sharebrained/portapack-hackrf/README.md

# portapack-hackrf

**NOTE: This original firmware for the PortaPack H1 was forked into the [Mayhem project](https://github.com/eried/portapack-mayhem), which is now far more interesting and active. I recommend you use that firmware for all your PortaPacking needs. This repository is hereby archived.**

The PortaPack H1 makes the [HackRF One software-defined radio](http://greatscottgadgets.com/hackrf/) portable. It adds an LCD touchscreen, user interface navigation controls, audio output and input, micro SD card slot, 2.5 PPM crystal oscillator, and real-time clock battery backup. The PortaPack firmware provides a user interface and necessary signal processing to do many useful things without a computer.

Visit the [wiki](https://github.com/sharebrained/portapack-hackrf/wiki) for more details.

Hardware was once available from [ShareBrained Technology](http://sharebrained.com/). But now there are many manufacturers, vendors, and variations of this open-source hardware. I have not used any of them myself, so can't offer any specific recommendations.

PortaPack H1 in operation
PortaPack H1 kit components

# License

Except where specified in subdirectories of this project, all work is offered under the following license:

Copyright (C) 2013-2019 Jared Boone, ShareBrained Technology, Inc.

This program is free software; you can redistribute it and/or
modify it under the terms of the GNU General Public License
as published by the Free Software Foundation; either version 2
of the License, or (at your option) any later version.

This program is distributed in the hope that it will be useful,
but WITHOUT ANY WARRANTY; without even the implied warranty of
MERCHANTABILITY or FITNESS FOR A PARTICULAR PURPOSE.  See the
GNU General Public License for more details.

You should have received a copy of the GNU General Public License
along with this program; if not, write to the Free Software
Foundation, Inc., 51 Franklin Street, Fifth Floor, Boston, MA
02110-1301, USA.

# Contact

Jared Boone <jared@sharebrained.com>

ShareBrained Technology, Inc.

<http://www.sharebrained.com/>

The latest version of this repository can be found at
https://github.com/sharebrained/portapack-hackrf/
