sharebrained/portapack-hackrf/(threads)

Thread 10 (2015-07-08):

Retain settings when power is disconnected

jboone, 2015-07-08:
Write data to RTC battery backed RAM (simple but limited storage), or to SD card (not so simple, risky).

jboone, 2015-07-09:
Of course, there may be no SD card, it may be non-functional, or ejected at any time. So solving the problem with the RTC RAM is preferred, even though it's tiny (8Kbytes, I believe).

aernan, 2015-08-02:
oh. whoops.

jboone, 2015-08-24:
Lesson learned: there's only 256 *bytes* of RAM ("REGFILE") at 0x40041000, as part of the RTC peripheral, that is maintained when power is removed from the PortaPack. Still, that's plenty to store important state, if done carefully.

jboone, 2015-08-24:
Code to use RTC REGFILE for tuning frequency and PPM value seems to be working well. Closed, though the implementation could use improvement, e.g. versioning the persistent data and clearing or migrating the data when the version ID is incremented.

Closed 2015-08-24.

Thread 2 (2015-07-08):

Improve firmware update experience

jboone, 2015-07-08:
Especially for Windows, but other platforms could use more love, too.

KC5CQW, 2015-08-26:
Not much luck here compiling from src on OS X...

jboone, 2015-08-26:
Can you provide details? I am developing on OS X 10.10.5, so it *should* work just fine.

KC5CQW, 2015-08-26:
I couldn't get the ARM compiler to instal on my X.9 system.

jboone, 2015-08-26:
OK, moving this to new issue #60. Please follow up with more details there.

jboone, 2015-09-03:
HackRF Mode in the new firmware will help a bit with this, eliminating the need for DFU mode except in dire circumstances where the firmware on the device is non-functional.

jboone, 2015-10-22:
[Windows firmware tool](https://github.com/sharebrained/portapack-hackrf/wiki/Updating%20Firmware%20Windows) is now available.

Closed 2015-10-22.

Thread 3 (2015-07-08):

Fix MAX2837 RSSI sampling

jboone, 2015-07-08:
It seems I broke the MAX2837 RSSI sampling by the LPC4320 ADC.

Closed 2015-07-08.

Thread 4 (2015-07-08):

Add touch screen calibration

jboone, 2015-07-08:
During manufacturing, touch screens seem pretty consistent (don't need calibration), but PortaPacks might "feel" better to use if the touch screen was precisely calibrated.

KC5CQW, 2016-05-18:
This would be needed if stylus or gesture support is implemented some day. Perhaps some type of scalable waterfall zoom.

jboone, 2016-07-28:
Implemented in commit 24fa97439d7ca9524f892e5b41996d3a39695649.

Jean-france, 2020-02-02:
Hi,
I have HAVOC firmware  on my HK. The touch screen doesn't work. Impossible to calibrate it, nothing do even i touch the screen.
Do you have a idea ?
Many thanks in advance.
Best regards,
Jean

Closed 2016-07-28.

Thread 5 (2015-07-08):

Improve power consumption

jboone, 2015-07-08:
Review LPC4320 peripherals and clocks that can be shut down because they aren't in use.
Check that peripherals are turned off if they're not used for a while (e.g. SD card).
Review ChibiOS code, ensure LPC4320 cores are sleeping when they can.
Align interrupts, threads to reduce the number of interrupts. Particularly on the baseband processor, where RSSI/touch sampling blocks can be aligned with baseband sampling. This will also help align timestamps between RSSI and baseband sample.

JDogHerman, 2015-08-06:
Would it be possible to turn off the backlight of for the screen to save power?

KC5CQW, 2015-08-06:
And maybe a dim adjustment feature for when full brightness is not needed.

jboone, 2016-01-28:
Added display sleep mode, which drops power by 60-70mA measured the 5V USB input. Lots more possibilities, including stopping spectrum calculation and various baseband/RSSI/audio/process stats, which is wasted effort when display is not on.

Thread 6 (2015-07-08):

Wideband spectrum analysis

jboone, 2015-07-08:
Add mode to sweep the radio across a frequency range, capture baseband, either FFT or calculate average/peak power, and record/display.

aernan, 2015-08-02:
Would be excellent to use device like a scanner. Search across a very wide band to find signals. Would be fine if single pass simple drew a DB to frequency graph.

jboone, 2015-08-27:
Addressed as of commit 3fea68d777c553b9523cbae41d89160ce428c676. For now, a separate receiver mode. Will refine as time goes on.

Closed 2015-08-27.

Thread 7 (2015-07-08):

Digital modes

jboone, 2015-07-08:
Break out digital demodulation/decoding into a separate mode?

aernan, 2015-08-02:
I could see workflow of scanning bands to find a signal. Zooming in to see the signal then attempting different demodulation techniques. If you can't easily demodulate then capture for offline demodulation.

jboone, 2015-08-02:
aernan: That's exactly what I was hoping to accomplish. Right now, I'm imagining a zoom button that would toggle between channel bandwidth and maximum (20MHz) bandwidth. Demodulation would be suspended and audio muted during the 20MHz mode, while you identify a signal of interest and retune for it. Then, you'd zoom back in to the channel and demodulation/audio would resume.

aernan, 2015-08-02:
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
That sounds perfect. I would totally eat that up.

KC5CQW, 2015-08-05:
Clarification; is digital demodulation to take place "off-board"? This would indeed be quite taxing and processor intensive for local display...
Yes, I would also utilize the zoom/tune feature.
Hmm, that gives me an idea... What about an Auto Frequency Correction with a marker icon or +/- Hz/kHz delta for tracking a drifting signal? This would be focused on the carrier or peak amplitude components of the signal.

aernan, 2015-08-06:
To clarify. I'm guessing some forms of digital signals are too complex to demodulate on the portapack. Things like GSM and Wifi. So if you can't (due to horsepower) then make it easy to capture them so you can then use another host (desktop/laptop) to do the heavy lifting. For everything else do best effort to demodulate on the portapack.

JDogHerman, 2015-08-06:
It would be nice to have a decoder of some basic digital modes on-board. DTMF, RTTY, CW, PSK31

JDogHerman, 2015-08-06:
Or maybe decode WFM HD RDM signals.

KC5CQW, 2015-08-06:
Being Linux based, I wonder if the HackRF/PP H1 could utilize some of the fldigi source.
http://www.w1hkj.com/usercontrib/FLDG-2013-10-01-2111.zip

jboone, 2016-07-05:
@KC5CQW You're no doubt aware of this by now, but the HackRF and PortaPack are not capable of running Linux -- there's far too little RAM (200K) to consider such a thing.

jboone, 2016-07-05:
This issue wound up becoming very broad. Moved digital mode ideas to issue #89. Zoom out idea moved to issue #90. Spectrum peak marker moved to issue #91.

Closed 2016-07-05.

Thread 8 (2015-07-08):

Implement internal temperature monitoring

jboone, 2015-07-08:

aernan, 2015-08-02:
Do I need to put a heatsink/fan on the HackRF or the Portapack chips?

jboone, 2015-08-02:
No, this temperature monitoring is intended to automatically compensate for crystal reference frequency drift as the radio hardware warms up.

aernan, 2015-08-02:
ok excellent. That’s a good heads up before I leave the unit on for any time.

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

jboone, 2016-01-05:
Temperature monitoring is now functioning. Will need further UI and supporting code to automatically adjust crystal reference frequency PPM offset based on current temperature.

Part of the problem is that temperature resolution is poor, so it's hard to interpolate values and make smooth PPM adjustments.

KC5CQW, 2016-02-03:
Where is the sensor? No joy if it's inside the CPU and not near the LO.
It might be necessary to epoxy a thermistor to the xtal body and feed the leads into a pair of unused GPIO holes. One of the glass-bodied, high resolution types used in 3D printer hot ends would work well here. These are very well documented for linearizing the output of the thermistor within code for accuracy. Fine wire soldering and polymeric application will be required...

Additionally, if an external reference signal is applied, this temperature compensation MUST be ignored.

jboone, 2016-02-03:
@KC5CQW The sensor is located in the MAX2837, the second IF chip. It's not an ideal location, but with the thermal mass of the circuit board, it seems to track OK. What doesn't work so well is that the MAX2837 temperature sensor has a resolution of 5C. This is barely enough to compensate for drift, so I'm unsure if it's actually worth completing the feature, or if I should just expect the user to manually calibrate PPM for when the unit is warmed up, which is what I'm doing now.

You're welcome to modify your hardware however you like. I fear almost nobody else will undertake such a modification. So I'm going to focus on doing it right in the next revision of the PortaPack. :-)

KC5CQW, 2016-02-03:
Nah, i'm good. I built a GPSDO for the clock input when high precision is needed. From what I've seen, the screen resolution is too coarse to resolve such small deviation. A better option would be to manually adjust the PPM then activate an AFC algorithm to track the RX carrier to compensate for minor fluctuations.
A new revision?! Dang, this is going to get expensive... I have a hard enough time justifying my R/C helicopter habit to my wife.

jboone, 2016-02-03:
@KC5CQW I definitely need AFC to improve sensitivity to signals transmitted significantly offset from my LO. This is particularly important for TPMS, where transmitters are very cheap and in an environment where temperatures vary widely, from -20C to 50C or more. But first thing's first.

And don't worry about a new revision. It'd be a whole new thing, and it's a long way off still -- I'd be amazed if I had anything together in a year.

KC5CQW, 2016-02-06:
I have an idea... What about a simple, small thermal health status indicator using this "rough" data. Perhaps just one or two pixels in a corner that changes color. Blue for cold, green for room(ish) temp and red for way too hot. Maybe a hysteresis of 10's of degrees for averaging.

73, Damon

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

jboone, 2016-02-17:
@KC5CQW The thermal sensor is located in the second IF chip and is purely about calibration. The sensor is not positioned or designed for monitoring system faults or throttling, unlike laptop/desktop processors. Besides, if the HackRF + PortaPack experienced a fault that produced considerable excess heat, either the onboard switching regulator or the USB power source would enter current limiting.

In a different system design, having CPU core temperatures would be useful, as would a thermal sensor with much more accuracy, co-located with the reference crystal/oscillator. Or, dispense with the thermal sensor and use a more accurate (<1ppm) crystal to begin with...

jboone, 2016-07-28:
After a few months of observation, I've concluded the temperature resolution of the MAX2837 is simply too coarse to implement automatic reference frequency compensation. Aggressive filtering of the coarse signal would still cause laggy and large swings in PPM offset, and would be worse than just leaving it manual. In practice, I find a PPM offset for each HackRF and leave it, as once a unit is warmed up (a few minutes), the PPM value is quite stable.

sck-nogas, 2016-07-28:
I know that I can use the Receiver mode to help tun the PPM offset, but I have not been able to identify much/any drift using WFM. So, as my dumb question of the day, should we only use NFM or AM to tune this?

jboone, 2016-07-28:
You won't see the offset in WFM mode, unless it's severe (and your HackRF crystal reference is way out of specification). Broadcast FM analog signals are ~260kHz wide, and the carrier is typically around 100 MHz. At 100 MHz, a 10 ppm offset would be 1 kHz, which would be very hard to see in the nearly 400 kHz WFM spectrum waterfall. A 1 kHz offset on such a wide signal is unlikely to affect demodulation significantly, so you wouldn't hear the effect, either.

NFM or AM is much better, as the signal and displayed bandwidth are far narrower, and it'll be easier to make fine adjustments. I usually adjust PPM whenever I see a need, and it's usually the same value, +/- 1 ppm, unless the transmitter I'm observing is very sloppy.

KC5CQW, 2016-07-28:
Would it be possible to add a "relative" 0 setting to the PPM once a HRF has thermally stabilized and compared to a freq. standard? For example, at 25C, +/- ~30deg. my HRF is -7PPM. I would like to set this value as a relative "0" to monitor when a recalibration is necessary and to perform frequency measurements.
This is useful for when I am unable to sync with my 10MHz master clock back in the lab when going portable.
73, Damon

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

KC5CQW, 2016-07-28:
Only an idle FM carrier will be on the target frequency. That means no modulation. CW is best then AM or LSB/USB for comparison.
Use of a NWS/NOAA broadcast in nFM is useful between modulated words.

73, Damon

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

sck-nogas, 2016-07-29:
Thanks!

Using NFM (after warming up for 10-15 mins of listening to the broadcast), I set my PPM to 11.

"Well, it's one louder, isn't it? It's not ten. You see, most blokes, you know, will be SDRing at ten. You're on ten here, all the way up, all the way up, all the way up, you're on ten on your HackRF. Where can you go from there? Where?... Eleven?" :)

http://www.imdb.com/title/tt0088258/quotes?item=qt0261726

jboone, 2016-07-29:
@sck-nogas I appreciate starting my day with a little 'Tap. Thanks. :-)

I am curious to know if a PPM offset of +11 continues to work well for you, as it is a bit out of spec in my experience. What kind of transmission did you calibrate to? Depending, the transmitter may not be very precise...

jboone, 2016-07-29:
@KC5CQW I like the idea... I've felt funny adjusting the PPM from within the receiver, like that's not really the place for it. However, I've also liked having that adjustment to fine-tune for a specific transmission.

So perhaps we rename the "PPM" inside the receiver mode to be "Fine", and if you press "select" on that value, you can update the global PPM value with the current "Fine" offset (and the Fine offset resets to 0). So perhaps we can have our cake (set PPM from receiver mode, where it's easiest), and eat it too (fine adjust the tuned frequency without messing up the global PPM value).

sck-nogas, 2016-07-29:
@jboone You are MOST welcome. Am loving the Portapack!

For the tuning of the PPM, I followed @KC5CQW 's suggestion and used the two closest (both about 10 miles LOS) NWS NOAA stations [KEC62](http://www.nws.noaa.gov/nwr/coverage/site2.php?State=CA&Site=KEC62) and [WNG637](http://www.nws.noaa.gov/nwr/coverage/site2.php?State=CA&Site=WNG637) to my house. Then using the PPM adjuster in Receiver mode, I changed the setting until the red carrier line (observable when there was no audio transmitted) was centered.

I then jumped around to a [few other NFM stations](http://www.radioreference.com/apps/db/?ctid=219)  to make sure they all were equally centered on carrier.

Thread 9 (2015-07-08):

Adjustment of tuned frequency based on oscillator drift

jboone, 2015-07-08:
The Si5351C-B oscillator will drift in frequency in a temperature-dependent manner. Take advantage of temperature measurement(s) available on the HackRF to adjust tuning frequency based on adjustment table of PPM vs. temperature. Update tuning frequency only if PPM value changes appreciably.

jboone, 2015-07-09:
First step would be to plumb the code for a static PPM, assuming the user will want the correction to be in effect once the hardware has warmed up.

Of course, until issue #10 is addressed, you'll need to re-enter the PPM value every time you power up. :-(

jboone, 2015-07-29:
Addressed in commit 67976b73bada3069038cc093f2d962631154dd99.

Closed 2015-07-29.

Thread 13 (2015-07-09):

Fix receiver mode frequency scale bars.

jboone, 2015-07-09:
They appear to be the wrong scale to depict the channel filter band edges.

jboone, 2015-07-20:
Confirmed correct scale with a signal generator.

Closed 2015-07-20.

Thread 14 (2015-07-09):

Label receiver waterfall frequency scale.

jboone, 2015-07-09:
Groundwork is laid, but need to finish the implementation.

jboone, 2015-07-21:
Resolved in commit 9a8552eaeb6a4516f2b708cf8219d41dce8e61d7.

Closed 2015-07-21.

Thread 19 (2015-07-09):

Indicate baseband saturation somehow

jboone, 2015-07-09:
Feedback on bad gain structure is always handy. Previously, I was using the red LED, but took that code out. This needs further/better thought.

The baseband code should be reviewed to see if saturation is flagged at all possible places. I feel like it's not...

KC5CQW, 2015-08-05:
Perhaps a rapid (4-5) PPS flash on the RX LED to indicate overloaded gain stages...?

KC5CQW, 2015-10-25:
I suppose blinking the LED associated with the overdriven 'stage' (TX/RX) is the proper method to avoid confusion. However... My understanding is that the USB LED is inert during PP H1 use. Perhaps it could be a general fault light.

Thread 27 (2015-07-26):

Establish version/release schedule, naming convention, location for binaries, etc.

jboone, 2015-07-26:
You know, proper build and release engineering...

ZeroChaos-, 2015-07-27:
suggestion:  two scripts that handle the firmware loading for the user.  "switch_to_portapack" and "switch_to_hackrf" would be naming suggestions.

ZeroChaos-, 2015-07-27:
suggestion: name your firmware with "portapack" in the title and install into /usr/share/hackrf just like the standard firmware, this gives users one location to search for firmware.

ZeroChaos-, 2015-07-27:
suggestion: use XZ instead of bz2, although for such small files it almost doesn't matter, but on principle XZ is vastly superior

ZeroChaos-, 2015-07-30:
for the scripts, I'm thinking something like this:

#!/bin/sh
dfu-util --device 1fc9:000c --download /usr/share/hackrf/hackrf_one_usb_ram.dfu --reset
hackrf_spiflash -w /usr/share/hackrf/portapack-h1-firmware.bin

#!/bin/sh
dfu-util --device 1fc9:000c --download /usr/share/hackrf/hackrf_one_usb_ram.dfu --reset
hackrf_spiflash -w /usr/share/hackrf/hackrf_one_usb_rom_to_ram.bin

I'm also thinking you need to rename your "hackrf_one_usb_ram.dfu" to something else unless it is the same as the file shipped by hackrf (in which case, stop shipping it at all).  Suggested name would be "portapack-h1_usb_ram_dfu" if it is different.

ZeroChaos-, 2015-07-30:
per discussion on irc, the hackrf_one_usb_ram.dfu is the same as shipped with hackrf and is shipped to make switching to portapack as simple as possible.

jboone, 2015-07-30:
Yep. If hackrf_one_usb_ram.dfu is already present on the system (packaged), feel free to use that copy. In fact, that's preferable to me. Including the .dfu is a shortcut for now, to make sure that you have everything necessary (aside from dfu-util and hackrf_spiflash) when you clone the repo.

jboone, 2015-07-30:
The scripts will work if dfu-util 0.7 is on the system. dfu-util 0.8 has some changes which have broken things. This needs to be addressed, but not right now. Issue #24 tracks that, as well as issue mossmann/hackrf#117.

jboone, 2015-07-30:
I do recall one issue with using the commands as shown in the scripts. The HackRF needs a bit of time to re-enumerate with the operating system after the dfu-util has finished. I would recommend a "sleep 1s" between dfu-util and hackrf_spiflash, to give the HackRF time to show up as a HackRF.

ZeroChaos-, 2015-07-30:
for this second, to make sure that I can push this to users soon, I'm going to leave the scripts with no real error handling and get them into gentoo.  later we can add some ugly checks like "dfu-util -V | head -n1 | awk '{print $2}'" to check dfu-util version and change args if needed, as well as possibly parsing lsusb to determine if the hackrf is even present at runtime.

jboone, 2015-07-30:
Huh, interesting. In my Makefile, I do not specify the product ID, just "--device 1fc9". The product ID in your scripts are correct and work and are more explicit.

jboone, 2015-07-31:
Instructions for entering DFU mode:
"Hold down the HackRF's DFU button (the button closest to the antenna jack) and plug the HackRF into a USB port on your computer. After the HackRF is plugged in, you may release the DFU button."

Thread 31 (2015-07-28):

Address mechanical incompatibility with HackRF Blue

jboone, 2015-07-28:

KC5CQW, 2015-08-06:
Mounting holes and/or header socket alignment constancy.
The socket variable is likely due to solder surface tension pulling the socket mass to equilibrium during reflow process.

jboone, 2015-08-06:
@KC5CQW I'm not sure if you're commenting on a separate issue, or sharing ideas for this issue. This issue relates to the (optional) presence of a header on the HackRF Blue that is not present on the HackRF One. Two electrolytic capacitors on the PortaPack H1 mechanically interfere with the HackRF Blue header. It is not related to the 0.1" SMT headers on the PortaPack, as they utilize alignment pins, and should be positioned to within a few mils of nominal.

KC5CQW, 2015-08-06:
Just sharing ideas... However, based on your input, I can say that by adding three washers in addition to the standoffs cured this problem for me. Enough of the pin length remained to make good contact within the socket headers. With the washers on hand and applied, I have about 0.2-0.4mm (estimated) clearance from the caps.
I own an "official" HackRF but added the P30 header as provided by Nooelec with the RF shield kit.
Sadly, it is not accessible with the H1 mounted. As an option, I suppose a right angled header would cure this. I forgot about the alignment pins... Good call using them in the design!

BTW, i know squat about software but RF hardware test/tune/calibration is my chosen Voo-Doo.
My wife and I are the PCB assemblers for the AMSAT FOX-1 series cubsats. My hope is to use the HackRF for post assembly smoke testing prior to shipping out the hardware for "real" tests and flight integration.

KC5CQW, 2015-09-05:
When the P30 header is installed (OEM or Blue), an additional 2.35mm of clearance is needed for a total of 14.25mm. I used 15 4-40UNC flat washers (3 on each screw) to provide the additional clearance between PCB's for the caps to clear the header. This setup WILL block access to the P30 header.
The other option is [for the end user] to source 2 ribbon cables 11 pin (P16) & 13 pin (P22) with one end male , the other female and >1" (25mm) long to allow for an offset mounting configuration between PCB's.

Thread 32 (2015-07-29):

Focus manager has ugly corner cases.

jboone, 2015-07-29:
argilo found a case where moving right from one field to another, both inhabiting the same vertical coordinate range, causes focus to move to the "nearest" field, which is *above* the original field!

jboone, 2015-08-24:
Short-term fix seems to be working nicely, so I'm closing this until some new issue arises.

Closed 2015-08-24.

Thread 33 (2015-07-29):

Means to adjust receiver channel bandwidth

jboone, 2015-07-29:
Should be easy enough to re-assign the FIR taps.
Adjust spectrum samples decimation factor to make sure aliasing is minimized.

aernan, 2015-08-02:
I could see this being like a zoom in out on the screen feature.

aernan, 2015-08-06:
You can adjust the squelch and receive bandwidth in this app.
android app RF Analyzer https://play.google.com/store/apps/details?id=com.mantz_it.rfanalyzer
probably do something similar.

jboone, 2016-01-05:
Plumbing is there as of commit 28be223ace91d6bac55dc468789ffa0de57904c4. (It took until this commit to get something that was compilable, due to a merge-oops.)

jboone, 2016-02-06:
NBFM channel filter can be varied between 8.5kHz, 11kHz, and 16kHz widths, with attendant adjustments to deviation (2.5 or 5k), as of commit ceef8d32d3b5da9a4faf7b98cad7ae677c63a600.

KC5CQW, 2016-05-05:
Please explain the deviation adjustments. Is this automatic or user variable?

jboone, 2016-07-05:
Closing this and continuing work on channel bandwidth adjustment for CW/AM/SSB via issue #86.

Closed 2016-07-05.

Thread 43 (2015-08-02):

Scrolling shows new row of pixels at bottom of region.

jboone, 2015-08-02:

jboone, 2015-08-11:
Shows many rows of pixels if scrolling many rows per LCD frame period. Stopgap solution is to paint after scroll, which hides the problem, but doesn't really address it. Correct solution is to defer painting scroll region until TE pulse (vertical retrace). But that requires memory to queue the work until TE. Ugh.

jboone, 2016-01-28:
Addressed by buffering spectrum data for rendering when frame sync comes from LCD panel.

Closed 2016-01-28.

Thread 44 (2015-08-02):

UI - make unit recall last tuned frequency on power on

aernan, 2015-08-02:
unit seems to always go to 858.7520. Please make it tune to the mode and frequency last used or add functionality to save/recall current tune settings.

jboone, 2015-08-02:
Duplicate of issue #10.

Closed 2015-08-02.

Thread 47 (2015-08-03):

switch_to_portapack dfu-util output

ZeroChaos-, 2015-08-03:
gato ~ # switch_to_portapack
Hold down the HackRF's DFU button (the button closest to the antenna jack)
then plug the HackRF into a USB port on your computer.
After the HackRF is plugged in, you may release the DFU button.
Press any key to continue or ^c to abort

dfu-util 0.7

Copyright 2005-2008 Weston Schmidt, Harald Welte and OpenMoko Inc.
Copyright 2010-2012 Tormod Volden and Stefan Schmidt
This program is Free Software and has ABSOLUTELY NO WARRANTY
Please report bugs to dfu-util@lists.gnumonks.org

Filter on vendor = 0x1fc9 product = 0x000c
Opening DFU capable USB device... ID 1fc9:000c
Run-time device DFU version 0100
Claiming USB DFU Runtime Interface...
Determining device status: state = dfuIDLE, status = 0
WARNING: Runtime device already in DFU state ?!?
Found Runtime: [1fc9:000c] devnum=0, cfg=1, intf=0, alt=0, name="DFU"
Claiming USB DFU Interface...
Setting Alternate Setting #0 ...
Determining device status: state = dfuIDLE, status = 0
dfuIDLE, continuing
DFU mode device DFU version 0100
Device returned transfer size 2048
DFU CRC does not match
Warning: File has no DFU suffix
bytes_per_hash=409
Copying data from PC to DFU device
Starting download: [##################################################] finished!
unable to read DFU status
can't detach
Resetting USB to switch back to runtime mode
error resetting after download
File size 207564 bytes.
Erasing SPI flash.
Writing 207564 bytes at 0x000000.

This is what it looks like when I run the switch_to_portapack script.
I really don't like this bit:
unable to read DFU status
can't detach
Resetting USB to switch back to runtime mode
error resetting after download

That said, both scripts seem to work flawlessly anyway.  Is this normal or something we need to consider improving?

jboone, 2015-08-03:
It's normal *and* something we need to improve. It's noise from dfu-util that doesn't actually impact the process. Also, the barfing of hundreds of "Writing XXXXXX bytes at 0xYYYYYYY" is something that will be silenced by default when my HackRF patch is accepted.

ZeroChaos-, 2015-08-03:
Would you perhaps like to silence the dfu-util output in the scripts?  I can run some tests silencing stderr or everything and make it less ugly by just reading error codes possibly.

jboone, 2015-08-04:
@ZeroChaos- Please do. I don't see any command line options for dfu-util to silence the noise, so it will no doubt require some dirty tricks.

Thread 50 (2015-08-07):

Hardware: alternative case proposal

dc1rdb, 2015-08-07:
Alternative case, based on the original HackRF plastic enclosure. The bottom half of the case could be reused. Just the top half of the plastic enclosure would need to be replaced by a version with extended side walls and cut-outs at the top for display and navigation control, plus additional hole for headphone jack and slot for SD-card.

jboone, 2015-08-07:
@dc1rdb That's a great idea. However, I'm not much of a fan of plastic cases, and the cost of getting injection molding set up is vastly higher than I can afford.

But with 3D printers everywhere, perhaps a printable model could be made, based on your idea. If somebody wants to tackle that before I get to it, I highly recommend both OpenSCAD and FreeCAD. I have OpenSCAD models of the PortaPack and HackRF boards in the repo already that could be used to validate the positions of holes, edges, etc. I'm not sure if I posted my FreeCAD files yet...

KC5CQW, 2015-08-07:
Sadly, the nature of this hardware [almost certainly] requires a metallic case for EMI mitigation. Such is the nature of RF.
It would be possible to print a case then line it with foil tape as an alternative with "limited" success.

For those not critical of EMI, or as a stop-gap measure, a printable case is a great idea to protect this valuable hardware. Personally, I would be willing to act as a beta tester and print one out if provided an .stl file. I am unable to commit to drafting a model at this time due to other obligations.

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

ne1, 2015-08-22:
I have done a case, but i have to redesign it a little bit, to make it fits better. I will upload it on monday.
I can send these to somebody, if anyone needs it.

ne1, 2015-08-25:
Hi, sorry it takes a little longer and there is still room to improve this model, here is one of my test cases:

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

You can get it here:
http://www.thingiverse.com/thing:983995

dc1rdb, 2015-08-26:
This is looking great! Regarding KC5CQWs concerns about RF shielding, this could be addressed by covering the inside with conductive graphite spray paint.

ne1, 2015-08-26:
Thanks! If anybody interested: i can print and send it for just the shipping costs :) (sitting in Germany)

This spray should not touch the bottom side of the hackrf, correct? This could be possible in the actual design.
But i can give a try. Is aluminium foil a suitable alternative?

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

KC5CQW, 2015-09-05:
Add 2.35mm between the HackRF's button and SMA holes and the PortaPack's face to the case design to allow for 14.25mm spacers when a HackRF Blue or HackRF with the P30 header is installed. Generate a second set of STL's for this optional configuration.

ablanquart, 2016-01-24:
If enough people are interested, I may be able to have this made in metal. I'll see if I can run a "sample" using ne1's thingiverse file.

ne1, 2016-01-24:
I can send you my FreeCad File if you like!?

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

ablanquart, 2016-01-26:
Absolutely, please send! Not sure if you can convert or make easily - but a
.dxf or a .dwg file would be better.  I think I can work with the STL and
FreeCAD files though.

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

--
ADAM BLANQUART | ablanquart@gmail.com |

ne1, 2016-01-26:
Hi,

here is the file - i hope it can help.

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

Thread 52 (2015-08-07):

add step size for WFM 0.3 MHz

aernan, 2015-08-07:
FM radio stations are 0.3 MHz apart. Please add a new step size when in WFM mode.

KC5CQW, 2015-08-07:
But!, keep the other step sizes as well.
WFM is also used for other modes like NOAA WxFAX reception and it requires Doppler correction to keep clean image clean. In fact, all modes would benefit from 10M, 5M, 1M, 100k, 10k, 9k, 3k, 1k, 100H, 10H and 1H (for drift measurements when a clock standard is used on PLL1).

KC5CQW, 2015-08-07:
I ment "Hz" not "H(enry's)".
...cps is what I prefer over Hz myself...

jboone, 2015-08-29:
You should note that the step size is a completely independent parameter from the demodulation mode. So you can use 10MHz steps with AM or NBFM, and 100Hz with WFM, and any other combination thereof.

My experience and all information I can find suggests that broadcast FM is spaced at multiples of 200kHz, and either even or odd tenths, depending on the country. See [Wikipedia](https://en.wikipedia.org/wiki/FM_broadcast_band) for more. Seems like the 100kHz mode should work well for this. If the concern is fast tuning between stations, I would recommend instead adding a memory/preset/favorite feature and tuning mode. Mark the FM stations, and then flit between them with a single click.

I'm interested in the justification for 9k and 3k. I definitely appreciate the Doppler correction, though I suggest checking out the PPM adjustment in the latest firmware. If PPM and Doppler are separate, I'd suggest having a separate Doppler adjustment. That way, you can tune to the desired center, corrected by the PPM value, and then tune up to where the anticipated Doppler shift will put the signal. In fact, Doppler could even be performed automatically, or in a guided fashion, eventually...

Regarding drift measurement, is this to characterize the internal crystal vs. an clock standard, or to characterize an RF signal against the clock standard?

KC5CQW, 2015-08-29:
Justification for 9k & 3k; same issue with WBFM 200kHz... bandwidth dependent tunning. 9kHz for AM broadcasts and 3kHz for SSB signals. Probably not worth the effort, just a thought as these ranges are avalible in other portable (consumer) RF devices. Being that these ranges are BW dependent by convention, it would be much more beneficial to focus on resolution instead. How low can we go? 10's of Hz? 100's of Hz?

PPM and Doppler are indeed separate!
As an example, Orbitron is a good program (among many others) for satellite prediction/tracking that calculates the Doppler shift and outputs serial data for tuning in real time.

PPM drift in the LO clock translates to internal stability of the hardware. Keep in mind that small amounts of drift can easily translate to 10's of kHz offset in the GHz region.
An external standard such as a GPSDO of 10MHz on the PLL1 input or a sync to a local GSM carrier (also timed via GPSDO at the tower site) can be utilized.
The nessesary program would characterize the internal clock drift by comparing it with a clock standard as the internal temperature varied. Setup would require the end user to perform a calibration procedure utilizing a means of thermal "ramping" over the expected environmental temp range so the internal temp sensor data and clock signal(s) data can be loaded into a lookup table. For instance, 60-90 Deg. F (or whatever) for inside/outside excursions. This would provide a better stability than no clock standard or raw hardware clock signal alone. Again, the drift in the GHz range can quickly become troublesome with just a few hz offset in the LO clock. This feature would provide a meaningful enhancement for the portable user in times where a reference clock is not feasible and thermal variance is an environmental fact that impacts clock xtal stability.

jboone, 2016-01-28:
The requested smaller steps (3k, 5k, 6.25k, 9k) were added in a recent commit and will be in the next firmware release. I had a harder time justifying the large steps (300k and 5M).

Closed 2016-01-28.

Thread 53 (2015-08-09):

Flashing error

holiman, 2015-08-09:
I get this error when trying to flash the portapack firmware:

	#sudo dfu-util --device 1fc9:000c --download hackrf_one_usb_ram.dfu --reset
	dfu-util 0.5

	(C) 2005-2008 by Weston Schmidt, Harald Welte and OpenMoko Inc.
	(C) 2010-2011 Tormod Volden (DfuSe support)
	This program is Free Software and has ABSOLUTELY NO WARRANTY

	dfu-util does currently only support DFU version 1.0

	Filter on vendor = 0x1fc9 product = 0x000c
	Opening DFU USB device... ID 1fc9:000c
	Run-time device DFU version 0100
	Claiming USB DFU Runtime Interface...
	Determining device status: state = dfuIDLE, status = 0
	WARNING: Runtime device already in DFU state ?!?
	Found Runtime: [1fc9:000c] devnum=0, cfg=1, intf=0, alt=0, name="DFU"
	Claiming USB DFU Interface...
	Setting Alternate Setting #0 ...
	Determining device status: state = dfuIDLE, status = 0
	dfuIDLE, continuing
	DFU mode device DFU version 0100
	Device returned transfer size 2048
	DFU CRC does not match
	Unsupported DFU file revision 0000

jboone, 2015-08-09:
dfu-utils must be version 0.7 or 0.8. I recommend 0.7, as it is the most extensively tested with HackRF.

I will update the documentation to be more specific.

Closed 2015-08-09.

Thread 55 (2015-08-17):

HackRF mode broken

jboone, 2015-08-17:
Between binary shared with a few about a week ago, and building from scratch (newer commits), it stopped working...

jboone, 2015-08-17:
A user tracked the problem to consecutive commits 66320c39d4fa62bd322c85734ab62fc627457caa or 4e0de9c4ad04758b5bd4393482e91996ad939186, which makes some sense. Clock configuration of the M4 is being frobbed differently starting there.

Looks like I have more shutdown work to do to provide the correct state for HackRF firmware to run. Chances are, the M0 code needs to reset or halt the M4 and change its clock source back to IRC.

jboone, 2015-08-17:
It appears to be the SysTick configuration in the M4's hal_lld_init(). Chances are, the SysTick interrupt is firing while I'm copying HackRF firmware over the top of the RAM where the SysTick interrupt code *was*. I should shut down the M4 more cooperatively -- probably by adding a M4->M0 message to ask it to quit, and waiting for an M4->M0 message confirming the mode change.

jboone, 2015-08-24:
Should be resolved in commit 11561659b4479636c62127fc477df82f5b3cf8e3.

splaspood, 2015-08-25:
I still seem to have a problem with this commit.    The code appears to build fine, I flash the device, but upon reset the LCD remains black.   I'll gladly provide whatever troubleshooting information you might need if you direct me in retrieving it for you.

jboone, 2015-08-25:
The LCD will remain black, as all PortaPack-related features are disabled when entering HackRF mode. Are you able to access your HackRF from the host computer, e.g. the hackrf_info command?

splaspood, 2015-08-25:
Maybe I misunderstood how HackRF mode is supposed to be enabled, I thought there was a menu option to enable/disable.

Currently, however, after flashing with the LCD dark (and upon a fresh USB connection) hackrf_info does not see the device.   It actually appears that my system does not see the device at all.  (lsusb does not show anything)

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

jboone, 2015-08-25:
OK, I think I understand. Are you using the latest commit on master (presently 8f326e2d8e4d515e0baee8d95d07f5fed0239b1b)? What is your build operating system and ARM GCC compiler version? And after building a binary, do you have other files in the firmware/ directory with these file sizes:

     20484 hackrf_one_usb_ram.dfu
     65536 hackrf_one_usb_ram_dfu_pad.bin

...and a binary with this *approximate* file size?

    342264 portapack-h1-firmware.bin

splaspood, 2015-08-25:
Yup, latest commit.   I can go back and compile faad4ea053b611cffced165865c873bee34e3255 with this setup seemingly fine.

gcc version 4.8.3 (4.8.3-18ubuntu2+12) on an Ubuntu 15.04 host  (installed from the distribution provided packages)

Regarding the after-build files.   The pad.bin is 0 bytes (certainly my problem) and the portapack-h1-firmware.bin is 276244 bytes.

-jwb

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

jboone, 2015-08-25:
Yep, the zero-byte file is definitely the problem. It will misalign the "application" image that runs on the M0 and runs the user interface. Earlier, I was using a dd trick to pad the HackRF firmware to 64K, and had this exact problem (see issue #42). So I changed approaches and thought I'd resolved it. Maybe I should just write an image-building script in Python and not try to shell my way out of the problem.

splaspood, 2015-08-25:
Bingo.   I manually used dd to create the pad as was done previously, then 'built' the image again.   Looks to be working properly now.

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

jboone, 2015-08-25:
Reclosing. The problem @splaspood was having were caused by a derivative of issue #42.

jboone, 2015-09-01:
Reopened. Sigh. However, I bisected and identified commit 7937ea7327a461646fb2b0808bd3ebed7f65d2e5 as the culprit. What's troubling me is I have NO idea why. But if I remove that "__DMB();" line on HEAD, HackRF mode works just fine. WTF?

Closed 2015-09-01.

Thread 58 (2015-08-24):

Initialize persistent RAM when RTC is initialized

jboone, 2015-08-24:
When PortaPack firmware is executed and the RTC or 32.768kHz oscillator is not initialized (due to VBAT voltage not present), the RTC is initialized to a default time. If this occurs, the RTC REGFILE data is invalid. This RAM provides PortaPack persistent memory, and should be initialized when the RTC and 32.768kHz oscillator are initialized. This will require exposing some sort of event or signal out of rtc_lld_init().

Thread 60 (2015-08-26):

OS X compiler installation issue.

jboone, 2015-08-26:

jboone, 2015-08-26:
@KC5CQW reports "I couldn't get the ARM compiler to instal on my X.9 system."

jboone, 2015-08-26:
@KC5CQW What package manager are you using to install the ARM compiler -- MacPorts or Homebrew or other? Or are you downloading the GCC-ARM toolchain binary from Launchpad? The more details you can provide, the more I can help.

KC5CQW, 2015-08-29:
Sorry, I was attempting to install the GCC-ARM tool chain but now my "free time" is occupied with school work. I will be monitoring the progress for this but not able to actively participate on this issue for now. Basically, the procedures don't jive with the actual software; couldn't install. I'll try again soon and clarify.

0ff, 2015-08-31:
For the record, I have no problems at all on OS X 10.10.5 using `gcc-arm-none-eabi-49` (https://github.com/px4/homebrew-px4/blob/master/gcc-arm-none-eabi-49.rb) installed via homebrew.

jboone, 2016-04-20:
Closing, as I've heard from many people who have had success -- and the ARM GCC compiler has iterated a few more releases since (now GCC 5.3).

Closed 2016-04-20.

Thread 63 (2015-09-05):

WFM waterfall

dc1rdb, 2015-09-05:
The list of fixed bugs for firmware 20150904 includes an item "WFM waterfall freezes". However, WFM waterfall does not seem to be implemented in that firmware version.

KC5CQW, 2015-09-05:
Omission could be the current "fix"(?).

jboone, 2016-01-05:
Fixed in commit dcb2c46c57841a010be07cc85d54a09ef2baf830.

KC5CQW, 2016-01-05:
This is the message when I try to download new FW:

PermanentRedirectThe bucket you are attempting to access must be addressed using the specified endpoint. Please send all future requests to this endpoint.portapack-h1-buildsportapack-h1-builds.s3.amazonaws.com75DF1398594921207J3pwvbYxhm6kEYq5BLZVkkQ/s4SxwaafsvicmggcnhWY1lLWiFr7GC1yOCXL3tznh2ruqxSzUU=

jboone, 2016-01-05:
Argh, yes, you have to modify the URL to change the "s3.amazonaws.com/portapack-h1-builds" bit to "portapack-h1-builds.s3.amazonaws.com". For example, use: https://portapack-h1-builds.s3.amazonaws.com/sharebrained/portapack-hackrf/42/42.1/firmware/portapack-h1-firmware-dcb2c46.zip

Closed 2016-01-05.

Thread 64 (2015-09-05):

PPM Menu location

KC5CQW, 2015-09-05:
Once the settings menu is implemented, migrate the PPM correction factor setting(s) over to regain screen real estate for other uses.

jboone, 2016-01-28:
There is now a PPM setting in the Setup menu. But I will also keep the PPM setting in the receiver frequency options "panel", as I find it very convenient to make small adjustments. Perhaps there's a better feature waiting to get out, though -- a "fine" control that doesn't require switching steps (which I find somewhat arduous).

I did condense the text next to the PPM field, from "Corr. ### PPM" to "### PPM". So a little real estate is reclaimed.

Closed 2016-01-28.

Thread 67 (2015-10-12):

Changing ppm offset in main menu doesn't take effect until changed on waterfall

r4v5, 2015-10-12:
Steps to reproduce:
* Power on the Portapack
* Wheel down to Setup -> Frequency Correction
* Change this value
* Back out to the main menu, start Receiver
* Observe that the waterfall hasn't changed to reflect the offset, but if you highlight the frequency it lists the new PPM value
* Select PPM value, rock left or right
* PPM now immediately jumps into effect

This happens on a portapack running aa733b1. The offset does get stored and persists across power-on/power-off, though, which is nice.

jboone, 2016-01-28:
Hmmm, I think I was able to reproduce this. Notes to myself for when I tackle this: PPM seems synchronized between receiver view and setup view. But actual tuned frequency is not altered after changing PPM in setup view -- returning to receiver view, signal still appears at offset seen before the PPM adjustment.

jboone, 2016-02-06:
I believe this is addressed in commit a9451c17b4ee18ddb7755b9111990a0b25ddeda9.

Closed 2016-02-06.

Thread 68 (2015-10-30):

unable to compile firmware ../common/lpc43xx_cpp.hpp:25:19: fatal error: cstdint: No such file or directory

mgdudas, 2015-10-30:
I'm unable to build the current firmware.

I get the following error:

In file included from main.cpp:25:0:
../common/lpc43xx_cpp.hpp:25:19: fatal error: cstdint: No such file or directory
 #include <cstdint>
                   ^
compilation terminated.
../chibios/os/ports/GCC/ARMCMx/rules.mk:165: recipe for target 'build/obj/main.o' failed
make[1]: *** [build/obj/main.o] Error 1
Makefile:69: recipe for target 'baseband/build/baseband.elf' failed
make: *** [baseband/build/baseband.elf] Error 2

This is after updating to the most recent src tree via git pull. I have also tried deleting everything and doing a new git fetch. I see the same problem.

Building on Ubuntu 15.10 AMD64 in case it matters.

jboone, 2015-11-02:
I'm curious how you installed your ARM GCC compiler. "cstdint" is a standard C++ header, so your error suggests to me not having the G++ portion of the GCC compiler suite installed.

mgdudas, 2015-11-02:
Hmm, well, I had installed everything on this machine quite some time ago, maybe at least 2 years from when I got my hackrf originally. The only thing I can think of would be that I updated to Ubuntu 15.10 since the last time I successfully built the firmware. So maybe something got screwed up there. In fact, it looks like https://launchpad.net/gcc-arm-embedded hasn't released updated tools for ubuntu 15.10, so that may be it. I'll try on another machine with a clean install. Thanks!

jboone, 2015-11-08:
After another report of this problem, I updated my Ubuntu to 15.10 and was able to reproduce with the simplest possible example, a single C++ source file: https://gist.github.com/jboone/8a7abbba27df442f011e

jboone, 2015-11-08:
Attempting to include other C++ standard header files (e.g. cstddef, memory, algorithm, string) yields the same error. Simplifying the compiler command line to remove -mcpu, -mthumb, --specs have no effect on the error.

jboone, 2015-11-08:
Further investigation compiling with "-v" option reveals that there's some mis-named directories in the Ubuntu package:

```text
gcc version 4.9.3 20150529 (prerelease) (15:4.9.3+svn227297-1)
COLLECT_GCC_OPTIONS='-mcpu=cortex-m4' '-mthumb' '-specs=nano.specs' '-std=c++11' '-v' '-o' 'test_cstdint.elf'
 /usr/lib/gcc/arm-none-eabi/4.9.3/cc1plus -quiet -v -imultilib armv7e-m -D__USES_INITFINI__ test_cstdint.cpp -quiet -dumpbase test_cstdint.cpp -mcpu=cortex-m4 -mthumb -auxbase test_cstdint -std=c++11 -version -o /tmp/ccFrI9pJ.s
GNU C++ (15:4.9.3+svn227297-1) version 4.9.3 20150529 (prerelease) (arm-none-eabi)
	compiled by GNU C version 5.2.1 20151003, GMP version 6.0.0, MPFR version 3.1.3, MPC version 1.0.3
GGC heuristics: --param ggc-min-expand=100 --param ggc-min-heapsize=131072
ignoring nonexistent directory "/usr/lib/gcc/arm-none-eabi/4.9.3/../../../arm-none-eabi/include/c++/4.9.3"
ignoring nonexistent directory "/usr/lib/gcc/arm-none-eabi/4.9.3/../../../arm-none-eabi/include/c++/4.9.3/arm-none-eabi/armv7e-m"
ignoring nonexistent directory "/usr/lib/gcc/arm-none-eabi/4.9.3/../../../arm-none-eabi/include/c++/4.9.3/backward"
ignoring nonexistent directory "/usr/lib/gcc/arm-none-eabi/4.9.3/../../../arm-none-eabi/sys-include"
#include "..." search starts here:
#include <...> search starts here:
 /usr/lib/gcc/arm-none-eabi/4.9.3/include
 /usr/lib/gcc/arm-none-eabi/4.9.3/include-fixed
 /usr/lib/gcc/arm-none-eabi/4.9.3/../../../arm-none-eabi/include
End of search list.
```

If I perform these steps, it appears to address the issue:

```bash
cd /usr/lib/arm-none-eabi/include/c++
sudo ln -s 4.9 4.9.3
```

It seems to me this is an Ubuntu or GCC bug.

mgdudas, 2015-11-09:
Hi,

Yep, that fixed it. Thanks for your help!

havronl, 2019-03-23:
I now have the same problem... Looks like versioning issues.  I am not a skilled compiler.  Can some give me the command to run compiler with -v option so I can see what needs to be linked?

Closed 2015-11-08.

Thread 69 (2015-11-23):

Spec. Mode Waterfall Speed

KC5CQW, 2015-11-23:
The waterfall scroll speed is too fast for manually tuning onto a signal once the transmission ends. This was not an issue in the September release.

jboone, 2015-11-23:
Yes, this is a behavior in unreleased firmware. The waterfall will return to normal scroll rate once I can reclaim enough code (.text) section RAM to add back the window-presum-FFT window to the spectrum calculations.

Longer term, the scroll rate, averaging, etc. will be controllable. But that's tough to achieve right now in the 32K of available baseband processor RAM...

KC5CQW, 2015-11-23:
Ahh, thanks for the explanation!

jboone, 2016-01-05:
Speed is addressed in current (but unreleased) firmware. Update rate is now ~75Hz, which might still be a bit faster than ideal. I should open a new issue about adding configurable spectrum scroll rate.

Closed 2016-01-05.

Thread 70 (2015-11-23):

TPMS & AIS Frequencies

KC5CQW, 2015-11-23:
When selecting the TPMS or AIS demodulator modes, automatically set the frequency to the most likely (expected) value. This is to expedite reception by tuning the used frequency per the selected mode for us "lazy folks" that do not know the frequencies by heart.

 Examples:  marine AIS is performed on 87B (161.975 MHz) and/or 88B (162.025 MHz) GMSK. Some method of locking onto the active channel or manual selection of CH87 or CH88 will be needed once the AIS mode is selected.

 315MHz (or 434 for Europe) for TPMS may be "ball parked" and then manually fine tuned by the user to account for TX variances. (Unless they are generally right on 315MHz or the RX bandwidth and demodulator can allow for some spread).

jboone, 2015-11-23:
The TPMS and AIS features are still half-baked. Maybe more like quarter-baked. Hence they're not yet in an official release. Limiting the tuning is definitely in the cards, though my preference would be to break these functions into entirely separate "applications", perhaps accessible under another top-level menu (not "Receiver"). Maybe "Digital Modes" (sounds too much like PSK31, APRS, WSPR, etc., though...) or something transportation-themed (maybe "Transponders"?). This would permit more extensive message decoding than the Receiver UI would comfortably allow. Something more like Kismet, where the N most recent transmissions are kept in a list, and details about each can be viewed full-screen...

jboone, 2015-11-23:
...and another justification for a separate application. For AIS, I think it's quite possible to decode both channels simultaneously, so no tuning (other than fine/PPM) required. For TPMS, I would like to decode as many different modulations and formats as I can. Whether that extends to transmissions at substantially different frequencies within the band will depend on how many CPU cycles I have remaining. If I run out, the user will need to choose a center frequency within the band, and will miss weaker messages significantly off-center (due to loss of sensitivity outside the matched filter's bandwidth).

KC5CQW, 2015-11-23:
I agree with the "transponder" category, good call. Digital is a bit generic of a term and would be best used for the 2-way modes that you've listed.

jboone, 2016-01-28:
There's now a transponder menu, and the frequency selection is simplified, only adjustable to the extent necessary. In the case of AIS, the two VHF channels you mentioned are the only options. For TPMS, there's no adjustment, since so far I only support transponders I've found on one frequency (315MHz). For ERT, I'm still deciding what makes sense, and will incorporate before release. However, ERT's algorithm does wideband processing, and receives transponders over a range of a couple of MHz. So it may not be a center frequency adjustment, so much as a range adjustment.

dc1rdb, 2016-01-28:
Please add frequency selection support for European TPMS at 434 MHz. Thanks!

jboone, 2016-01-28:
@dc1rdb That's definitely the plan! I will need time to learn if there distinct TPMS modulations and packet encodings in other regions of the world, then I will implement support for those. At the moment, I am implementing what I have access to.

dc1rdb, 2016-01-29:
FYI: the European system works at 433.92 MHz and is described in great detail at http://elib.dlr.de/81155/1/TPMS_for_Trafffic_Management_purposes.pdf
Hope this helps!

jboone, 2016-01-29:
Thanks, I appreciate the help.

That paper reiterates what I've known about TPMS technology for a while now -- it's not a single system or protocol, but a bunch of different, slightly different devices, each of which needs a certain amount of custom handling to correctly interpret. The exact center frequency, modulation characteristics, symbol encoding, CRC or checksum, all vary. Schrader, one of the dominant TPMS vendors has claimed -- as of 2009, I think -- that there are 140 TPMS variations. Schrader is quick to point out that they offer a sensor that can be configured to speak most of those variations, once you've configured it based on the year/make/model of your vehicle and the variant that car's ECU speaks. It is possible that the TPMS support I've implemented *may* work for a few European models at 433.92MHz, but I have no way of validating that.

To some extent, I think this variety was by design, so they didn't have to take the time to work together or create a single device ID assignment authority.

In short, to support European TPMS devices will require direct research, analysis, and reverse-engineering of signals from many different vehicles in that region.

Closed 2016-01-28.

Thread 71 (2015-11-23):

ADS-B Decoding

KC5CQW, 2015-11-23:
Add a demodulation mode for ADS-B aircraft transponders used on 1090MHz.

jboone, 2015-11-23:
My recent work on OOK TPMS demodulation suggests that ADS-B may be feasible after all. The only challenge will be symbol clock recovery, which right now is not at all optimized, and may not be able to keep up with the ~4MHz sample rate it requires. But there's much room for improvement in that code, which is implemented in floating point, at present.

KC5CQW, 2015-11-23:
See my last comment on #48. The I/Q data output would allow for off-board decoding in the event CPU/RAM overhead is maxed out. This could be a temporary solution until code headroom is available. Either way, I find it intriguing that such complex decoding can/may/will be done on such a portable, low power device!

jboone, 2015-11-23:
It would allow off-board decoding for low-bandwidth signals. ADS-B/Mode S signals are several MHz wide. The WM8731 audio codec is only capable of 96kHz sampling rate, which would permit only 96kHz  of complex spectrum to leave the device through the audio output. To look at it another way, pulse widths in aircraft RADAR systems are approximately 0.5us long. A single audio sample from a 96kHz audio codec is 10us long -- 20 times the duration. Even if you converted baseband to amplitude, there would be no way to represent such short pulses via the audio codec. Some amount of demodulation or packet detection and buffering would have to occur if audio output is used for data egress. I would recommend other options, like using the USB interface. But at that point, we're reinventing the HackRF firmware and the Mode1090 project.

jboone, 2015-11-24:
For the future, here's some references I've found for Mode A/C/S and ADS-B:

http://tech-software.net/radar/
http://www.airsport-corp.com/modec.htm

KC5CQW, 2016-05-05:
Fair enough, I keep forgetting that loading the HackRF mode IS for off-board reception (derp).

KC5CQW, 2019-03-26:
Now handled with Furtek.

Closed 2019-03-26.

Thread 72 (2015-11-23):

Push to Talk/Voice Operated Switch for RF transmissions

KC5CQW, 2015-11-23:
All regulatory agency and local laws must be observed!

Add a red PTT icon on the RX screen so that when the curser has it highlighted, the center button of the thumb wheel may be used as a PTT switch to allow for RF transmission.
Employ a VOX system for "hands free" transmission capability when sufficient audio/data levels are able to trigger transmission. (Adjustable to typical levels)1v p-p on the mic line)).
Provide a PTT lock-out in the settings to prevent unintentional transmission (have this enabled by default and at power up, reset etc. so the user has to "opt-in").
Provide a transmit time out timer with adjustable time ranges (incremental by 30 second steps for example) to prevent a stuck or unintended transmission.

jboone, 2015-11-23:
I definitely intend to present a warning before any TX operation, which must be acknowledged before TX can occur. The warning would be presented once per power-up, on first TX. I think we're in agreement. :-)

As for a TX timeout, it would apply only to certain modulation schemes (primarily audio -- AM/SSB/NBFM). Packet-based TX wouldn't need it.

KC5CQW, 2015-11-23:
Agreed, however... A backup timer for just in case things get stuck in data TX may not be a bad idea. But then again... If a lock-up occurred, the timer would likely not work anyway. Hmm, I guess some kind of watch dog timer at a lower level would be needed.

jboone, 2015-11-23:
The LPC4320 does have a hardware watchdog. It could be pressed into service to mind the entire system, not just TX.

Thread 74 (2016-02-04):

TPMS raw data analysis

tortured, 2016-02-04:
Looking to analyse the raw data from TPMS.  Looks like it currently captures and decodes the data and displays on LCD and dumps into TPMS.txt.  Would like to look at raw data before it is decoded to look for the difference in manufacturer of devices.  Since there is no real standard at this time.  Also anyway to get the decoded data into the TPMS.txt file, or possibly piped via the usb cable to a file on my computer, as it is displayed on the LCD.  Maybe it already is and I'm just not opening it in the correct way,  I've just been viewing it in gedit.

jboone, 2016-02-04:
The LCD shows only packets that pass CRC/checksum validation, and can be decoded to some extent.

The data in TPMS.TXT is after demodulation and packet detection, but before decoding. Before the "/" is the raw bits (in hex) detected after the preamble the code is currently checking for. The bits after the "/" indicate Manchester encoding errors. Packets that have a lot of "0"s immediately after the "/" are clean packets with no Manchester coding errors.

The TPMS code presently only decodes one TPMS variant, due to resource limitations (mostly my time not spent eating or sleeping. :-) ). Packets are at 315MHz, FSK with 38.4kHz deviation, 19.2kHz symbol rate, with a preamble of 32 bits of alternating "01". Additional code can broaden the modulation and coding parameters to receive more flavors of TPMS, but I haven't gotten there yet -- it requires more time spent reverse-engineering captured signals.

As a new feature, a second log file could be created that would save the packets that could be decoded.

Thread 76 (2016-02-19):

../common/utility.cpp:87:34: error: 'log2' is not a member of 'std'

mgdudas, 2016-02-19:
Have an issue compiling firmware from the latest commit.

Compiling utility.cpp
../common/utility.cpp: In function 'float mag2_to_dbv_norm(float)':
../common/utility.cpp:87:34: error: 'log2' is not a member of 'std'
  constexpr float mag2_log2_max = std::log2(mag2_max);
                                  ^
../common/utility.cpp:87:34: note: suggested alternative:
In file included from /usr/include/newlib/c++/4.9/cmath:44:0,
                 from /usr/include/newlib/c++/4.9/random:38,
                 from /usr/include/newlib/c++/4.9/bits/stl_algo.h:66,
                 from /usr/include/newlib/c++/4.9/algorithm:62,
                 from ../common/utility.hpp:28,
                 from ../common/utility.cpp:22:
/usr/include/newlib/math.h:301:15: note:   'log2'
 extern double log2 _PARAMS((double));
               ^
../common/utility.cpp:93:1: warning: control reaches end of non-void function [-Wreturn-type]
 }
 ^
../chibios/os/ports/GCC/ARMCMx/rules.mk:165: recipe for target 'build/obj/utility.o' failed
make[1]: *** [build/obj/utility.o] Error 1
Makefile:69: recipe for target 'baseband/build/baseband.elf' failed
make: *** [baseband/build/baseband.elf] Error 2

mgdudas, 2016-02-19:
Sorry.... more info.

AMD64 Ubuntu 15.10 fully updated -- no known updates to my libraries or compiler since last successful build of a9451c1

jboone, 2016-02-19:
Sorry about that. It looks like a missing #include due to my shifting around code a bit. I have a fix ready to push (along with some other, unfinished changes), but in the meantime, you should be able to compile by adding "#include <cmath>" to firmware/common/utility.cpp, right after "#include <cstdint>".

I am a bit puzzled as to why I'm not having the issue, other than maybe some of my other changes addressed the missing header indirectly...

jboone, 2016-02-19:
Committed in d6d1f6b8af38d99e0c448b4df75dbf670db77ba5 and pushed, along with some other, incomplete changes. For instance, don't expect the screen capture button to work yet. :-)

mgdudas, 2016-02-19:
Thanks, but sadly, I have a similar issue with d6d1f6b

Compiling utility.cpp
../common/utility.cpp: In function 'float mag2_to_dbv_norm(float)':
../common/utility.cpp:88:34: error: 'log2' is not a member of 'std'
  constexpr float mag2_log2_max = std::log2(mag2_max);
                                  ^
../common/utility.cpp:88:34: note: suggested alternative:
In file included from /usr/include/newlib/c++/4.9/cmath:44:0,
                 from /usr/include/newlib/c++/4.9/random:38,
                 from /usr/include/newlib/c++/4.9/bits/stl_algo.h:66,
                 from /usr/include/newlib/c++/4.9/algorithm:62,
                 from ../common/utility.hpp:28,
                 from ../common/utility.cpp:22:
/usr/include/newlib/math.h:301:15: note:   'log2'
 extern double log2 _PARAMS((double));
               ^
../common/utility.cpp:94:1: warning: control reaches end of non-void function [-Wreturn-type]
 }
 ^
../chibios/os/ports/GCC/ARMCMx/rules.mk:165: recipe for target 'build/obj/utility.o' failed
make[1]: *** [build/obj/utility.o] Error 1
Makefile:69: recipe for target 'baseband/build/baseband.elf' failed
make: *** [baseband/build/baseband.elf] Error 2

jboone, 2016-02-19:
Ahhhh. You're using GCC 4.9. I missed that. While I would not call GCC 4.9 unsupported, I recently moved to building with GCC 5.2 because it gives a significant improvement in code size -- enough that I can fit all the baseband code into the 32K available on the Cortex-M4F processor (as I have it configured currently).

I'm using perhaps too-aggressive standard library features, specifically that std::log2 is constexpr (computed at compile time if given constant arguments). GCC 4.9 might not allow that, but 5.2 does, even though that doesn't appear to be part of the C++11 standard. Maybe I should turn off GCC extensions... But then, my code would be less clear as to where my magic constants come from. Hmmm...

Would you be amenable to installing [GCC-ARM-Embedded 5.2](https://launchpad.net/gcc-arm-embedded/+announcement/13780), or would you prefer to make a case for continuing to support 4.9?

Alternatively, [firmware builds via Travis-CI](https://travis-ci.org/sharebrained/portapack-hackrf) are made available every time I push to the GitHub repo. URLs are of the form:

`https://portapack-h1-builds.s3.amazonaws.com/sharebrained/portapack-hackrf/<travis_job_number>/<travis_job_number>.1/firmware/portapack-h1-firmware-<first_seven_characters_of_commit_hash>.tar.bz2`

For instance, the latest Travis build number is "73" and the commit hash is "d6d1f6b". Complete URLs are posted to Freenode #portapack after every build job -- pass or fail.

jboone, 2016-02-19:
OK, OK, putting those constants in didn't feel as dirty as expected. :-) New commit daeb542086533230f5afb37e806f086beed97127 is pushed. I hope it addresses your issue, and that you don't run out of baseband RAM with GCC 4.9. I'm pretty sure you won't...

mgdudas, 2016-02-19:
Hey Jared,

Actually, I am on 5.2:
gcc (Ubuntu 5.2.1-22ubuntu2) 5.2.1 20151010

Whatever you did resolved my issues though, daeb542 built correctly.

How can I check how much baseband RAM is being utilized? Is it the info under Debug -> Memory?

If so, here's my numbers running the new build:

M0 Core Free Bytes: 54024
M0 Heap Fragmented Free: 1032
M0 Heap Fragments: 11

jboone, 2016-02-19:
It's complicated. The way I have things divided right now, the M4 executes baseband code from a 32K block of RAM, and the stack and heap live in a much larger block of RAM. Using two distinct regions of RAM allows the M4 to execute code and fetch data simultaneously, improving performance. [More details](https://github.com/sharebrained/portapack-hackrf/wiki/Firmware%20Architecture) are in the Wiki.

The values you're seeing in Debug->Memory are for the application core (M0). The amount of baseband code RAM used is reported at compile time. The amount of baseband heap and stack used is not reported via the UI at this point, as I have not rigged up a pair of intra-core messages that the application core can use to request the data from the baseband core.

Closed 2016-02-19.

Thread 78 (2016-02-19):

Receiver audio sometimes a bit screwy.

jboone, 2016-02-19:
Apparently depending on timing of entering an audio receiver mode/modulation, the audio will sound choppy, as if the audio buffers contain some new and some old audio. My suspicion is that the code to use the currently playing buffer, minus two buffers, modulus the number of buffers, isn't really cutting it as far as selecting an audio buffer far enough ahead of playback to be complete by the time the latest baseband block is finished processing.

There are a couple of potential means to address this issue:
- Ensure alignment of I2S blocks to the baseband sample block. Their clocks are derived from the same clock source, and have an integer relationship. So they should not slip relative to each other. This might be the simplest solution to implement, and keep the baseband firmware bloat to a minimum.
- Provide a FIFO that accepts audio samples and delivers them to a separate audio playback thread -- either running on the M4 or the M0.

Until this issue is addressed, changing the modulation mode (or otherwise stopping and restarting baseband and audio streaming) seems to retime the relationship between baseband and I2S samples and usually fixes the problem.

jboone, 2019-03-21:
I recall finding and fixing some I2S peripheral configuration issues a while back. I haven't heard this happen lately. Closing...

Closed 2019-03-21.

Thread 80 (2016-03-24):

dc removal

ZeroChaos-, 2016-03-24:
gqrx has a feature for dc removal, if it's sane it might be worth killing the dc spike in the fft

irc chatter suggests this is a "lie to the user to make them stop complaining" but this bug sure looks like a complaint to me, so maybe they are right :-)

jboone, 2016-04-20:
See comment in #79. In the audio receiver modes, there is no visible DC spike, as offset tuning is used behind the scenes. This is only a visible issue in the SPEC mode. The DC spike does impact sensitivity in ERT mode, and probably has a less obvious impact even with offset tuning. So it would be good to address this at a hardware configuration level if possible, and at the software level if all other options are exhausted.

KC5CQW, 2016-05-04:
I believe the internal "birdies" from clock harmonics are being confused with DC spikes. Yes, they are very annoying but not a coding bug; rather, a hardware one.
The shield kit from nooelec.com (with the P30 header BTW) helps mitigate some of the birdies but not all. Experimentation with EMI shielding is in order. Data lines (PCB traces) may need ferrites or capacitor bypassing, I will also ask on the HackRF GitHub for any ideas.

Thread 82 (2016-04-29):

Receiver Menu Navigation

KC5CQW, 2016-04-29:
The UI is no longer as intuitive after the addition of the record feature. It is more difficult to navigate in the up/down range and a left/right sequence must be performed to reach the target option. NFM bandwidth is a good example. The cursor will skip over the BW and highlight record. Several L/R U/D back steps must be used to get back to the BW tab.

jboone, 2016-04-29:
This is due to the poor navigation handling algorithm. (I'm surprised you can reach the BW field, I never could.) The algorithm will be improved before the capture/record feature is released, or the UI will be revised to make the poor navigation a non-issue again.

Beware running the latest builds, there's a lot of other bugs in there still. :-)

KC5CQW, 2016-04-29:
But, I'm loving the new features! Great work.

It's tricky to get to it, plus my down button is sticky.

BTW, can you send me the part numbers for the selector wheel and LCD? I imagine that I will have worn them down before too long and would like to get replacements on hand incase they become end of life.

That reminds me... My wife is always giving me a hard time about a cover to protect the face. Any files available for CNC or 3D printer that will mesh with the milled case?

73, Damon

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

KC5CQW, 2016-05-05:
Left click once the audio gain is highlighted.
I find that I sometimes have to hit the reset once or twice to clear buggy behavior.
If we don't run them, how will we find bugs? :-p

jboone, 2016-05-05:
I didn't say you shouldn't run test builds! :-)

jboone, 2016-05-05:
Ha, got it! Wow, that's a pain in the ass. I have to navigate from "NFM", along the *top* row of icons (so as to avoid changing the "option" view from "BW" to "AMP" or whatever), down to audio level, then down arrow.

In any case, that sucks, and I need a new navigation solution.

This paper was an interesting read on solving a very similar problem, DVD navigation:
https://www-users.cs.york.ac.uk/susan/bib/ss/z/zb05-dvd.pdf

Unfortunately, they were more interested in defining a means to prove an algorithm is good, more than offering a good algorithm. So back to searching...

jboone, 2016-05-05:
More on potential fixes: Web browsers implement "[Spatial Navigation](https://en.wikipedia.org/wiki/Spatial_navigation)", which is navigating between elements on a Web page using arrow keys. Following some links, I find the latest implementation of WebKit's Spatial Navigation algorithm in [a single file](http://trac.webkit.org/browser/trunk/Source/WebCore/page/SpatialNavigation.cpp). It's pretty easy to follow. I think I will implement some or all of that approach and see if it improves matters.

jboone, 2016-05-08:
Well, the code from WebKit didn't work out. In operation, it is really no better than what I have now. I'm looking at some tweaks to my existing code that might improve things.

jboone, 2016-05-08:
I've improved the algorithm in commit ab73d6155eaa4cd80dc8360172020f04a8c62aaf. Build should pop out of the Travis-CI toaster in a few minutes. Let me know if you like it -- if it seems like an improvement to you.

KC5CQW, 2016-05-09:
Mo'bettah! Works great (like it used to).

jboone, 2016-05-09:
Excellent. I'm calling it closed, then.

Closed 2016-05-09.

Thread 86 (2016-05-22):

make de bandwith adjustable in SSB

lowiess, 2016-05-22:
Would it be possible to make the bandwith adjustable in AM an SSB  modes

jboone, 2016-05-23:
It's definitely possible, and at least for now, would work like the narrowband FM bandwidth adjustment.

I will admit, I don't do much HF stuff yet -- I have no decent antennas and live in a very noisy place. Are there a few specific bandwidths, or example software or radios you could point to that I could use as references for implementing this?

argilo, 2016-05-23:
For ore thing, a CW mode with a narrow filter would be useful. I've prototyped that here:

https://github.com/sharebrained/portapack-hackrf/compare/master...argilo:add-cw-mode?expand=1

I used GNU Radio's filter designer to get the narrowest 64-tap filter I could, centred at +700 Hz.

argilo, 2016-05-23:
By the way, I intentionally set the `pass_frequency_normalized` and `stop_frequency_normalized` a bit high, since otherwise the passband extends past the right edge of the waterfall.

KC5CQW, 2016-05-24:
Take a look at Flex Radio Systems... They are kind-of the ones that kicked off serious SDR for HF ham radio and government use.
Being able to adjust the BW in SSB/CW in 10, 50, 100 & 1k steps would be a great start. Sharp cut-offs outside the "narrowed" passband and an adjustable notch filter for all modes would prove useful.
AM might not prove as useful... 6k, 9k & 12k BW "might" work for HiFi audio reception.

I would like to see a "zoom" feature to expand the viewable BW to fit the LCD screen for better viewing.
Note: The usual trade-off is lower waterfall resolution for wider screen views due to CPU effort.

Consider adjustments for low-pass, high-pass and band-pass (pass bandwidth).
These can be located in a submenu for DSP, filters, audio etc.
Take a look at the operation manuals for one of the higher end HF transcievers (Yaesu FTDX-9000) and also test equipment like Siglent O-Scopes, Spec. Ans., for ideas on menu implementation and such.

KC5CQW, 2016-05-24:
Elecraft is also a VERY GOOD company to reference for ideas with SDR, DSP menus and such.
I personally own (and built) a K2. It uses crystal hardware filters but has a basic audio DSP option. Elecraft used this DSP as a model for an outboard audio filter kit. They should have PDFs with build, operation and theory on this and all of their other equipment.

lowiess, 2016-05-24:
Hello all

SSB and speech in general Wil fit is 300-3000 Hz thus 2700 bandwidth
And is most radio radio you Wil find filters with 2.4kc and 1.8 kc

CW a good start is 500 Hz and 250 Hz

A good source is the implementation of elecraft kx3 which is a complete SDR

Kind regards Frans
Op 24 mei 2016 07:26 schreef "KC5CQW" <notifications@github.com>:

Elecraft is also a VERY GOOD company to reference for ideas with SDR, DSP
menus and such.
I personally own (and built) a K2. It uses crystal hardware filters but has
a basic audio DSP option. Elecraft used this DSP as a model for an outboard
audio filter kit. They should have PDFs with build, operation and theory on
this and all of their other equipment.

—
You are receiving this because you authored the thread.
Reply to this email directly or view it on GitHub
<https://github.com/sharebrained/portapack-hackrf/issues/86#issuecomment-221169784>

jboone, 2016-07-05:
Recent commits separated the code of the now-many baseband modes. So each baseband mode has the entire 32KBytes available for code. This opens up code space for the M4 (which has hardware floating point) to do filter coefficient calculation, instead of forcing the poor M0 core to do that work. There's also enough SPI flash that coefficients could be pre-calculated on a host computer and compiled in, but seems like a clunky and coarse approach vs. dynamically calculating coefficients based on user input.

lowiess, 2016-07-05:
Hello Jared,

If I understand well the adjustable bandwith might be possible ?
In that case there is no need for predefined bandwiths
Adjustable for 4.5 khz to 100 hz is fine for all modes

73 Frans PE0F

2016-07-05 19:17 GMT+02:00 Jared Boone <notifications@github.com>:

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

argilo, 2016-07-05:
Calculating coefficients is definitely a better approach. No point wasting precious memory on tables. I only added the CW table as a quick hack.

Thread 91 (2016-07-05):

Spectrum peak tracking cursor/marker

jboone, 2016-07-05:
Show absolute frequency and relative frequency (to current tuned frequency) of the strongest peak in the spectrum display -- ignoring DC peak, of course. Idea separated out from issue #7.

KC5CQW, 2016-07-09:
Please elaborate (clarify) on "absolute" and how it is derived. Is this the carrier frequency that is suppressed in modes other than AM and the idle carrier in FM?

Thread 92 (2016-07-20):

Touch sensing broken when baseband not running

jboone, 2016-07-20:
Whoops, one unintended consequence of separating baseband images and starting a specific image on demand -- when there's no baseband image running, touch sensing doesn't happen!

So... Find a way to get that done on the M0, where it belongs. Seriously.

jboone, 2016-07-24:
Resolved in commit 8b02e40602e6813b4cd4c31e1d9e9cd018176100 by eliminating DMA-based ADC sample capture. Instead, the ADC runs continuously, and the most recent Xp, Xn, Yp, Yn samples are taken directly from the ADC registers without regard to sampling frame "phase". So it's possible that the four samples may be in different time order between frames. Since sampling a frame of samples takes ~10 microseconds, it won't be an issue in practice.

Closed 2016-07-24.

Thread 97 (2016-07-28):

Restoring HackRF Firmware

taintdluv2k4, 2016-07-28:
I followed the directions in the section titled, "Restoring HackRF Firmware" and received the following output:
No DFU capable USB device found

While in this state, or in Portapak mode, and even running in "HackRF Mode", no new devices show up for the "lsusb" command either...

jboone, 2016-07-28:
The HackRF will only appear as a DFU device if you hold the DFU button while plugging in USB or pressing and releasing the RESET button.

The PortaPack firmware does not use USB and will not show up at all on a host computer.

You should see something with lsusb after switching from PortaPack to HackRF mode. Let's get the easy things out of the way -- try different cables, different USB ports on your computer, reboot your OS. A surprising number of these issues are caused by a bad cable or connector, or the operating system being in a bad mood. Also, check that your OS power management isn't interfering. For instance, this HackRF issue: https://github.com/mossmann/hackrf/issues/243

Let me know what you discover.

taintdluv2k4, 2016-07-28:
Oh, the shame... it was just a bad cable.

jboone, 2016-07-28:
No worries. You're definitely not alone. ;-)

Closed 2016-07-28.

Thread 100 (2016-08-16):

Run HackRF firmware if PortaPack hardware not detected or does not initialize correctly

jboone, 2016-08-16:
This would be a nice failsafe if the LCD doesn't initialize or some other start-up procedure fails or does not find PortaPack hardware. At least the device can be unmated and act like a HackRF in the meantime.

jboone, 2017-08-12:
Implemented in commit 748e5a4f5f175b8525531d3c1d6d34349a87ff82, released in 20170720.

Closed 2017-08-12.

Thread 102 (2016-08-18):

New Stable Release Build Issues

gh0stshell, 2016-08-18:
After flashing the latest release under releases I have some odd issues when entering the freq number and also a few times I cannot get to the top menu buttons like back and when these issues happen I have to reset the device to get working again. If I go back to the build db700b1 I do not have the same issues I do with the latest release build.

jboone, 2016-08-21:
@gh0stshell Is this via the touch interface, or using the mechanical controls?

jboone, 2016-08-31:
@gh0stshell Any extra insights you could share?

gh0stshell, 2016-08-31:
Touch screen, if I go to enter a freq say 315, when pressing 3 it enters 3, when pressing 1 it enters 3-4 1 numbers, when I re-flashed db700b1 when I enter 315 it enters 315 with no extra numbers. As for the menus, it has a few times where when I use the scroll wheel to go to the top options I can never get to the back or any of the menus at the top above the freq section.

gh0stshell, 2016-08-31:
After resetting I can get to the menus normally, but the multiple numbers when entering a freq still happens so I went back to db700b1

jboone, 2016-08-31:
@gh0stshell The multiple numbers is likely due to lighter debouncing of detected screen touches. I have noticed this a few times, to a lesser degree, on a couple of my units. It's a regression I will address for the next release.

As for the top options being inaccessible, I'm not sure how to recreate this. Firstly, is this in the audio receiver mode? Do you see the menu issue with the db700b1 firmware? Can you identify a minimal set of steps required, from a fresh reset, to recreate the issue? Or is it something that seems to happen at random? Are there any general trends or patterns you can identify? Or if you can recreate it, even sporadically, perhaps you can record a video example you can share?

gh0stshell, 2016-08-31:
Yes, all the issues I have had happen with the latest stable was in the receiver screen. I do not get them with the db700b1 build so I have gone back to that build as it works very well for me even though it technically a beta build. The top menu issue is random for me and I do not notice it is happening until I try to go back a menu.

gh0stshell, 2016-08-31:
I will try to shoot a vid when it happens, I will flash the latest stable tonight when I have my gear.

gh0stshell, 2016-09-01:
New issue I have come across which may fix the enter of freq while in receive mode, cannot get the touch setup to work, will not recognize my input.

aaronkondziela, 2016-09-02:
Just to throw in, I've also had the same trouble where the mechanical controls seem to get into a funky state, and I can no longer navigate without a reset. Can't comment on the touchscreen aspect, as I don't use it often. It does seem to me like some kind of debouncing issue, on my unit specifically with the center button. (Maybe I should toss the scope on it, see how much bounce there is?) Almost feels like the software gets into a funny state where it thinks the button remains held down or something. Also note that it seems random, and did not start after a particular firmware; has been present through a few versions.

jboone, 2019-03-21:
Some code was added to deal with mechanical wheels being non-ideal devices, including ignoring secondary key presses. Imminent new release may help. Closing...

Closed 2019-03-21.

Thread 103 (2016-08-18):

Latest Build Address

gh0stshell, 2016-08-18:
Do any of the newest builds have the TX option and if so what is the latest link to download it so I can try the build?

I see listed in travis-CI under current as of 2 days ago there is a new build, but do not know if it has TX as I am having issues location the download URL as listed in the steps for issue #73

portapack-h1-firmware-8333789.tar.bz2

gh0stshell, 2016-08-19:
I see the re-director is working and pulled the latest build from that

http://munchkins.net/portapack

jboone, 2016-08-21:
@gh0stshell I have some prototyped TX features in my local branch of the repository. None of them are usable except for my testing. But, they are working! So I can promise there will be interesting TX features in the next release. And the next release will be much sooner than the five months it took for the last release...

Closed 2016-08-21.

Thread 104 (2016-08-31):

firmware build instructions don't work?

mgdudas, 2016-08-31:
Hi,

I noticed about 4-5 months ago, my build environment completely died, and I was no longer able to build firmware. At the time, and ever since I figured it was either a temporary break, or my environment had completely broken (which had happened before as well)

But, today I finally build out a completely fresh Ubuntu 16.04 VM, and I still can't get it to build anything.

When I grab a fresh clone of the git repo, after having installed all other dependencies, I try to run 'make' in the firmware directory and get this error:

make: *** No targets specified and no makefile found.  Stop.

Since the firmware build instructions haven't seemed to change in quite some time, I really have no idea what the problem is. Has something changed, or am I just failing at basic compiling?

Thanks!

jboone, 2016-08-31:
@mgdudas No, you're not failing. I'm failing at updating the documentation. The firmware build now uses CMake (2.8.10 or newer). The instructions, if written somewhere appropriate, would look like this:

cd <portapack_source_directory>
mkdir build
cmake ..
make

...and it should pop out, after much pomp and circumstance, a binary you can load in the usual manner (via hackrf_spiflash). Or you may put the HackRF into DFU mode and do "make program".

I hope that helps.

(I'm keeping this issue open as a reminder to me to update the blasted docs.)

jboone, 2016-08-31:
@mgdudas Correction, I forgot that a simple "make" doesn't produce the "firmware/portapack-h1-firmware.bin" file. That comes during "make program". So that needs improving, too...

mgdudas, 2016-08-31:
@jboone Great, I'm not insane! You know, I had noticed the cmake files and such before, and at one point thought I had gotten somewhere, but I guess I was in the wrong directory.

Ultimately though, running make program, I still get an error (because of dfu-util 0.8 I think):

Opening DFU capable USB device...
ID 1fc9:000c
Run-time device DFU version 0100
Claiming USB DFU Runtime Interface...
Determining device status: state = dfuIDLE, status = 0
dfu-util: WARNING: Runtime device already in DFU state ?!?
Claiming USB DFU Interface...
Setting Alternate Setting #0 ...
Determining device status: state = dfuIDLE, status = 0
dfuIDLE, continuing
DFU mode device DFU version 0100
Device returned transfer size 2048
Copying data from PC to DFU device
Download	[=========================] 100%        20484 bytes
Download done.
dfu-util: unable to read DFU status after completion
dfu-util: can't detach
Resetting USB to switch back to runtime mode
dfu-util: error resetting after download
firmware/CMakeFiles/program.dir/build.make:57: recipe for target 'firmware/CMakeFiles/program' failed
make[3]: *** [firmware/CMakeFiles/program] Error 74
CMakeFiles/Makefile2:130: recipe for target 'firmware/CMakeFiles/program.dir/all' failed
make[2]: *** [firmware/CMakeFiles/program.dir/all] Error 2
CMakeFiles/Makefile2:137: recipe for target 'firmware/CMakeFiles/program.dir/rule' failed
make[1]: *** [firmware/CMakeFiles/program.dir/rule] Error 2
Makefile:131: recipe for target 'program' failed
make: *** [program] Error 2

Then, realizing I still have dfu-util 0.8 installed, I try the 'workaround' listed on the build page, but that is also incorrect, because the file locations have changed.

From build dir:

hackrf_one_usb_ram.dfu is now in ../firmware
portapack-h1-firmware.bin is now in ./firmware

Even after fixing the paths though, I get the following:

dfu-util 0.8

Copyright 2005-2009 Weston Schmidt, Harald Welte and OpenMoko Inc.
Copyright 2010-2014 Tormod Volden and Stefan Schmidt
This program is Free Software and has ABSOLUTELY NO WARRANTY
Please report bugs to dfu-util@lists.gnumonks.org

dfu-util: DFU suffix CRC does not match
dfu-util: A valid DFU suffix will be required in a future dfu-util release!!!
Opening DFU capable USB device...
ID 1fc9:000c
Run-time device DFU version 0100
Claiming USB DFU Runtime Interface...
Determining device status: state = dfuIDLE, status = 0
dfu-util: WARNING: Runtime device already in DFU state ?!?
Claiming USB DFU Interface...
Setting Alternate Setting #0 ...
Determining device status: state = dfuIDLE, status = 0
dfuIDLE, continuing
DFU mode device DFU version 0100
Device returned transfer size 2048
Copying data from PC to DFU device
Download	[=========================] 100%        20484 bytes
Download done.
dfu-util: unable to read DFU status after completion
dfu-util: can't detach
Resetting USB to switch back to runtime mode
dfu-util: error resetting after download
File size 422720 bytes.
hackrf_open() failed: HACKRF_ERROR_NOT_FOUND (-5)

:-(

jboone, 2016-08-31:
@mgdudas You shouldn't need to fix any paths. The fact that you had to is an indication something else is wrong.

dfu-util 0.8 is fine, I've been using it for months with no (real) problems, other than it complains a lot about things that aren't, in practice, errors.

The fact that the DFU "Download [===...]" completes is a sign that your hackrf_one_usb_ram.dfu was in the right place to begin with.

You're very close. In the last try, think your build is fine. It looks like the HackRF mode USB interface isn't enumerating. One of several possible causes: bad USB cable, a virtual machine guest that is stealing the USB device or otherwise interfering with USB enumeration, or the delay between DFU download and expecting the HackRF to enumerate (the "sleep 1") is too short.

jboone, 2016-08-31:
@mgdudas Also, if you "VERBOSE=1 make" or "VERBOSE=1 make program", you'll see lots of extra detail that may show exactly what's going wrong.

mgdudas, 2016-08-31:
Well, the first time I run 'make program' it knows where the files are, and does complete the download. But the 2nd time, I'm using the dfu-util 0.8 workaround listed at the bottom of the build page, and that exact command no longer has the correct paths.

As for the hackrf itself, hackrf_info shows it just fine, and dfu-util lists it correctly when in dfu mode. I'll try a different cable and see what I can do.

While I'm at it... I've attached a file with the log of 'VERBOSE=1 make program' if that helps determine what the issue is.

Thanks!
[make-program-failure.txt](https://github.com/sharebrained/portapack-hackrf/files/447911/make-program-failure.txt)

mgdudas, 2016-08-31:
Ultimately, after trying a new cable, make program still fails, but running the workaround command (with corrected paths from the build dir) it has finally properly programmed it.

dfu-util --device 1fc9:000c --download ../firmware/hackrf_one_usb_ram.dfu --reset
hackrf_spiflash -w ./firmware/portapack-h1-firmware.bin

So, seems it's a combination of things. :-)

Thanks again for your help.

jboone, 2016-08-31:
@mgdudas So weird. We're running exactly the same code. Your log diverges from mine when yours says "dfu-util: error resetting after download". I'm guessing from your paths you're on Linux, possibly Ubuntu? Oh, yeah, you said that initially. It seems like your CMake or dfu-util is treating the reset failure as a build failure, and mine isn't. What version of CMake are you running? I'll also check to see that there isn't a rev of dfu-util or CMake, beyond what I'm running on Mac OS.

jboone, 2016-08-31:
@mgdudas If you remove the "--reset" from the DFU step in the CMake file, does everything start working?

mgdudas, 2016-08-31:
I assume you mean remove it from firmware/CMakeLists.txt ?

I'm running:
Ubuntu 16.04.1 LTS
cmake 3.5.1
dfu-util 0.8

After removing --reset from firmware/CMakeLists.txt line 62 and compiling it all again, 'make program' produces the following (truncated) output, and it does appear to work:

<truncated>
dfu-util: DFU suffix CRC does not match
dfu-util: A valid DFU suffix will be required in a future dfu-util release!!!
Opening DFU capable USB device...
ID 1fc9:000c
Run-time device DFU version 0100
Claiming USB DFU Runtime Interface...
Determining device status: state = dfuIDLE, status = 0
dfu-util: WARNING: Runtime device already in DFU state ?!?
Claiming USB DFU Interface...
Setting Alternate Setting #0 ...
Determining device status: state = dfuIDLE, status = 0
dfuIDLE, continuing
DFU mode device DFU version 0100
Device returned transfer size 2048
Copying data from PC to DFU device
Download	[=========================] 100%        20484 bytes
Download done.
dfu-util: unable to read DFU status after completion
File size 422720 bytes.
Erasing SPI flash.
Writing 422720 bytes at 0x000000.
[100%] Built target program

One other random note.... on the about screen, it says HackRF CPLD BAD... I don't recall it saying BAD previously. Not sure if it's related.

jboone, 2016-08-31:
@mgdudas It's not related, and I'd expect it to say "BAD" right now. It indicates that the bitstream flashed into the HackRF CPLD does not match the one that the PortaPack is using. I need to separate things out, so I can validate the flashed bitstream is correct for the HackRF firmware, while potentially using a different bitstream (now the case in the repo HEAD) for PortaPack mode.

I'm going to remove the "--reset" from the firmware/ CMake file.

jboone, 2016-08-31:
By the way, I've updated the Wiki:

 https://github.com/sharebrained/portapack-hackrf/wiki/Building-Firmware

Let me know if it matches your experience.

jboone, 2016-08-31:
Pushed the DFU --reset change. Let me know if, when building from a fresh build/ directory, it still programs the device OK.

mgdudas, 2016-08-31:
OK, I can confirm after wiping my entire existing directory and starting over from scratch. Following the instructions on the current wiki page works flawlessly.

Thanks for all your help.

jboone, 2016-08-31:
Excellent. Thank *you* for your help, and letting me know about this issue. Closing the issue.

Closed 2016-08-31.

Thread 105 (2016-09-19):

UI Framework link broken on Wiki

lostangles, 2016-09-19:
UI Framework link doesn't go anywhere, is this because there is nowhere for it to go?

I'm going to start playing around with building my own modules, is there a good resource for a rundown on the framework?

jboone, 2016-10-09:
Hi @lostangles,

Sorry for the delay in responding. I have been traveling a bunch and have gotten behind on my other responsibilities.

You're right that the UI framework isn't documented. I've held off doing so because I'm not pleased with the quality or structure of the code and would like to rework it significantly. It is pretty simple compared to a Linux/Windows/MacOS framework, since the whole system runs in 200K of RAM... There's a small complement of widgets -- text, rectangle, button, number field, option field, scrolling region, menu/list. Many of these are built from lower-level primitives, or on top of the View widget, which is a container for other widgets. C++ inheritance is used to share a lot of code from the base Widget class.

The furrtek/portapack-havoc project has extended the widget collection significantly, so you might have a look at that to see how others are applying the UI code.

If you have specific things you'd like to know or need to start with, please let me know and perhaps I can conjure up adequate documentation to help.

Thread 112 (2017-04-22):

lcd model / part number

gigawatts, 2017-04-22:
Can you please provide a part number and supplier for the LCD, I need to find a replacement (LCD cracked, digitizer no longer works). Actually, is it possible to just replace the digitizer? I am pretty sure that is the only part that is broken.

I didn't see a BOM anywhere, sorry if I overlooked it.

sck-nogas, 2017-04-24:
Last year, I cracked my LCD screen, and Jared in August 2016 said... "The LCDs
come directly from China, and have a unique pin-out. They do not use the SPI
interface. I do sell replacement LCDs at my cost ($5 + shipping),"

It was real easy to replace.

Scott

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

gigawatts, 2017-04-27:
Thanks for the info, I'll shoot Jared an email.

gigawatts, 2017-06-04:
Jared was also able to sell me a replacement LCD, which was very easily installed. Thank you again for the tip @sck-nogas

jboone, 2017-08-12:
While I sell LCDs to those who contact me, you can find the LCDs by these rules:

PortaPack revision before 20170522 --> Kingtech DW0240A2BZ (16-bit 8080-I MCU interface, IM[3:0] = 0b0001) with resistive touch screen.
PortaPack revision 20170522 (and newer, if that should happen?) -> EastRising ER-TFT024-3 with resistive touch screen.

This information has been added to the "Hardware" section of the wiki.

Closed 2017-08-12.

Thread 113 (2017-08-09):

TCXO

ncoop23, 2017-08-09:
How do I go about installing a TCXO on the HackRF with a PortaPack installed?  It appears that the header is used on the board.  Is there a way to kludge this?

Possible to integrate a TCXO on the next hardware version?

ncoop23, 2017-08-09:
Worst case is something powered over USB that puts the clock signal into the clkin SMA connector but something in the box would probably be better.

jboone, 2017-08-12:
@ncoop23 I would dead-bug the TCXO onto the PortaPack. The pins are sufficiently exposed that it shouldn't be too difficult. Be mindful, however, of total power consumption, as USB limits draw on the VBUS to <500 mA, and has strict limits around how much current you can draw when first connecting to USB power. Also, you'll want to match the signal requirements for the Si5351C-B input, and ensure you don't plug anything into the reference clock input SMA (which risks damaging whatever TCXO you've attached).

Closed 2017-08-12.

Thread 115 (2017-11-04):

hackrf mode

zoomequipd, 2017-11-04:
I've had some consistent problems trying to get hackrf mode to work. FWIW, I also had this issue with the havoc firmware and went back to your firmware to troubleshoot

To replicate:
    1) plug portapack into pc
    2) from the menu on the portpack - enable hackrf mode
    3) start gqrx
    4) setup the IO Device as normal
    5) click 'Start DSP' button
    6) nothing seems to happen

I've flashed the latest firmware (manually compiled from git master branch) - the pc finds the hackrf fine, but I've never gotten GQRX to work with the device while in this mode.

```
$ hackrf_info
hackrf_info version: git-44333b7
libhackrf version: git-44333b7 (0.5)
Found HackRF
Index: 0
Serial number: 000000000000000----REDACTED----
Board ID Number: 2 (HackRF One)
Firmware Version: 2017.02.1 (API:1.02)
Part ID Number: 0xa000cb3c 0x004f4338

```

To troubleshoot, I removed the portpack and re-flashed the standard hackrf firmware on the device, plugged it in without the portpack connected and it worked fine.

jboone, 2017-12-04:
@zoomequipd My apologies for totally missing your issue until now. Can you report on the state of the HackRF LEDs after you enable HackRF mode from the PortaPack main menu? Can I assume you're using a flavor of Linux? Can you say which version (repo commit hash or tagged release) of GQRX you're using? I am wondering if there's a HackRF API version mismatch, somehow. Do you see any USB-related erros in dmesg after entering HackRF mode?

fantuz, 2017-12-21:
Hello @jboone
I experiment the same behaviour described by  @zoomequipd on portapack-havoc project and on portapack-hackrf.

Yes, all gr-osmo and gnuradio environment setup correctly, compiled. Ubuntu 16, environment didn't change.

I basically will use this procedure to go back to basic WORKING hackf (without recompiling/touchng GQRX, all git all up-to-date):
 -- hackrf_spiflash -w /home/max/hackrf/firmware/build/hackrf_usb/hackrf_usb.bin
 -- hackrf_cpldjtag -x /home/max/hackrf/firmware/cpld/sgpio_if/default.xsvf

So, I guess there must be something wrong in the converter xsvf/svf parts ! Might be a trace ?

To reproduce this "blackout" issue, put the portapack in hackrf-mode, and try to start GQRX, we get:
```
max@trinity:~/gqrx/build$ ./gqrx &
gr-osmosdr v0.1.4-98-gc653754d (0.1.5git) gnuradio 3.7.12git-295-ga0adcd33
built-in source types: file osmosdr fcd rtl rtl_tcp hackrf bladerf rfspace airspy
Resampling audio 96000 -> 48000
BookmarksFile is /home/max/.config/gqrx/bookmarks.csv
gr-osmosdr v0.1.4-98-gc653754d (0.1.5git) gnuradio 3.7.12git-295-ga0adcd33
built-in source types: file osmosdr fcd rtl rtl_tcp hackrf bladerf rfspace airspy
Using HackRF One with firmware 2017.02.1
terminate called after throwing an instance of 'std::runtime_error'
  what():  hackrf_set_freq(1e+12) has failed (-1000) Pipe error

[1]+  Aborted                 (core dumped) ./src/gqrx

```

Will be necessary to edit the /home/max/.config/gqrx/default.conf and get rid of the [input] part just to have GQRX starting again (but this is not an issue). Obviously this editing of preference file will not make the acquisition work, will just let GQRX start clean before reproducing the error over and over again.

If the full reflash is done, no issues, no recompilng of GQRX or GR-OSMO whatsoever.
Is not a gqrx issue anyway, as I am used to gnuradio and gqrx, I tend to keep all my environment fully working toward all the git dependencies and releases (I run Airspy, BladeRF and rtl at the same time, along with basic HackRF and now portapack).

Cheers and thanks
Max / HB3YOE

fantuz, 2017-12-21:
Just extra notes:
 - in GQRX the device is selectable
 - GQRX shows proper gain settings (not like if device busy, we won't get gain controls)
 - no alerts on the dmesg
 - CLK IN (3v3 10mhz) just as extra complexity, plugging it out doesn't change

jboone, 2017-12-22:
@fantuz In your error log, "1e+12" (1 terahertz) argument to hackrf_set_freq() is not a valid frequency for the HackRF. If you use the command-line hackrf_transfer to do some basic baseband recording, do you receive the same errors?

fantuz, 2017-12-22:
yes @jboone I can confirm the error still happens on CLI

anyway the THz thing is more result of a crash, and as said if I edit the config, I can start DSP but no INPUT (even if gain controls and empty waterfall).

flashing all back to HACKRF-firmware works, so is definitely a portapack-issue...

thanks if you get the time to look at it.

73
Max

fantuz, 2017-12-22:
```
max@trinity:~/kalibrate-hackrf$ hackrf_transfer -r /tmp/12345 -f 147.325Mhz -a 1 -g 42 -l 32 -C 0                                                                                      
call hackrf_set_sample_rate(10000000 Hz/10.000 MHz)
call hackrf_set_hw_sync_mode(0)
call hackrf_set_freq(147 Hz/0.000 MHz)
call hackrf_set_amp_enable(1)
Stop with Ctrl-C
 0.0 MiB / 1.000 sec =  0.0 MiB/second

Couldn't transfer any bytes for one second.

Exiting... hackrf_is_streaming() result: HACKRF_TRUE (1)
Total time: 1.00009 s
hackrf_stop_rx() done
hackrf_close() done
hackrf_exit() done
fclose(fd) done
exit
max@trinity:~/kalibrate-hackrf$

```

fantuz, 2017-12-24:
Can confirm the same beahaviour after multiple flashes and rebuilds of gr-osmocom gnuradio gqrx and Co.

On Ubuntu 16 and yesterday tested on different setup, Ubuntu 17.10....

fantuz, 2018-01-08:
Hello @jboone the guess about the error I posted (( "1e+12" (1 terahertz) ))
Is not related to hackrf-mode not working, as this little message wa due to a gqrx bug, fixed.

otherwise, hackrf mode still not working for me ! owning the latest portapack....bought hackrf last year from greatscott.

i wonder why the stock CPLD file is compressed, in xsvf format within HACKRF project
while yours and furrtek's firmware are not... may it help ? i tested with both portapack projects, no luck.

anyway, once more, tested even on another machine, I confirm the hackrf mode not working on my side (device present, transfer fail, gqrx works with stock FW).

is compression of CPLD to be taken in account ? why i experience random crashes ? i am ham-radio licensed and very carefyl on my circuits since ever, not an hardware issue as the unit works with GPSDO, gnuradio, gqrx and even qspectrumanalizer using the latest hacrkrf_sweep....

ciao,
Max

jboone, 2018-01-15:
Hi @fantuz:

The file is stored as XSVF in the firmware to save space, and require a lighter parser to perform the operations on the CPLD. The HackRF has only 1 Megabyte of SPI flash, so I try to preserve that resources as much as possible.

If you would, please put your PortaPack in HackRF mode. Then try these commands:

```
hackrf_info
hackrf_transfer -r /dev/null -s 10000000 -f 100000000
```

...and let me know what the output and results are. Thanks! We'll figure out what's going on.

fantuz, 2018-01-27:
It works in HackRF mode only if I erase all portapack-related firmware.
So, I will execute the suggested command and paste result, but the issue for me really is that I cannot use HackrRF in HackRF mode once the HAVOC has been flashed.

Even if device-wise, my hackrf is correctly enumerating. Will follow up soon

PS: the GPSDO is not always connected or in use, and that does not influence my experience.

jayPhantomic, 2018-03-06:
I am having the same issue on standard portapack firmware as described by the above replication procedures.

I had a couple of questions. Fantuz, were you only able to return the HackRF to standard operating mode, i.e. HackRF mode, after removing the portapack pcb? Because I flashed the latest HackRF official firmware, and it indicated a successful flash.

However, I still got the same response from GQRX on kali-rolling, and SDRSharp on win10. Device was initializing, gain controls seemed operative, but no output.

Also, I have been using the release binaries for the HackRF official firmware, is there any possible benefit a source build could offer?

Thanks in advance.

jboone, 2018-12-16:
@zoomequipd, @fantuz, @jayPhantomic I have some firmware that might address your issue. I did some work on restoring the hardware state to that expected by the HackRF firmware. Here is some test firmware which might address your issue: https://portapack-h1-builds.s3.amazonaws.com/sharebrained/portapack-hackrf/176/176.1/build/firmware/portapack-h1-firmware-90f64a6.tar.bz2

jboone, 2019-03-21:
A lot of work was done on or related to HackRF mode, and I believe the issues are resolved. Closing...

Closed 2019-03-21.

Thread 116 (2017-12-15):

DFU fault happened in linux Ubuntu14

wog5zpf, 2017-12-15:
dfu-util: DFU suffix CRC does not match
dfu-util: A valid DFU suffix will be required in a future dfu-util release!!!
dfu-util: No DFU capable USB device available

I executed this command "dfu-util --device 1fc9:000c --download hackrf_one_usb.dfu --reset" and met the problem of DFU as above. Could anyone help me please.

jboone, 2018-12-16:
@wog5zpf I apologize for the very long delay.

The first two messages are OK. dfu-util complains a lot about things that are not actually errors.

The last error is a concern. First, be sure that you are holding down the DFU button on the HackRF (it is the button closer to the antenna connector) while you plug in the USB cable.

If you are using Linux, do you see the device detected in "dmesg" output? For instance:

```
[212531.109068] usb 1-2: new high-speed USB device number 83 using xhci_hcd
[212531.258097] usb 1-2: New USB device found, idVendor=1fc9, idProduct=000c
[212531.258104] usb 1-2: New USB device strings: Mfr=1, Product=2, SerialNumber=3
[212531.258108] usb 1-2: Product: LPC
[212531.258112] usb 1-2: Manufacturer: NXP
[212531.258116] usb 1-2: SerialNumber: ABCD
```

jboone, 2019-01-24:
Nothing heard. Closing.

Closed 2019-01-24.

Thread 117 (2018-01-15):

Touchscreen issues

szedd, 2018-01-15:
When I try to calibrate the touchscreen, it often seems to be unresponsive.
When it is working, it only seems to recognize the first two calibration points (upper left and right),
the calilbration fails at the third point or it starts to take screenshots and enter sleep mode before it fails.

The firmware date is August 9th 2017 (Git Commit Hash a335139)

I don't know if it really is a firmware issue or the hardware failed.

jboone, 2018-01-15:
The touchscreen calibration mode has turned out to be a bit of a mistake. It's very fussy, and only works well when using something pointed, like a stylus. I really need to either disable it, or loosen up the tolerances.

Bear in mind that this is  a resistive touch screen, which is terrible by comparison to modern smartphone capacitive touch devices... I've mostly avoided implementing touch features in the user interface because of how disappointing it is vs. modern expectations.

When you do make it through the calibration process, does touch entry (say in the receiver frequency screen) work as expected, or is that erratic?

szedd, 2018-01-15:
Touch entry doesn’t work right at all, all it does is taking screenshots and enter sleep mode, I guess it thinks I am touching the upper right of the screen all the time.
I tried using a stylus, that didn’t help either.

szedd, 2018-01-15:
I took a Video of the problem https://youtu.be/Bje9wAHSIsc
As you can see, it is not responsive when I try to enter a frequency.
In calibration mode it often takes screenshots when I push center or left and it enters sleep mode when i push on the right side.

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

jboone, 2018-01-15:
@szedd Hmmm, yeah. I was hoping this would be something we could fix remotely. Please contact me by the e-mail address at the bottom of [my contact page](https://www.sharebrained.com/about/) and we can discuss how to get that hardware fixed.

Closed 2018-01-16.

Thread 120 (2018-03-07):

Problem with HackRF after adding portapack

alphaomicron, 2018-03-07:
Hello Jared,
I finally got my portapack and started assembly. Once I attempted a first boot hackrf, went in dfu mode and can't reset it since then. I had updated to firmware 2017.1 and everything worked fine since I last tested.
I followed https://github.com/sharebrained/portapack-hackrf/issues/108  but no success
Running on either VM or VirtualBox on a windows machine

Thank you!

alphaomicron, 2018-03-07:
Any chance that might be caused by a microsd into the portapack which was straight out of the box? So somehow the portapack tried to read a firmware from the sd?

alphaomicron, 2018-03-07:
Ok this is so lame of me...and although I was aware of similar problems I thought it would never happen to me again. It was a cable problem and although I used the cable that came with the Hackrf it seems that it caused the problem. Issue closed

alphaomicron, 2018-03-07:
Nope same problem again as soon as I attach portapack :-(

alphaomicron, 2018-03-07:
Hackrf is recognized by the computer but nothing comes up on the portapack screen

alphaomicron, 2018-03-07:
Hackrf is recognized by the computer but nothing comes up on the portapack screen. I makes a quick flash and then there is nothing.
Also when attached to two different power banks there is no usb light (maybe an issue for the Hackrf repository)

jboone, 2018-03-07:
I received a lot of messages from this issue, and don't see some of them. Can you tell me what's working and what isn't? And if you'd prefer a more interactive medium, would you like to meet in Freenode #portapack?

alphaomicron, 2018-03-07:
Of course! would love to contribute in anyway I can.Yeap we can meet in #portapack

Closed 2018-03-07.

Thread 122 (2018-05-28):

Baseband processor sampling rate

salvitti, 2018-05-28:
Hi,

I have noted the sampling rate of baseband processor was set at 3072000.
Why this strange value?
Is it possible to increase the sampling rate up to 20 MHz?

jboone, 2018-05-29:
Can you say which file you're looking at? Most likely that is an audio mode. In which case, the sampling rate is chosen to be an even multiple of the audio output frequency, to simplify the math of the sample decimation process. There are other modes (for instance the wideband spectrum analysis mode) that use a 20MHz sampling rate. In that case, there is very little CPU power left to do anything but the spectrum analysis. The processor on the HackRF is only 204 MHz and has no fancy peripherals like a GPU.

Closed 2018-05-29.

Thread 125 (2018-06-11):

TXCO Follow-up

cyrus104, 2018-06-11:
I saw your post about the TXCO having sufficient pins exposed. My question is besides needing to raise all the pins and the case not fitting 100% could I use a TXCO in J22 with double sided pins and double height pins everywhere else on the board. Will there be an issue with the TXCO and portapack using the same pins?

Thanks

TheCranston, 2018-06-11:
@cyrus104 I deadbug'd my TCXO to the bottom of the HackRF board.  Laid down some insulating tape on the adjacent side of the Portapack case to ensure if contact is somehow made that it's not electrical...  However, I believe the code to select the external clock is not active in the Portapack firmware so you'll not get the benefit of the clock unless you are in HackRF mode.

cyrus104, 2018-06-13:
ok, nice which TXCO did you use? Is there any possibility to add the external clock capability into the Portapack firmware?

TheCranston, 2018-06-13:
I purchased a TTETKLJANF-10.000000 from digikey.  It's a 0.28ppm TCXO.  It was less than $15.  The app notes suggest a 0.1uf decoupling capacitor between Vcc and GND, but I omitted that.  I'm getting a reliable 0.3ppm calibrating from a local LTE tower.

furrtek is working on including the external clock into the havoc firmware.

cyrus104, 2018-06-16:
@TheCranston, thanks for the input I order the 0.10ppm version of the same TCXO. I should get it over the weekend or early next week. Can you post a picture of how you installed it? I'm in the process of looking at how to solder it onto the hackrf while still using the portapak. I'll just need to use it in Hackrf mode till the Havoc firmware supports it.

sgoudelis, 2018-11-14:
Hey @TheCranston can you upload a photo of the hackrf with the TCXO ?

jboone, 2018-12-16:
@cyrus104 Support for detecting and using an external 10 MHz clock reference is present in this test firmware, if you want to give it a try: https://portapack-h1-builds.s3.amazonaws.com/sharebrained/portapack-hackrf/176/176.1/build/firmware/portapack-h1-firmware-90f64a6.tar.bz2

TheCranston, 2018-12-17:
@sgoudelis, perhaps after the new year.  I'm totally swamped right now with stuff and would have to take apart the whole unit to get at it.  For what it worth, I just hot glued the TCXO to the bottom of the HackRF right next to the header pins.  Then three jumpers, power, GND, and clock output, over to the bottom of the board on those respective pins.  keep the wires short.

jboone, 2019-01-15:
Support for external clock reference, and the clock reference on new PortaPacks, has been tested and is present in the latest builds of this firmware. HAVOC has a pending pull request (update) that should similarly address this issue. I'm going to close this. If y'all have the time to test, please do. Otherwise, look for a firmware release in the next couple of days.

Closed 2019-01-15.

Thread 129 (2018-12-15):

Streaming broken when in HackRF mode.

jboone, 2018-12-15:
@TheCranston reports: "this code has been working fine while in Portapack mode, but once i switch into hackrf mode I am unable to receive RF stream data from the unit. hackrf_info, hackrf_debug, and the other tools recognize it, but SDR apps are not receive a stream from it. reversion to hackrf released firmware and data begins to stream once more. Happy to help with any testing. thanks."

jboone, 2018-12-16:
@TheCranston I have a build that tests well here. Please give it a try and let me know if it addresses your issue: https://portapack-h1-builds.s3.amazonaws.com/sharebrained/portapack-hackrf/176/176.1/build/firmware/portapack-h1-firmware-90f64a6.tar.bz2

TheCranston, 2018-12-17:
@jboone I gave the version you linked a try and in hackrf mode I still do not get any streaming.  hackrf_sweep reports it could not transfer any data for one second and errors out.  hackrf_info reports the device.  in portapack mode it shows git version ending in 64a6.  pushing @mossmann's 2018.01.1 firmware and I'm back in business.  My TCXO is glued to the bottom of the main hackrf board with jumpers soldered so it's on and active as soon as +5v hits the board.  The si5351c does show that the external CLK is selected [0] -> 0x01.

jboone, 2018-12-18:
@TheCranston Blast. OK. To summarize the situation:

* If you load HackRF firmware into flash, everything works as expected.
* If you use the latest PortaPack firmware release or the build I provided you a few days ago, PortaPack mode works fine. HackRF mode apparently does not return samples to a USB-connected host, but all non-streaming HackRF command-line tools function as expected.

Can you remind me of the revision of your PortaPack (eight digit number, YYYYMMDD, printed near the LCD panel), and what operating system you're using for HackRF stuff? This interim firmware wasn't regression-tested with pre-2017 PortaPacks, though I'm hard-pressed to think of why that would cause an issue.

Also, can you re-program the CPLD flash bitstream with the file provided in the HackRF 2018.01.1 release, just in case it got out of sync? Though that wouldn't explain why HackRF from PortaPack mode doesn't work while the HackRF-only flash image works fine... It has to be a hardware initialization issue.

Latest firmware build is here, but there aren't any changes that would obviously impact your problem: https://s3.amazonaws.com/portapack-h1-builds/sharebrained/portapack-hackrf/178/178.1/build/firmware/portapack-h1-firmware-2c3a0c4.tar.bz2

TheCranston, 2018-12-19:
@jboone The portapack is a 20170522 reversion unit.  I'm using both Win10 and Ubuntu, primarily Ubuntu for the tools.
Your summary of the conditions are exactly correct.  The cli tools all are happy to talk with the hackrf, but anything that opens up a stream fails.

The PortaPack Setup -> Frequency Correction screen indicates "External" and "10000000"

I've re-programed the CPLD a few times, but gave it another shot based on your request.  Now it works..  something must have borked up the CPLD..

I'll continue to test, but I think the issue is resolved..  thanks!

jboone, 2018-12-19:
Well... w00t! Please let me know how the testing goes. I'll close this in a week or so if I don't hear from you. Thanks for testing! And this is another +1 for both PortaPack and HackRF firmware doing some CPLD validation.

jboone, 2019-01-15:
Seems resolved. Closing.

TheCranston, 2019-01-15:
Concur, it's goodness.  sorry for the delay in confirmation.  issue resolved.

Closed 2019-01-15.

Thread 131 (2019-01-11):

CLPD

ryanrohypnol, 2019-01-11:
I put an old CLPD on my new Portapack, do you mind uploading the .xsvf that it came with (I received the device 3 days ago). I think that is causing my freezing issues. I don't have Ubuntu or I'd attempt to build it myself.

Thank you!

jboone, 2019-01-15:
Solved out of band. Closing.

Closed 2019-01-15.

Thread 132 (2019-01-16):

Build failing on hackrf?

unixpunk, 2019-01-16:
So, after having trouble trying to merge things into havoc, because I'm a git novice, I instead cloned your repo and did the usual build dir cmake stuff, but make firmware is failing for me on the hackrf stuff.  Not sure what I'm missing, I have independently cloned and built the hackrf stuff without issue so I know I have all the req's.  (I also never had this issue when building havoc, seems it doesn't do this step)
`
Scanning dependencies of target hackrf
[  0%] Creating directories for 'hackrf'
[  0%] Performing download step (git clone) for 'hackrf'
Cloning into 'hackrf'...
Note: checking out 'origin/portapack_ui'.

You are in 'detached HEAD' state. You can look around, make experimental
changes and commit them, and you can discard any commits you make in this
state without impacting any branches by performing another checkout.

If you want to create a new branch to retain commits you create, you may
do so (now or later) by using -b with the checkout command again. Example:

  git checkout -b <new-branch-name>

HEAD is now at 3932c56... PortaPack: Add .SVF of current JEDEC bitstream file.
Submodule 'firmware/libopencm3' (https://github.com/mossmann/libopencm3.git) registered for path 'firmware/libopencm3'
Submodule 'hardware/gsg-kicad-lib' (https://github.com/greatscottgadgets/gsg-kicad-lib.git) registered for path 'hardware/gsg-kicad-lib'
Cloning into 'firmware/libopencm3'...
Submodule path 'firmware/libopencm3': checked out 'c9f40aae0ba25f1ffb7f2a49e050fd50714d0632'
Cloning into 'hardware/gsg-kicad-lib'...
Submodule path 'hardware/gsg-kicad-lib': checked out 'e02e7855c2f9b5653b958dab6d4e0d97eade7166'
[  0%] No patch step for 'hackrf'
[  1%] Performing update step for 'hackrf'
Current branch HEAD is up to date.
[  1%] Performing configure step for 'hackrf'
CMake Error: The source directory "/home/steve/Desktop/SDR/portapack-hackrf/build/firmware/hackrf-prefix/src/hackrf" does not appear to contain CMakeLists.txt.
Specify --help for usage, or press the help button on the CMake GUI.
firmware/CMakeFiles/hackrf.dir/build.make:105: recipe for target 'firmware/hackrf-prefix/src/hackrf-stamp/hackrf-configure' failed
make[2]: *** [firmware/hackrf-prefix/src/hackrf-stamp/hackrf-configure] Error 1
CMakeFiles/Makefile2:93: recipe for target 'firmware/CMakeFiles/hackrf.dir/all' failed
make[1]: *** [firmware/CMakeFiles/hackrf.dir/all] Error 2
Makefile:83: recipe for target 'all' failed
make: *** [all] Error 2
`

unixpunk, 2019-01-16:
To point out, the message is correct, hackrf does not contain CMakeLists.txt, only the firmware, tools folders do.

unixpunk, 2019-01-20:
If you want to fix on this with your other CPLD work on Monday, I found a fix after running cmake.  I edited firmware/CMakeFiles/hackrf.dir/build.make in my build directory and changed line 106 from
`cd /my/build/path/portapack-havoc/build/firmware/hackrf-prefix/src/hackrf-build && /usr/bin/cmake -DUSER_INTERFACE=PORTAPACK SOURCE_SUBDIR firmware/hackrf_usb "-GUnix Makefiles" /my/build/path/portapack-havoc/build/firmware/hackrf-prefix/src/hackrf`

To instead be:
`cd /my/build/path/portapack-havoc/build/firmware/hackrf-prefix/src/hackrf-build && /usr/bin/cmake -DUSER_INTERFACE=PORTAPACK SOURCE_SUBDIR firmware/hackrf_usb "-GUnix Makefiles" /my/build/path/portapack-havoc/build/firmware/hackrf-prefix/src/hackrf/firmware/hackrf_usb`
Adding in the missing ending `/firmware/hackrf_usb`.  I'm just not sure how to do this in the cmake files BEFORE running cmake so I won't attempt a pull request.  Based on this I'm guessing you'll know where to properly make the change.  Thanks for all the work on this!  Let me know if I can (try to) help further!

unixpunk, 2019-01-23:
FYI, still no dice here, actually worse now with latest pull from jboone/portapack-havoc, I can't evenworkaround it now.  Maybe I'm missing something?  git clone;mkdir build;cd build;cmake ..;make firmware -> fail within hackrf again, this time other errors even after I fix the above as described.  I have the same issue with portapack-hackrf after latest pull as well.

[ 26%] No patch step for 'hackrf'
[ 26%] Performing update step for 'hackrf'
Current branch master is up to date.
[ 27%] Performing configure step for 'hackrf'
-- Cross-compiling with the gcc-arm-embedded toolchain
-- Toolchain prefix: /usr/arm-none-eabi
CMake Error at /home/user/Desktop/SDR/portapack-havoc/build/firmware/hackrf-prefix/src/hackrf/firmware/hackrf-common.cmake:30 (include):
  include could not find load file:

    /dfu-util.cmake
Call Stack (most recent call first):
  CMakeLists.txt:26 (include)

CMake Error at /home/user/Desktop/SDR/portapack-havoc/build/firmware/hackrf-prefix/src/hackrf/firmware/hackrf-common.cmake:105 (include_directories):
  include_directories given empty-string as include directory.
Call Stack (most recent call first):
  CMakeLists.txt:26 (include)

CMake Error: File /m0_bin.s.cmake does not exist.
CMake Error at /home/user/Desktop/SDR/portapack-havoc/build/firmware/hackrf-prefix/src/hackrf/firmware/hackrf-common.cmake:149 (configure_file):
  configure_file Problem configuring file
Call Stack (most recent call first):
  CMakeLists.txt:57 (DeclareTargets)

-- Configuring incomplete, errors occurred!
See also "/home/user/Desktop/SDR/portapack-havoc/build/firmware/hackrf-prefix/src/hackrf-build/CMakeFiles/CMakeOutput.log".
See also "/home/user/Desktop/SDR/portapack-havoc/build/firmware/hackrf-prefix/src/hackrf-build/CMakeFiles/CMakeError.log".
make[3]: *** [firmware/hackrf-prefix/src/hackrf-stamp/hackrf-configure] Error 1
firmware/CMakeFiles/hackrf.dir/build.make:105: recipe for target 'firmware/hackrf-prefix/src/hackrf-stamp/hackrf-configure' failed
make[2]: *** [firmware/CMakeFiles/hackrf.dir/all] Error 2
CMakeFiles/Makefile2:93: recipe for target 'firmware/CMakeFiles/hackrf.dir/all' failed
make[1]: *** [firmware/CMakeFiles/firmware.dir/rule] Error 2
CMakeFiles/Makefile2:138: recipe for target 'firmware/CMakeFiles/firmware.dir/rule' failed
make: *** [firmware] Error 2
Makefile:131: recipe for target 'firmware' failed

I also get it trying to do what I think your cmake is doing:
user@pc:~/Desktop/SDR/portapack-hackrf/build/firmware/hackrf-prefix/src/hackrf-build$ cmake ../hackrf/firmware/hackrf_usb

jboone, 2019-01-23:
OK, I couldn't let this go. So I believe I fixed it both in this repo, and in my fork of portapack-havoc. I even tested it first! Give it another try and let me know how it goes.

jboone, 2019-01-24:
I'm stumped -- it's built clean for me and a couple other people since yesterday.

Can you capture a complete log of commands and output, starting from nothing, and drop it on PasteBin? Having a complete transcript of the process should help me quickly reproduce the issue and identify the problem. Your operating system and CMake version might also come in handy.

jboone, 2019-01-24:
So, one thing I've observed: The ExternalProject_Add CMake command doesn't support SOURCE_SUBDIR until version 3.7. That's what allows me to dig into the HackRF firmware subdirectory and build from there. I'll look for an alternative, since it'd be a bummer to require 3.7 when Ubuntu 16.04 has 3.5. Ubuntu 16.04 isn't *that* old...

unixpunk, 2019-01-24:
Ah, interesting, nice find!  Ya, 16.04 LTS still supported.  :)

unixpunk, 2019-01-24:
I miss the good ole days of ./configure && make...cmake seems so overly complicated sometimes.  :)

jboone, 2019-01-24:
I'm looking for a fix. Just using SOURCE_DIR doesn't do it. The best solution may be to introduce a top-level CMakeLists.txt for HackRF. I'm not sure why it doesn't have one.

> I miss the good ole days of ./configure && make...cmake seems so overly complicated sometimes. :)

Agreed. It helped with some host operating system complications on the HackRF project -- like not needing to know how to build on Windows. But it's complicated and weird and inconsistent in so many ways. It may be more trouble than it's worth in this case, but I'm not about to upend things again right now. :-)

unixpunk, 2019-01-24:
The only thing you're building is hackrf/firmware/hackrf_usb so if you can get your code to go straight there instead, that should work, aside from maybe my other comment about the variable and /dfu-util.cmake not being found.  Before you tried to fix this, i was able to workaround it by editing the file as noted above, but after your attempt, I could no longer even do that.  Not sure if those details help or not.  Referring to my comment on the 20th.  Whatever was changed after that broke my workaround too.  Anyway, no rush, done for the night.  Thanks again!

jboone, 2019-01-24:
I made a change 13 hours ago that does not use the SOURCE_SUBDIR variable introduced in CMake 3.7. I've tested the change locally and on Travis-CI, and it appears to work. Please pull a fresh copy of the master branch of this repo and let me know if it works for you.

unixpunk, 2019-01-25:
You're the man!  That did it!  Tested both portapack-hackrf and your fork of portapack-havoc.  Thanks again for knocking this out!

Closed 2019-01-25.

Thread 133 (2019-01-19):

Possible to make Portapack recieve drone camera video?

Zeeko22, 2019-01-19:
I wonder if it possible to get portapack able to recieve dronecamera transmitting videos, i think it would match and be very intresting .. Have anyone suggetion if i can download any software that can make this possible?

jboone, 2019-01-24:
Hi @Zeeko22. It depends on the drone. Do you have any information on the transmitter used on the drone?

I have seen drones that use 5.8 GHz transmitters to send NTSC-type signals that are frequency modulated. It might be possible to decode that -- maybe not at the full frame rate, or full resolution, or in color. A lot of code would need to be written to accomplish that, but I believe it would be possible.

Closed 2019-03-21.

Thread 134 (2019-02-27):

I update the firmware, ,but the screen is always blank.

freeworld1981, 2019-02-27:
I updated the firmware and CPLD, all successfully ,but the screen is always blank, dark no light.

the led only green/yellow/red light.

where is the problem?

jboone, 2019-03-21:
@freeworld1981 It's hard to say. Which LEDs are lit? Just the 3V3, 1V8, and RF power LEDs? Or are the USB (green), RX (yellow), or TX (red) LEDs also lit?

Which version of PortaPack firmware are you using? Is it a released version, or are you compiling it yourself?

Which PortaPack hardware revision are you using? There's a date code on the front of the PortaPack, near the LCD panel.

pipi111, 2019-03-29:
same here i have githus 5ec8164e
latest portapack hardare version
latest firmware
downloaded from original source

kevtheskin, 2019-04-26:
Hello Jared, Im have the same problem. I tried the havoc software and i think my unit is a brick now?. Cheers Kev

jboone, 2019-05-07:
@kevtheskin, @pipi111, @freeworld1981: Please try the latest released PortaPack firmware and report your results: https://github.com/sharebrained/portapack-hackrf/releases/tag/20190405

jboone, 2019-11-16:
Are your problems resolved by using the release firmware?

jboone, 2020-01-24:
No action on this thread. Closing.

Mars0117, 2020-02-26:
Hi.
I faced that problem. Original firmware not working https://github.com/sharebrained/portapack-hackrf/releases/tag/20190405.
Before the problem the original firmware and havoc worked.

millercontracting2017, 2021-04-06:
Same problem here also any fix yet?

Closed 2020-01-24.

Thread 136 (2019-03-04):

External clock

cosmo6110, 2019-03-04:
Portapac H1 batch 20181029.
The firmware is not detecting the 2.5ppm TCXO clock
I have compiled from difference source "jboone(Furrtek),  Furrtek and sharebrained same problem.
With this patch the hackerf mode detect the clock https://github.com/sharebrained/portapack-hackrf/commit/01bad2805c633b4d53f59a28ec99f3f16e61c41d
but have other issues.
My system is 4.18.0-kali2-amd64,
compiler gcc version 7.3.1 20180622 (release) [ARM/embedded-7-branch revision 261907.

Is it anything i can try to get the software to detect the hardware clock?
br tommy

jboone, 2019-03-21:
@cosmo6110 Sorry for the delay. There were still a couple of bugs around the TCXO feature. I believe I have them addressed now. Please try this latest build of PortaPack:

https://portapack-h1-builds.s3.amazonaws.com/sharebrained/portapack-hackrf/202/202.1/build/firmware/portapack-h1-firmware-3b6fce7.tar.bz2

...or change ".bz2" to ".zip" if you prefer a zip file.

You should see the selected clock source in the PortaPack Setup -> Frequency Correction "Reference Source".

cosmo6110, 2019-03-22:
Hi!
I tried your latest build and i got the  TCXO to show up in the Frequency Correction.
So far so good. In the  hackrf mode, is not working.
hackrf_debug --si5351c -n 0 -r
[  0] -> 0x51

In the latest build my serial number says: Serial number: RunningFromRAM.

hackrf_info version: git-4507130
libhackrf version: git-4507130 (0.5)
Found HackRF
Index: 0
Serial number: RunningFromRAM
Board ID Number: 2 (HackRF One)
Firmware Version: git-6e5b31d (API:1.03)
Part ID Number: 0xa000cb3c 0x00754f5a
CPLD checksum: 0x8b150ff6

br Tommy

jboone, 2019-03-22:
@cosmo6110 Try transmitting or receiving with hackrf_transfer first. Then check with hackrf_debug. The "activate_best_clock_source" function is only called when entering transit or receive mode. So until you receive or transmit, no external clock detection occurs.

You may also want to try my build of firmware from yesterday, as I added an icon on to the PortaPack while in HackRF mode that indicates the clock source:

https://portapack-h1-builds.s3.amazonaws.com/sharebrained/portapack-hackrf/204/204.1/build/firmware/portapack-h1-firmware-3b6fce7.tar.bz2

If hackrf_info reports "RunningFromRAM", that's because you a running firmware in RAM using dfu-util. Program the .bin file using hackrf_spiflash if you want to upgrade the flash to the new firmware.

cosmo6110, 2019-03-23:
@jboone
Yes, tried your new firmware, it's working nice.I can see the new  icon in the right corner PPK.
hackrf_debug --si5351c -n 0 -r
[  0] -> 0x01

I got a weird error, when i run hackrf_spiflash -w portapack-h1-firmware.bin
it  running the firmware in RAM.

when i run the official  hackrf-2018.01.1/firmware-bin
and older release of  havoc firmware
It,s running normal.

Cant update the hackrf_usb.dfu ...
dfu-util --device 1fc9:000c --alt 0 --download hackrf_usb.dfu

dfu-util 0.9
Download	[=========================] 100%        34324 bytes
Download done.
dfu-util: unable to read DFU status after completion

It stays in the  dfu mode
Manufacturer: NXP
[16145.427491] usb 1-1.3: SerialNumber: ABCD
[16158.665617] usb 1-1.3: USB disconnect, device number 26

cosmo6110, 2019-03-23:
@jboone
I'm learning about DFU mode. :)

Did more test, The DFU mode working with the original hackrf-2018.01.1  bin files. ok
Not the newer one, portapack-hackrf.

hackrf_spiflash -w not working correct with my hardware it running the program ifrom flash without DFU mode,
Older releases 10 weeks ago working from flash.
The last hackrf firmware working from flash.

cosmo6110, 2019-03-25:
I compile latest mossmann/hackrf.
Kali  4.19.0-kali3-amd64
and programmed it to the flash memory.
Maybe it doesn't matter?
The fork (hackrf) says it running from ram?
**hackrf_info version: git-eae870d**
libhackrf version: git-eae870d (0.5)
Found HackRF
Index: 0
Serial number: 000000000000000087c867dc2a22575f
Board ID Number: 2 (HackRF One)
Firmware Version: git-509c8f4 (API:1.03)
Part ID Number: 0xa000cb3c 0x00754f5a
CPLD checksum: 0x05829db7

https://github.com/jboone/hackrf

**hackrf_info version: git-eae870d**
libhackrf version: git-eae870d (0.5)
Found HackRF
Index: 0
Serial number: RunningFromRAM
Board ID Number: 2 (HackRF One)
Firmware Version: git-1b7ef42 (API:1.03)
Part ID Number: 0xa000cb3c 0x00754f5a
CPLD checksum: 0x05829db7

jboone, 2019-03-25:
@cosmo6110 I've identified the issue. It's a bug and a regression. The short story: PortaPack firmware uses a DFU version of the HackRF firmware for "HackRF Mode". This version of the HackRF firmware reports "RunningFromRAM" for a serial number, I guess as a way to tell you're in DFU mode, not running from flash. Everything else is correct, it's just that when PortaPack runs that DFU code, the serial number should be reported, not "RunningFromRAM". It was fixed back when the PortaPack code in HackRF was optional. It's since become baked-in, and that's where the regression happened. I'm identifying a way to fix this (again), and avoid it happening again -- please see new issue
#137.

Thanks for the report! I'm closing this issue, as I believe the original issue is resolved.

Closed 2019-03-25.

Thread 138 (2019-05-09):

No HackRF boards found

xvostikk, 2019-05-09:
We are trying to download a firmware to our PortaPack H1 with HackRF One. In DFU Modus we see our device:
```
dfu-util -l

dfu-util 0.9

Found DFU: [1fc9:000c] ver=0100, devnum=9, cfg=1, intf=0, path="20-6.4.2", alt=0, name="DFU", serial="ABCD"
```
We can successfully download the hackrf_usb.dfu image on device. But we can't flash it as it written in the step  with hackrf_spiflash: ```No HackRF boards found.```

HackRF tools are up-to-date. All USB ports working. We tried this as in macOS and also in Ubuntu.

I also create rules as it is described in FAQs (https://github.com/mossmann/hackrf/wiki/FAQ) and have all permissions. I am really desperate.

Can you help?

stephantual, 2019-06-01:
Here's a bit of help - as i struggled with the same issue.
I imagine  you find yourself with a box in a 'dead' state, with a black screen, so hackrf_spi can't find the board but putting the portapack/hackrf in dfu mode allows you to list it.

So, to solve this, this is what i did:
- dfu upload the standard h1, this should be a good basis to get started
- spi flash the standard portapack . this gives you back access to the hackrf_spi tool
- now, put the portapack in standard hackrf mode (important step!)
- finally, unplug, put in dfu, plug back and DO NOT use the spi tool to flash to havoc, instead, go to your  havoc build folder and 'make program'.
- the above step might take a few tries to get right - because if it fails at any point, it bounces your device out of dfu and back to black screen. So try the above steps until make program executes without error-
- once you have acheived an error less 'make program', it will detect your dfued hack rf, and you will see the following (if all goes well):

`[100%] Built target application.elf
[100%] Built target application
dfu-util 0.9

Copyright 2005-2009 Weston Schmidt, Harald Welte and OpenMoko Inc.
Copyright 2010-2016 Tormod Volden and Stefan Schmidt
This program is Free Software and has ABSOLUTELY NO WARRANTY
Please report bugs to http://sourceforge.net/p/dfu-util/tickets/

dfu-util: DFU suffix CRC does not match
dfu-util: A valid DFU suffix will be required in a future dfu-util release!!!
Opening DFU capable USB device...
ID 1fc9:000c
Run-time device DFU version 0100
Claiming USB DFU Interface...
Setting Alternate Setting #0 ...
Determining device status: state = dfuIDLE, status = 0
dfuIDLE, continuing
DFU mode device DFU version 0100
Device returned transfer size 2048
Copying data from PC to DFU device
Download        [=========================] 100%        35188 bytes
Download done.
dfu-util: unable to read DFU status after completion
File size 781884 bytes.
Checking target device compatibility
Erasing SPI flash.
Writing 781884 bytes at 0x000000.
[100%] Built target program
`

In other words, you are probably missing two steps; a) you need to put the portapack in hackrf mode b) don't try to spi flash havoc, instead, make program while in dfu

i hope this helps!

xvostikk, 2019-07-24:
Thanks for the reply. I did exactly what you have written. So after i put the device in dfu Mode and make command ```make program``` i had the output:
```
user@user:~/Git/portapack-havoc/build$ make program
[ 25%] Built target baseband_shared
[ 25%] Built target baseband_nfm_audio.elf
[ 25%] Performing update step for 'hackrf'
Aktueller Branch master ist auf dem neuesten Stand.
[ 26%] Performing configure step for 'hackrf'
-- Cross-compiling with the gcc-arm-embedded toolchain
-- Toolchain prefix: /usr/arm-none-eabi
-- Configuring done
-- Generating done
-- Build files have been written to: /home/administrator/Git/portapack-havoc/build/firmware/hackrf-prefix/src/hackrf-build
[ 26%] Performing build step for 'hackrf'
[ 15%] Built target libopencm3_hackrf_usb
[ 19%] Built target hackrf_usb_m0.elf
[ 19%] Built target hackrf_usb_m0.bin
[100%] Built target hackrf_usb_dfu_objects
[100%] Built target hackrf_usb_dfu.elf
[100%] Built target hackrf_usb_dfu.bin
dfu-suffix (dfu-util) 0.9

Copyright 2011-2012 Stefan Schmidt, 2013-2014 Tormod Volden
This program is Free Software and has ABSOLUTELY NO WARRANTY
Please report bugs to http://sourceforge.net/p/dfu-util/tickets/

Suffix successfully added to file
[100%] Built target hackrf_usb.dfu
[ 26%] No install step for 'hackrf'
[ 26%] Completed 'hackrf'
[ 27%] Built target hackrf
[ 27%] Built target baseband_wfm_audio.elf
[ 28%] Built target baseband_wideband_spectrum.elf
[ 28%] Built target baseband_sstvtx.elf
[ 29%] Built target baseband_test.elf
[ 29%] Built target baseband_siggen.elf
[ 30%] Built target baseband_pocsag.elf
[ 31%] Built target baseband_no_operation.elf
[ 32%] Built target baseband_tpms.elf
[ 32%] Built target baseband_afsktx.elf
[ 32%] Built target baseband_rds.elf
[ 33%] Built target baseband_afskrx.elf
[ 34%] Built target baseband_fsktx.elf
[ 34%] Built target baseband_tones.elf
[ 34%] Built target baseband_adsbtx.elf
[ 35%] Built target baseband_adsbrx.elf
[ 35%] Built target baseband_ook.elf
[ 35%] Built target baseband_ais.elf
[ 36%] Built target baseband_am_audio.elf
[ 36%] Built target baseband_audio_tx.elf
[ 37%] Built target baseband_capture.elf
[ 37%] Built target baseband_jammer.elf
[ 37%] Built target baseband_replay.elf
[ 37%] Built target baseband_ert.elf
[ 38%] Built target baseband_sonde.elf
[ 38%] Built target baseband_acars.elf
[ 39%] Built target baseband_mic_tx.elf
[ 46%] Built target baseband
[100%] Built target application.elf
[100%] Built target application
dfu-util 0.9

Copyright 2005-2009 Weston Schmidt, Harald Welte and OpenMoko Inc.
Copyright 2010-2016 Tormod Volden and Stefan Schmidt
This program is Free Software and has ABSOLUTELY NO WARRANTY
Please report bugs to http://sourceforge.net/p/dfu-util/tickets/

dfu-util: DFU suffix CRC does not match
dfu-util: A valid DFU suffix will be required in a future dfu-util release!!!
Opening DFU capable USB device...
ID 1fc9:000c
Run-time device DFU version 0100
Claiming USB DFU Interface...
Setting Alternate Setting #0 ...
Determining device status: state = dfuIDLE, status = 0
dfuIDLE, continuing
DFU mode device DFU version 0100
Device returned transfer size 2048
Copying data from PC to DFU device
Download	[=========================] 100%        35188 bytes
Download done.
dfu-util: unable to read DFU status after completion
File size 767068 bytes.
hackrf_open() failed: HackRF not found (-5)
firmware/CMakeFiles/program.dir/build.make:57: recipe for target 'firmware/CMakeFiles/program' failed
make[3]: *** [firmware/CMakeFiles/program] Error 1
CMakeFiles/Makefile2:127: recipe for target 'firmware/CMakeFiles/program.dir/all' failed
make[2]: *** [firmware/CMakeFiles/program.dir/all] Error 2
CMakeFiles/Makefile2:134: recipe for target 'firmware/CMakeFiles/program.dir/rule' failed
make[1]: *** [firmware/CMakeFiles/program.dir/rule] Error 2
Makefile:131: recipe for target 'program' failed
make: *** [program] Error 2
```
For me seems like the program change then hackrf Mode and can not find the device.
After some tryings i did as it stays here: https://github.com/furrtek/portapack-havoc/wiki/Flashing:
"Alternatively, the HackRF may be flashed using the HackRF mode from PortaPack's menu:
```hackrf_spiflash -w portapack-h1-havoc.bin```". Of course now in hackrf Mode.

I am really irritated what is the right Method and why it doesn't work in other way. But it seems working.

Thank you for the answer!

jboone, 2019-11-16:
I'm sorry for the delay.

I am wondering if the delay in the firmware/CMakeLists.txt:program target is sufficient on your machine. Perhaps it takes your computer more than three seconds to enumerate the HackRF once it leaves DFU mode and enters HackRF mode. Try changing the "sleep 3s" to "sleep 15s" and see if that has an effect?

jboone, 2020-02-05:
No response. Closing.

Closed 2020-02-05.

Thread 139 (2019-06-25):

c16 files format

VeloVolo, 2019-06-25:
Could not figure how to import recorded c16 files into gnuradio. Trying to set "source file" and "throttle" blocks, but do not see proper waterfall chart. What data contain these files? complex, float..?
Could not find any information about these files.

jboone, 2019-11-16:
Sorry for the delay.

These are 16-bit signed integers. Two 16-bit signed integers make up one complex (IQ) pair -- one complex sample. I would recommend using the "IShort to Complex" block to do this. You may also need to multiply by a constant (e.g. 1.0 / 32768.0) to normalize the complex float samples to +/- 1.0.

I hope that helps.

Closed 2019-11-16.

Thread 143 (2019-09-13):

RTC and Settings are not retained, despite backup battery

bicurico, 2019-09-13:
Hi,

On my HackRF One + Portapack, after making sure the Lithium CR2032 backup battery is correctly inserted and working, I noticed that the RTC Time and Date, as well as, all settings, are not retained after disconnecting the USB power.

I tried with the official Portapack firmware and with Havok and the result is the same.

Can it be a fault on the HackRF One (which is a clone of the newer type)? If so, what component could be broken or at fault? The time itself can be set and does work, as long as USB power is present.

Could this be a FW issue (corrupted data)?

Thanks,
Vitor

bicurico, 2019-09-13:
I found out what the problem was:

The HackRF One used with the Portapack has a shield around the RF part. This shield is exactly opposite to the backup battery.

When looking closely I noticed that the pins that hold the (+) side of the Lithium battery were touching the shield, thus short-circuiting the battery and causing the memory loss.

By bending the pins over the battery, this was fixed and the HackRF One + Portapack are correctly retaining settings and RTC time+date.

I leave this solution for fellow users with the same problem. It is down to the Lithium battery cell holder, which comes with unbended pins.

Regards,
Vitor

Closed 2019-09-13.

Thread 145 (2019-11-28):

reflash firmware using windoes?

kiwiandy, 2019-11-28:
I have uploaded hackrf_one_usb.dfu to my device using DF-UTIL command line on my Windows PC.

How do I get get the Portapack code flashed into the SPI flash?

Macintoshsh, 2019-11-29:
https://github.com/sharebrained/portapack-hackrf/wiki/Updating%20Firmware%20Windows

Sent from  iPhone A_Macintosh
nr +79268246716

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

kiwiandy, 2019-11-29:
> https://github.com/sharebrained/portapack-hackrf/wiki/Updating%20Firmware%20Windows Sent from iPhone A_Macintosh nr +79268246716
> […](#)
> 29 нояб. 2019 г., в 01:28, kiwiandy ***@***.***> написал(а):   I have uploaded hackrf_one_usb.dfu to my device using DF-UTIL command line on my Windows PC. How do I get get the Portapack code flashed into the SPI flash? — You are receiving this because you are subscribed to this thread. Reply to this email directly, view it on GitHub, or unsubscribe.

Thanks but as my screen is blank on the Portapack, I cannot set the portapack to HACKRF mode so that I can use that tool!

Macintoshsh, 2019-11-29:
So it’s tool don’t using screen portapack. It’s flashing from computer.
I’m flash from Ubuntu and dfu utils.
I’m connect and flashing HACKRf  and  portapack.
After flashing all start.

Sent from  iPhone A_Macintosh
nr +79268246716

> 29 нояб. 2019 г., в 21:16, kiwiandy <notifications@github.com> написал(а):
>
> Thanks but as my screen is blank on the Portapack, I cannot set the portapack to HACKRF mode so that I can use that tool

jboone, 2020-01-24:
Good answer. A demo of how to do Windows flashing is here: https://www.youtube.com/watch?v=5G5blPPIIBo

Since there was no reply, I'm going to call this one closed.

Closed 2020-01-24.

Thread 146 (2020-01-01):

Portapack without case

pawel37, 2020-01-01:
sharebrained in the store can u put hackrf there without a case for 59 bucks pls then i the  have the money to buy it.
Thanks

DinBan, 2020-01-11:
I bought mine on Aliexpress, cost about $60, works good

jboone, 2020-01-24:
@pawel37 Sorry for the delay. I will follow up by email, which is the better avenue for this discussion

Closed 2020-01-24.

Thread 148 (2020-01-21):

QUESTION - SWR meter option possible?

DinBan, 2020-01-21:
Hello, is there any way to add to Portapack firmware SWR/VNA menu/option in future?
I found that HackRF/SDR can be user as SWR meter with cheap noise source -
https://www.rtl-sdr.com/measuring-the-swr-of-fpv-antennas-with-an-rtl-sdr/
https://www.rtl-sdr.com/rtl-sdr-tutorial-measuring-filter-characteristics-and-antenna-vswr-with-an-rtl-sdr-and-noise-source/
Also found on GitHub some hackrf_antenna_swr_utility -
https://github.com/coddingtonbear/hackrf-antenna-swr-utility/tree/master/hackrf_antenna_swr_utility
I think it would be nice and useful option if it possible.
Thank you!

DinBan, 2020-02-05:
Any answer? Hello?

jboone, 2020-02-05:
I agree it would be useful. I only think an SWR meter is feasible. A VNA would require two HackRFs and some extensive hardware modifications.

For an SWR meter using a noise source, it sounds like what is needed is a baseline difference function on the spectrum display. A sweeping spectrum analyzer like what is done with hackrf_sweep would be useful to extend the frequency range of the analyzer beyond the 20MHz bandwidth of the baseband ADCs.

Thread 149 (2020-01-27):

HackRF mode: gains displayed incorrectly during T/R switching

argilo, 2020-01-27:
I'm working on adding transmit/receive switching capability into gr-osmosdr (https://github.com/osmocom/gr-osmosdr/compare/gr3.8...argilo:hackrf-allow-tr-switching-38), and noticed that the Portapack does not correctly update the displayed gains when switching between transmit & receive mode.

When returning from transmit to receive mode, the BB gain display remains blank until the next time it is adjusted. When switching in either direction, the IF gain display does not update unless the TX IF gain or RX IF gain were adjusted prior to the switch.

One possible solution would be to update all gain displays whenever switching from transmit to receive or vice versa.

jboone, 2020-02-04:
Argh. Thanks for the heads-up. I will take a look at it, hopefully before GSG ships their firmware release, as the affected code is actually in the HackRF repo.

argilo, 2020-02-05:
In case it helps with testing, the T/R switching code is now merged into the gr3.8 branch of gr-osmosdr:

http://git.osmocom.org/gr-osmosdr/commit/?h=gr3.8&id=42ed7c4d99809c619fb386d89fabd82509901656

jboone, 2020-02-08:
Well, I finally got a working GR 3.8 install. *whew* I'll have a look tomorrow.

Thread 150 (2020-02-03):

Touch Screen

Jean-france, 2020-02-03:
Hi,
I have HAVOC firmware on my HK. The touch screen doesn't work. Impossible to calibrate it, nothing do even i touch the screen.
Do you have a idea ?
Many thanks in advance.
Best regards,
Jean

jboone, 2020-02-04:
If you go into "Receivers", "Audio", highlight the frequeny, and press the select button, you will get a number entry screen. If you touch the screen, does the PortaPack respond to your touches?

Jean-france, 2020-02-05:
Thanks for your reply.

No, nothing, no response.
Same thing if i go to setting the touch screen, no response if i touch the cross

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

jboone, 2020-02-05:
Can you tell me which version of HAVOC you are using? You can find the version in the "About" item in the main menu.

Does the problem exist if you use my "official" firmware? Here's a link to the latest release: https://github.com/sharebrained/portapack-hackrf/releases/tag/20190405

Where did you buy this PortaPack? Which version of hardware is it? The hardware version number is written on the circuit board, along the top-left edge of the LCD screen.

Jean-france, 2020-02-06:
Version of HAVOC : Git hash dc5d6fe
I don’t know i didn’t try with “official” firmware.
I bought my PortaPack on Ebay
version number : 20181029

Thanks for your help.

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

jboone, 2020-02-06:
I would recommend trying a newer version of HAVOC or trying with the official firmware just to ensure there's no issue with that particular version of firmware.

I can confirm for the PortaPacks that I make that the touch screen works for the latest HAVOC and official firmware. So if those do not work for you, you probably have a hardware issue and should contact the eBay seller for a repair or replacement.

Jean-france, 2020-02-06:
OK Jared, thanks for your reply.
Can you send me the latest HAVOC firmware, please ?

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

jboone, 2020-02-06:
I have continuous integration builds of the latest HAVOC code here:

https://jboone.github.io/portapack-havoc-nightly/

Jean-france, 2020-02-06:
Many thanks !
I will instal the 26/09/2019 firmware version

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

Jean-france, 2020-02-06:
Could you please send me the  link for download the latest version of ExtIO_harcrf, please.
Sorry to disturbe you.

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

jboone, 2020-02-06:
Do you mean this? https://github.com/jocover/ExtIO_HackRF

I don't know what that is, but hopefully the link helps.

Jean-france, 2020-02-11:
Hi,The new firmware 79baef7 doesn't work !If you choice "capture" the device is blocked! You have to disconnect it .What's wrong?Thanks in advance 
-------- Message d'origine --------De : Jared Boone <notifications@github.com> Date : 06/02/2020  19:21  (GMT+01:00) À : sharebrained/portapack-hackrf <portapack-hackrf@noreply.github.com> Cc : Jean-france <keriolet@wanadoo.fr>, Author <author@noreply.github.com> Objet : Re: [sharebrained/portapack-hackrf] Touch Screen (#150) I have continuous integration builds of the latest HAVOC code here:
https://jboone.github.io/portapack-havoc-nightly/

—You are receiving this because you authored the thread.Reply to this email directly, view it on GitHub, or unsubscribe.
[
{
"@context": "http://schema.org",
"@type": "EmailMessage",
"potentialAction": {
"@type": "ViewAction",
"target": "https://github.com/sharebrained/portapack-hackrf/issues/150?email_source=notifications\u0026email_token=AONV3ZKI54F3YAWXHFRCEZDRBRIK3A5CNFSM4KPIRXZKYY3PNVWWK3TUL52HS4DFVREXG43VMVBW63LNMVXHJKTDN5WW2ZLOORPWSZGOELAIDJY#issuecomment-583041447",
"url": "https://github.com/sharebrained/portapack-hackrf/issues/150?email_source=notifications\u0026email_token=AONV3ZKI54F3YAWXHFRCEZDRBRIK3A5CNFSM4KPIRXZKYY3PNVWWK3TUL52HS4DFVREXG43VMVBW63LNMVXHJKTDN5WW2ZLOORPWSZGOELAIDJY#issuecomment-583041447",
"name": "View Issue"
},
"description": "View this Issue on GitHub",
"publisher": {
"@type": "Organization",
"name": "GitHub",
"url": "https://github.com"
}
}
]

Jean-france, 2020-02-11:
So sorry, the new firmware work !It's my fault... pardon.
-------- Message d'origine --------De : Jared Boone <notifications@github.com> Date : 06/02/2020  19:21  (GMT+01:00) À : sharebrained/portapack-hackrf <portapack-hackrf@noreply.github.com> Cc : Jean-france <keriolet@wanadoo.fr>, Author <author@noreply.github.com> Objet : Re: [sharebrained/portapack-hackrf] Touch Screen (#150) I have continuous integration builds of the latest HAVOC code here:
https://jboone.github.io/portapack-havoc-nightly/

—You are receiving this because you authored the thread.Reply to this email directly, view it on GitHub, or unsubscribe.
[
{
"@context": "http://schema.org",
"@type": "EmailMessage",
"potentialAction": {
"@type": "ViewAction",
"target": "https://github.com/sharebrained/portapack-hackrf/issues/150?email_source=notifications\u0026email_token=AONV3ZKI54F3YAWXHFRCEZDRBRIK3A5CNFSM4KPIRXZKYY3PNVWWK3TUL52HS4DFVREXG43VMVBW63LNMVXHJKTDN5WW2ZLOORPWSZGOELAIDJY#issuecomment-583041447",
"url": "https://github.com/sharebrained/portapack-hackrf/issues/150?email_source=notifications\u0026email_token=AONV3ZKI54F3YAWXHFRCEZDRBRIK3A5CNFSM4KPIRXZKYY3PNVWWK3TUL52HS4DFVREXG43VMVBW63LNMVXHJKTDN5WW2ZLOORPWSZGOELAIDJY#issuecomment-583041447",
"name": "View Issue"
},
"description": "View this Issue on GitHub",
"publisher": {
"@type": "Organization",
"name": "GitHub",
"url": "https://github.com"
}
}
]

jboone, 2020-03-20:
No activity, so I will assume the issue is resolved. Closing...

Closed 2020-03-20.

Thread 153 (2020-03-20):

Bq24075 bat charge on h1

antonlalala, 2020-03-20:
Hello friends, are there people who soldered bq24075? On h1
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
How will it even turn on? by pressing which button? I did not understand.

jboone, 2020-03-20:
Hi. Thank you for opening the issue here.

The news is not good. The battery feature was an experiment, and was never turned into a finished feature. So there is no way to turn the power on or off from the firmware.

antonlalala, 2020-03-20:
☹️😢

antonlalala, 2020-03-20:
GPS module for what purpose?

jboone, 2020-03-20:
Also an experiment. There is no firmware support for it, and I have not tested it at all.

antonlalala, 2020-03-20:
It would be nice to do GPS. Ais transponder, aprs ..

jboone, 2020-03-20:
True. There's probably also value to recording current location when logging data, and having precise time available.

antonlalala, 2020-03-20:
that would be great, as well as navigation

antonlalala, 2020-03-20:
going back to bq. If I solder it according to the scheme, then the device will be constantly on while the battery is charged? or will I ruin the device?

vasja2000, 2020-04-03:
hi! Colleagues, help me find the scheme exactly Portapack_h2. We need it.

jboone, 2020-04-03:
@vasja2000 You need to contact the people who make the H2. I have no information on the H2. It is a completely different design, as far as I can tell.

jboone, 2020-04-03:
@antonlalala Yes, the device will be on constantly, until the battery is discharged, or you plug in power to USB.

eried, 2020-04-06:
BTW the on off works perfectly on the H2, such a shame that the pcb is not available anywhere... (I wish there was a way to have battery level on the UI)

zhaohuansi, 2020-04-26:
The Chinese foundry is already produced. Give you a photo tomorrow.

cql1983, 2020-05-08:
>
>
> BTW the on off works perfectly on the H2, such a shame that the pcb is not available anywhere... (I wish there was a way to have battery level on the UI)

H2 doesn't exist. It's just a modified version based on H1 that a hobbyist added logic chips for switches.

eried, 2020-05-08:
> H2 doesn't exist.

On that ethereal non existant H2, on off works perfectly

cql1983, 2020-05-08:
Yes, you can visit :  https://market.m.taobao.com/app/idleFish-F2e/widle-taobao-rax/page-detail?id=596112633971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
H2 is Chinese fans modify.

antonlalala, 2020-05-13:
> Привет. Спасибо за открытие вопроса здесь.
>
> Новости не хорошие. Функция батареи была экспериментом и никогда не превращалась в готовую функцию. Так что нет возможности включить или выключить питание из прошивки.

can i put any dcdc converter between audio svdd and vbus? and switch to lipo?

zjywlive, 2020-08-03:
Hello everyone, I'm sorry this is a message translated by computer,I am familiar with this designer, and I am also involved in the design of some peripheral parts.

antonlalala, 2020-08-20:
No!

Thread 155 (2020-04-15):

Headphone Failure

SannhetJaeger, 2020-04-15:
Posted this initially in furrtek/portapack-havoc, but unsure if that is right place since the issue manifests on base portapack firmwares as well.

Think I am dealing with a defective portapack, but thought I would see if anyone has any ideas on steps to take to remedy or be sure its a hardware failure. Headphones produce no output, regardless of volume level. I've tried with several different firmwares (20170808, Havoc 1352e16 and a locally built Havoc from few days ago). Right now have the 20190405 installed. This is a 20181029 Blue Portapack board on a 10 Feb 2014 HackRF One. Debug of AK4951 shows all zeros(0).

Only reaction I can get is on microphone transmit - pressing the apple headset button makes the mic tx level bar come on if it wasn't there already (e.g. check / uncheck voice activated will make bar disappear). Unfortunately, that's only response - no actual mic sounds are picked up. Thought it relevant to share that oddity as it shows "something" is getting through.

The headsets are confirmed working on other devices. Used several other brands of TRRS (left, right, ground, mic) headsets. Also tried TRS (left, right, ground) to no effect. Confirmed continuity from each jack to jack mount pads to next circuit step (e.g. left-C22, right-C23, mic-C25, ground).

Thanks in advance!

jboone, 2020-04-16:
If this is not a hardware issue (PortaPack, HackRF, or headphones), the only reason I can think of would be the receiver mode. The FM receiver mode squelches when there's no or insufficient modulation present. But I imagine you've tried several different modes already.

Did this combination of hardware work at some point, or has it never worked since you received the hardware? Where did you buy the PortaPack and the HackRF?

SannhetJaeger, 2020-04-19:
Waterfall showing a solid WFM signal - cycled through other modes to no effect.  Recently received from what I understand to be reputable source on Ali.  Seller offered to exchange, but I hate to wait weeks for the process only to find it still doesn't work for some other reason (e.g. problem on HackRF board - bought bundle from seller).  Everything but headphone worked out-of-box.

Subsequently examined board under microscope and quality looks good / clean.  Test all ground and power rails / points.  Since I don't have a working board to compare in-circuit component values, I have exhausted testing unpowered.  Have to get some ribbons to test the audio chip / circuit - with slow shipping lately, will take time to get those jumpers - I don't have enough in bin.

The upside with this is getting a deep dive into the hardware and low level side.  Though, it been drinking from the fire hose these days!

Povezi, 2020-04-19:
I it the same issue like. mine: https://github.com/sharebrained/portapack-hackrf/issues/140

I suppose it is hardware problem, because it stopped working. Any idea how to fix it?

SannhetJaeger, 2020-04-20:
@Povezi I have no sound at all from headphones.  Occasionally there will be clicking in pace with one of the clocks, which unplugging and replugging headphones will eliminate.  Typically clicks will occur after repeated plugging + unplugging.  Volume levels have no impact on headphone output in my case.

Povezi, 2020-04-20:
Yes, I had sound, but in the middle of FM listening it died. Now no sound at all. Looking for a hint how to repair hardware...

serjjjz, 2020-04-21:
There was a similar problem. The microphone was working intermittently. The reason was a bad factory weeding. Fixed with a hair dryer.
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

SannhetJaeger, 2020-04-24:
Finally figured out the problem.  They surface mounted the AK4951 chip rotated 90 degrees counter clockwise.  Was hiding in plain sight the whole time.  Lesson learned - check pin positions somewhere in top 3 steps; before probing I2C, I2S and reflowing board several times...  Fortunately, the rotation does not appear to have done any damage to the chip or other circuits.

Closed 2020-04-24.

Thread 157 (2020-04-30):

Devices detected: 0 DFU, 0 HackRF

andytang123456789, 2020-04-30:
Devices detected: 0 DFU, 0 HackRF
ERROR: HackRF not found.
Please connect a HackRF One to your computer's USB port.
If using a PortaPack, please put it in HackRF mode after connecting it.
but i  am sure i have connect the hackrf one and i can  receive the radio through #SDR, but I cannot flash the firmware because the firmware cannot recognize hackrf one, even if I enter hackrf mode with portapack

Ghettopeter, 2020-05-02:
I have the same problem. I also tried putting the HackRF device in DFU mode but that did not help at all.  SDR# works fine using the same cable and the same USB port.  I am using Windows10.

philsalesses, 2020-06-06:
I am on Mac OSX 10.15.4 Catalina and have the same issue.

angelfr30, 2020-06-16:
Same problem with Windows 10.

saltchicken, 2020-09-25:
I am having the same issue on Windows 10. I can use the HackRF in SDR# when the portapack is in HackRF mode, but I am unable to flash the device. Same issue even with DFU mode.

JCarter0525, 2020-11-10:
Has anyone found a resolution to this issue yet?

rgray107918, 2020-11-28:
Same issue here.  I tried running as administrator, no dice.  I even removed the portapack board, and tried entering DFU mode in the HackRF alone, and get same issue.

I did hold down the Reset + DFU button for closer to 15 seconds, and when running the DFU file, it gave me this:

*** Run HackRF firmware in RAM via LPC DFU ***

This is used to "unbrick" your HackRF, if you are no longer able to use
HackRF tools to flash or operate your HackRF.

Connect your HackRF One to a USB port on your computer.

Hold down both the DFU and RESET buttons on the HackRF.
Then release the RESET button (closest to the edge).
Then release the DFU button.

Press any key to continue . . .

dfu-util 0.9

Copyright 2005-2009 Weston Schmidt, Harald Welte and OpenMoko Inc.
Copyright 2010-2016 Tormod Volden and Stefan Schmidt
This program is Free Software and has ABSOLUTELY NO WARRANTY
Please report bugs to http://sourceforge.net/p/dfu-util/tickets/

DFU suffix CRC does not match
A valid DFU suffix will be required in a future dfu-util release!!!
Opening DFU capable USB device...
ID 1fc9:000c
Run-time device DFU version 0100
Claiming USB DFU Interface...
Setting Alternate Setting #0 ...
Determining device status: state = dfuIDLE, status = 0
dfuIDLE, continuing
DFU mode device DFU version 0100
Device returned transfer size 2048
Copying data from PC to DFU device
Download        [=========================] 100%        22056 bytes
Download done.
unable to read DFU status after completion
can't detach
Resetting USB to switch back to runtime mode

Press any key to continue . . .

My device also works fine in SDR#.  Interestingly, it will not run on SDRAngel.  However, I don't know if that is a device issue or an SDRAngel issue.

MichaelSMVogel, 2020-12-03:
It's a driver issue - I resolved it by finding the hackrf device in the device manager and manually updating the driver. You can point it to the directory where you have the firmware downloaded. There is a driver folder. Windows tells you it already has the best driver but ignore that and choose from list - have disk - there are likely at least two versions in the list. It worked after I switched to the 2015 version.

JCarter0525, 2020-12-03:
I'll check it out and let you know. Thanks for letting me know the workaround! 

Sent from Yahoo Mail on Android

  On Thu, Dec 3, 2020 at 9:32 AM, MichaelSMVogel<notifications@github.com> wrote:

It's a driver issue - I resolved it by finding the hackrf device in the device manager and manually updating the driver. You can point it to the directory where you have the firmware downloaded. There is a driver folder. Windows tells you it already has the best driver but ignore that and choose from list - have disk - there are likely at least two versions in the list. It worked after I switched to the 2015 version.

—
You are receiving this because you commented.
Reply to this email directly, view it on GitHub, or unsubscribe.

JCarter0525, 2020-12-13:
I'm beginning to wonder if I have a defective device. I'm to the point that I'm willing to send it to someone who can complete this and pay them for their time...

MichaelSMVogel, 2020-12-13:
Did you try the driver change? I have experienced this twice now on 3 computers. Windows found a newer driver and installed it on it's own and it works as far as the hackrf is concerned bug the firmware utility can not see the hackrf.

RAMOhio, 2020-12-25:
I solved the issue by removing the PortaPack from the HackRF, flashing the firmware with the PortaPack removed, and then once that completed everything was fine.

Additional notes:
- Windows detected the HackRF only when the PortaPack was not plugged in.
- I had the battery connected to the PortaPack (not sure if this makes a difference, probably not, but I'm adding notes just in case because I don't have time to work through every scenario)
- I'm getting crashes on some features, possibly because the battery is low. I likely won't come back and update this unless someone replies (it's probably a different issue entirely, but also likely due to the battery being low), but I highly doubt it's related. If this happens and I haven't updated this message, try charging the battery if you start getting this issue especially if it's your first use.

Volleyoghurt, 2021-05-01:
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

this works for me:
https://github.com/sharebrained/portapack-hackrf/wiki/Updating%20Firmware%20Windows

YourBrothe, 2022-06-13:
> Devices detected: 0 DFU, 0 HackRF ERROR: HackRF not found. Please connect a HackRF One to your computer's USB port. If using a PortaPack, please put it in HackRF mode after connecting it. but i am sure i have connect the hackrf one and i can receive the radio through #SDR, but I cannot flash the firmware because the firmware cannot recognize hackrf one, even if I enter hackrf mode with portapack
 Can't open device Bus 002 Device 004: ID 0a5c:5800: Entity not found ans

YourBrothe, 2022-06-13:
Can't open device Bus 002 Device 004: ID 0a5c:5800: Entity not found

YourBrothe, 2022-06-13:
Can't open device Bus 002 Device 004: ID 0a5c:5800: Entity not found ans

YourBrothe, 2022-06-13:
Can't open device Bus 002 Device 004: ID 0a5c:5800: Entity not found
give me answer

Thread 160 (2020-06-06):

Cannot install portapack-hackrf firmware

philsalesses, 2020-06-06:
I am on Mac OSX Catalina 10.15.4.

I plugged the HackRF into the USB port and verified the operating system can find it. I followed instructions on HackRF repository to install the newest firmware.

```
MyComputer:build $ hackrf_info
hackrf_info version: git-43e6f99*
libhackrf version: git-43e6f99* (0.5)
Found HackRF
Index: 0
Serial number: 0000000000000000blahblah
Board ID Number: 2 (HackRF One)
Firmware Version: git-43e6f99 (API:1.04)
Part ID Number: 0xa000cb3c 0x00584763
```

Then I attached the Portapack to the HackRF One according to instructions here:
https://github.com/sharebrained/portapack-hackrf/wiki/Assembly

and again ran `$ hackrf_info` to see if it's still recognized.

It was not.

```
MyComputer:build $ hackrf_info
hackrf_info version: git-43e6f99*
libhackrf version: git-43e6f99* (0.5)
No HackRF boards found.
```

I continued anyway by downloading the firmware from this repo:
https://github.com/sharebrained/portapack-hackrf/wiki/Updating-Firmware

and followed the instructions to install the firmware on to the H1.

```
MyComputer:portapack-hackrf $ cd ~/Desktop/portapack-h1-firmware-20190405/
MyComputer:portapack-h1-firmware-20190405 $ dfu-util --device 1fc9:000c --download hackrf_usb.dfu --reset
dfu-util 0.9

Copyright 2005-2009 Weston Schmidt, Harald Welte and OpenMoko Inc.
Copyright 2010-2016 Tormod Volden and Stefan Schmidt
This program is Free Software and has ABSOLUTELY NO WARRANTY
Please report bugs to http://sourceforge.net/p/dfu-util/tickets/

dfu-util: DFU suffix CRC does not match
dfu-util: A valid DFU suffix will be required in a future dfu-util release!!!
Deducing device DFU version from functional descriptor length
Opening DFU capable USB device...
ID 1fc9:000c
Run-time device DFU version 0100
Claiming USB DFU Interface...
Setting Alternate Setting #0 ...
Determining device status: state = dfuIDLE, status = 0
dfuIDLE, continuing
DFU mode device DFU version 0100
Device returned transfer size 2048
Copying data from PC to DFU device
Download	[=========================] 100%        35188 bytes
Download done.
dfu-util: unable to read DFU status after completion
dfu-util: can't detach
Resetting USB to switch back to runtime mode
```
This last command never exits and hangs there. The lights on the HackRF go back to what looks like runtime mode. However, my computer still cannot find the HackRF connected to my USB in either runtime or DFU modes.

If I open a new terminal window while the firmware is running, and run the next command:

```
MyComputer:portapack-h1-firmware-20190405 $ hackrf_spiflash -w portapack-h1-firmware.bin
File size 325092 bytes.
hackrf_open() failed: HackRF not found (-5)
MyComputer:portapack-h1-firmware-20190405 $
```

Now I'm stuck. Please help.

philsalesses, 2020-06-06:
If I try to build the firmware from scratch, it bonks too.

Inside /firmware/CMakeList.txt I changed line 55 from
`COMMAND sleep 3s`
to
`COMMAND sleep 15s`

Then try to make firmware nad it bonks because I'm not on Debian. Macs don't have the xsvf command...

```
MyComputer:build $ make firmware
[  1%] Generating hackrf_cpld_data.cpp
/bin/sh: --xsvf: command not found
make[3]: *** [application/hackrf_cpld_data.cpp] Error 127
make[2]: *** [application/CMakeFiles/application.elf.dir/all] Error 2
make[1]: *** [CMakeFiles/firmware.dir/rule] Error 2
make: *** [firmware] Error 2
```

philsalesses, 2020-06-06:
Usually, when I plug in the portapack/HackRF into USB, it flashes white very quickly and then goes back to black. However, one or two cables I found were able to produce this screen. I have no idea how to reproduce it. Sometimes when I plug in the cable, it gives me this. It's still unrecognizable to the OS, but it's something different.

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

philsalesses, 2020-06-06:
I got it to work. Once it showed this screen, I made sure it was no longer in DFU mode and I ran

```
MyComputer:portapack-h1-firmware-20190405 $ hackrf_spiflash -w portapack-h1-firmware.bin
File size 325092 bytes.
Erasing SPI flash.
Writing 325092 bytes at 0x000000.
```
I unplugged it and then it worked. Hope this helps someone else.

eried, 2020-06-06:
What you did different to make it work? I am trying to document this type of [procedures](https://github.com/eried/portapack-mayhem/wiki/Update-firmware#alternative-environment) for beginners (my main question is if step 5 and 6 in my link would solve the problem you had - I know it is not for mac, but I guess same applies)

sck-nogas, 2020-06-07:
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

Well, this is my install "script" for Mayhem my Mac 10.15.5

alias portapak-mayhem='cd ~/src/portapack-mayhem/ && git pull && rm -rf build && git submodule update --init --recursive && export PATH=~/bin/gcc-arm-none-eabi-9-2019-q4-major/bin:${PATH} && mkdir build && cd build && cmake .. && make firmware && hackrf_spiflash -w firmware/portapack-h1_h2-mayhem.bin'

This will do all the things to keep me on the most recent git version. It's what I've been doing for several years with portapak/Havoc/Mayhem

The only thing I have to do every 9-12 months is update the ARM compilers and change the PATH entry to match the new install

bitfarmer, 2020-07-01:
Yesterday I flashed my HackRF+Portapack using my Mac and it wasn't too difficult although the normal instructions do lead to unexpected hangs.

While I do run Debian/Devuan and even Windows sometimes, I like things to just work on my Mac. I am running macOS Catalina 10.15 but the actual OS version is irrelevant here.

I placed the HackRF in DFU mode and checked it was visible to the computer:

```
dfu-util -l
```
```
Found DFU: [1fc9:000c] ver=0100, devnum=6, cfg=1, intf=0, path="20-3", alt=0, name="DFU", serial="ABCD"
```

*Somewhere in the depths of my mind I recalled this problem was previously solved by adding `--alt 0` to the dfu command. This problem did happen when I originally flashed the HackRF, even before I had a Portapack attached to it*.

Flashing it:

```
dfu-util --device 1fc9:000c --alt 0 --download hackrf_one_usb.dfu
```

and afterwards, without any intervening reset, issuing:

```
hackrf_spiflash -w portapack-h1-firmware.bin
```

worked without any problems.

I hope it will help someone who is in a bind.

EI7DKB

Stans11, 2023-06-21:
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

IM USING WINDOWS BUT GOT LINUX UBUNTU SOFTWARE BUT CANT CONNECT EITHER

Closed 2020-06-06.

Thread 163 (2020-07-24):

Is portapack-jam-mode able to jam Bluetooth and WiFi?

All3xJ, 2020-07-24:
Since hackrf can cover 20mhz of bandwidth, and Bluetooth and WiFi are wider, I was wondering if portapack can jam them with TX sweep

eried, 2020-07-24:
Probably yes, because you can select multiple ranges but I have not tried personally.

Commander-Crash, 2022-05-20:
No unless you have a serious amp attached to the hackrf.

All3xJ, 2022-05-20:
> No unless you have a serious amp attached to the hackrf.

yes I have. but how to do that?

Closed 2022-07-21.

Thread 165 (2020-08-04):

DFU suffix does not match

user5647, 2020-08-04:
when trying to upload the firmware, i get 2 messages in the DFU
1st, to connect and hold down both DFU and start ect..
After hitting return,  i get the 2nd message "dfu suffix does not match
A valid dfu suffix will be required in a future dfu- until release!!!
Deducing device dfu version from functional descriptor length
Cannot item dfu device 1fc9:000c
No dfu capable USB device available

Press any key to continue"

How do i fix this?

user5647, 2020-08-04:
Also,  i tried both the most recent version and the previous one

insidecircuits, 2020-10-02:
You need to put your board into DFU mode, follow the flashing procedure.

Thread 166 (2020-08-10):

File manager improvement when there is NO SD CARD or NO FILE on SD CARD

alain00091, 2020-08-10:
Credits to Euquiq

File manager does not crash if there is no SD CARD , or no files on SD but you have to go first on File manager intermediate screen with one button (EXIT), click on EXIT button and then you have the message NO SD or NO FILE on SD. After that File manager is terminated.
No you do not have the intermediate screen with the "EXIT" button, you get directly the messages and File manager is ended.

Thread 167 (2020-08-18):

Hardware memory button cell redundant

PapaPendragon, 2020-08-18:
When storing settings on the portapack you have to use a 1,5V back-up button-cell placed in it's holder. Then you have to sandwitch the portapack with the hackrf and put them in a casing screwing all to gether. A solution of this is to use the battery pack (3,7V) for power suppy of the settings you've made. The 3,7V battery whitch provides the whole assy with power and is rechargeable, will then also deliver the power for the 1.5V button-cell as replacement. How? solder a 22K resistor on the positive pole of the buttoncell holder and wire from the other side of the resistor to the positive pole of the connector of the 3,7V rechargeable battery. The current flow I estimated is about 1mA, so providing 1,5V for the need of remembering your settings like normally the buttoncell did this work for you. But then a time will come to replace that dammed buttoncell again. No way.  Greetz PA3CMP

jboone, 2020-08-19:
Thanks. The PortaPack H1 design in this source repository does not have a rechargeable battery. If there is another repository containing a PortaPack hardware design with a rechargeable battery, I'm sure they would appreciate your input.

PapaPendragon, 2020-08-19:
Tnx for reply,

Ok! but the hardware Portapack board (and most of them) have a coin-cell holder, and that's a hardware design item.
Neverless I don't use that and have now perfected it (the resistor of 2K2 is changed for one of 470 𝛀) and now most of all settings I've made on softwarebase are remembered. Anyway date/time and interface (UI-settings), and some settings in receive and transmit mode will remembered. But not all of them! So there lies a software design challange.
In order your suggestion, I will place an shift this repository to another fora.

Greetz Ralph

Closed 2020-08-19.

Thread 170 (2020-09-04):

HackRF only works with H2 attached....

cyb3rr0nn13, 2020-09-04:
Somehow (i dunno how) i fucked up my HackRF....
now it works well with the Mayhem FW installed, but it doesnt get recognized by
any computer, so iam not able to go back to the OFW.....

What can i do to fix this, i mean, how can i connect?
Even dfu-util seems to show me the middlefinger....WHY :(

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

Thread 172 (2020-09-26):

Cannot compile with GCC10

olewales, 2020-09-26:
Trying to compile firmware with gcc 10 yields following error:

```shell
(...)
/home/olewales/portapack-hackrf/firmware/baseband/spectrum_collector.cpp: In instantiation of 'typename T::value_type spectrum_window_hamming_3(const T&, size_t) [with T = std::array<std::complex<float>, 256>; typename T::value_type = std::complex<float>; size_t = unsigned int]':
/home/olewales/portapack-hackrf/firmware/baseband/spectrum_collector.cpp:142:79:   required from here
/home/olewales/portapack-hackrf/firmware/baseband/spectrum_collector.cpp:114:28: error: non-constant condition for static assertion
  114 |  static_assert(power_of_two(s.size()), "Array size must be power of 2");
      |                ~~~~~~~~~~~~^~~~~~~~~~
/home/olewales/portapack-hackrf/firmware/baseband/spectrum_collector.cpp:114:28: error: 's' is not a constant expression
/home/olewales/portapack-hackrf/firmware/baseband/spectrum_collector.cpp:115:19: error: 's' is not a constant expression
  115 |  constexpr size_t mask = s.size() - 1;
      |                   ^~~~
make[2]: *** [firmware/baseband/CMakeFiles/baseband_shared.dir/build.make:1135: firmware/baseband/CMakeFiles/baseband_shared.dir/spectrum_collector.cpp.obj] Error 1
make[1]: *** [CMakeFiles/Makefile2:991: firmware/baseband/CMakeFiles/baseband_shared.dir/all] Error 2
make: *** [Makefile:103: all] Error 2

```

Code may be made to compile by removing constexpr and assertion but there should be a better way to fix this

```diff
diff --git a/firmware/baseband/spectrum_collector.cpp b/firmware/baseband/spectrum_collector.cpp
index ebe55a2..dd52da2 100644
--- a/firmware/baseband/spectrum_collector.cpp
+++ b/firmware/baseband/spectrum_collector.cpp
@@ -111,8 +111,8 @@ static typename T::value_type spectrum_window_none(const T& s, const size_t i) {

 template<typename T>
 static typename T::value_type spectrum_window_hamming_3(const T& s, const size_t i) {
-       static_assert(power_of_two(s.size()), "Array size must be power of 2");
-       constexpr size_t mask = s.size() - 1;
+       //static_assert(power_of_two(s.size()), "Array size must be power of 2");
+       const size_t mask = s.size() - 1;
        // Three point Hamming window.
        return s[i] * 0.54f + (s[(i-1) & mask] + s[(i+1) & mask]) * -0.23f;
 };
```

I believe this is related to a bug fixed in GCC10: https://gcc.gnu.org/bugzilla/show_bug.cgi?id=66477

GCC version:

```console
$ arm-none-eabi-gcc -v
Using built-in specs.
COLLECT_GCC=arm-none-eabi-gcc
COLLECT_LTO_WRAPPER=/usr/lib/gcc/arm-none-eabi/10.2.0/lto-wrapper
Target: arm-none-eabi
Configured with: /build/arm-none-eabi-gcc/src/gcc-10.2.0/configure --target=arm-none-eabi --prefix=/usr --with-sysroot=/usr/arm-none-eabi --with-native-system-header-dir=/include --libexecdir=/usr/lib --enable-languages=c,c++ --enable-plugins --disable-decimal-float --disable-libffi --disable-libgomp --disable-libmudflap --disable-libquadmath --disable-libssp --disable-libstdcxx-pch --disable-nls --disable-shared --disable-threads --disable-tls --with-gnu-as --with-gnu-ld --with-system-zlib --with-newlib --with-headers=/usr/arm-none-eabi/include --with-python-dir=share/gcc-arm-none-eabi --with-gmp --with-mpfr --with-mpc --with-isl --with-libelf --enable-gnu-indirect-function --with-host-libstdcxx='-static-libgcc -Wl,-Bstatic,-lstdc++,-Bdynamic -lm' --with-pkgversion='Arch Repository' --with-bugurl=https://bugs.archlinux.org/ --with-multilib-list=rmprofile
Thread model: single
Supported LTO compression algorithms: zlib zstd
gcc version 10.2.0 (Arch Repository)
```

Thread 174 (2020-11-19):

Replaced missing parts on the H1 board yourself ?

kilohertz79, 2020-11-19:
I thought it could be a bug in my PCB of the H1-Portapack,because i have completed it with any parts that was not equipped such as the IC U6 for charging the LiIon pack and its external wiring.

I noticed that the R7 must not be equipped at all, because then the display remains dark! ????
( connection between VBUS and VBUSCONTROL)

Does any of you know what tasks R2 (#PDN) C13 and ultimately the bridge R7 have? Or is it better to remove these parts again?

Thanks in advance!

Thread 175 (2021-03-01):

i know it's been brought up before, but i can't find an answer that fixes my issue...

superchuckles, 2021-03-01:
ok, here's what i've got - hackrf, works great, correct drivers installed, etc.  bought a portapack (ver2), installed mayhem firmware.  portapack works great, except, when i put it in hackrf mode -- computer can't see it.  if i take it apart & unplug the portapack, hackrf works fine, computer  can see it, can tune in various things, etc.  plug the portapack back in, portapack works, but when i put in hackrf mode its screen turns blue with bunch of symbols on the left side & one that looks like a sine wave on the bottom right with a circle around it, but computer can't see it.  it's getting tiresome having to disassemble & reassemble it over & over.  is there some pin i can cut & manually install a switch on or something?  btw, i've tried it with original portapack firmware too, same thing

eried, 2021-03-02:
I think is a problem in the usb cable

superchuckles, 2021-03-03:
but you'd be wrong.  usb cable works just fine as soon as i unplug portapack

eried, 2021-03-03:
I remembered someone asked the same somewhere and he solved it too! haha but I cant recall. I would suggest asking in our [discord](https://discord.gg/tuwVMv3) if nobody else has a clue.

kooskwak, 2021-04-27:
Had the same problem last week. My problem was indeed the USB cable!

Thread 176 (2021-03-06):

Limit 2 MHz

Merianna, 2021-03-06:
Hi guys, I have to solve a problem, I need to display some signals at 1Mhz and at 500Hz, but hackrf does not show below 2 MHz.
How can I do?

Thanks

Luciano

Thread 177 (2021-06-21):

It's a driver issue - I resolved it by finding the hackrf device in the device manager and manually updating the driver. You can point it to the directory where you have the firmware downloaded. There is a driver folder. Windows tells you it already has the best driver but ignore that and choose from list - have disk - there are likely at least two versions in the list. It worked after I switched to the 2015 version.

401402, 2021-06-21:
It's a driver issue - I resolved it by finding the hackrf device in the device manager and manually updating the driver. You can point it to the directory where you have the firmware downloaded. There is a driver folder. Windows tells you it already has the best driver but ignore that and choose from list - have disk - there are likely at least two versions in the list. It worked after I switched to the 2015 version.

_Originally posted by @MichaelSMVogel in https://github.com/sharebrained/portapack-hackrf/issues/157#issuecomment-738081438_

401402, 2021-06-21:
it wont find it on my asus  win 10  what should i do
why is there 1st step
2nd step
3rd step
4th step
instructions   this is stupid

Thread 179 (2021-07-23):

SSTV TX EXISTS BUT SSTV RECEIVER???

Ichtyosaurus, 2021-07-23:
When sending a SSTV signal on the air there was no problem at all. But receiving is in my opinion a whole other story with the HackRF-Portapack2. My question: Is it possible to decode SSTV signals when receiving those on... for example the 2 meter HAM band or the 70 cm HAM band ?

Greetz Ralph

Ichtyosaurus, 2021-07-23:
In addiction:
Perhaps it would be nice to have a possibillity to switch in receive mode after having a transmission on the same frequency and vice-versa. I don't know if that is possible with the hackrf hardware architecture, 'cause I am a novice.
Greetz again Ralph

Ichtyosaurus, 2021-08-20:
Hello
I've found the same question at  eried /portapack-mayhem :

Receive SSTV [$125] #255
Open
gadjodilo83 opened this issue on Dec 18, 2020 · 9 comments

So I will close this one, b'cause it is under attention

Greetz Ralph

Closed 2021-08-20.

Thread 181 (2021-08-01):

in scanner app audio distorted and incomprehensible AM and NFM

lazlooose, 2021-08-01:
Hello, while using the scanner app running Mayhem 1.4.0 and 1.3.0 the audio is distorted and inaudible if I switch to the audio receive mode it works fine but the audio in the scanner app after it locks to a station is horribly distorted and quiet.   this is true of AM (DSB - CB band) and NFM (FRS Band).  has anyone else had this problem?

lazlooose, 2021-08-01:
sorry I meant to post this to the Mayhem Fork. doing so now.

Thread 184 (2022-05-03):

black screen on portapack H2 after firmware update

adammanella, 2022-05-03:
updated to 1.5.1 and now I have a black screen on my H2.
tried the nightly build as well with the same issue.
anyone having similar issues?
I am running OSX
Thank you,
A

adammanella, 2022-05-03:
the only issue I was getting came after flashing in dfu mode......

dfu-util: unable to read DFU status after completion (LIBUSB_ERROR_IO)

adammanella, 2022-05-03:
SOLVED!

If your device won't boot and leaves you on a black screen, then you will need to power off the device and then hold down the LEFT button while you power it on. This could take up to 10 seconds.

https://github.com/eried/portapack-mayhem/wiki/Won't-boot

mikachuman, 2022-11-28:
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

Tried this and now instead of a black screen, I'm seeing white only. H1

Thread 191 (2023-09-05):

TPMS app not decoding Toyota Prius Prine sensors

ifuchs, 2023-09-05:
I am trying to read my Prius prime 2022 TPMS sensors without any success. I can see that there is a transmission when I use the audio or the capture modes but the TPMS app doesn’t show anything. I have tested with an RTL_SDR (rtl_433 – f 315M – m level) and it works fine, decoding the TPMS and showing the pressure. and temperature properly.

helmarw, 2023-09-05:
please check here for latest info, could be the same issue but its not solved yet
https://github.com/eried/portapack-mayhem/issues/879

ifuchs, 2023-09-05:
Yes, that does appear to be the same problem. I guess RTL_433 can deal with these sensors while the Portapack app cannot.

Thread 193 (2023-12-04):

portapack firmware is not compatible with hackrf sweep but works with other software

sohmee, 2023-12-04:
If I put my portapack into hackrf mode and try to run hackrf_sweep_spectrum_analyzer under windows 11 it does not work.

 it only works when I use firmware hackrf-2018.01.1

other software eg. sdr console or sdr sharp work fine with the portapack firmware.

is there anyway of getting hackrf sweep to work without changing the driver back to hackrf-2018.01.1?

Thanks
