sharebrained/portapack-hackrf/firmware/application/main.cpp

/*
 * Copyright (C) 2014 Jared Boone, ShareBrained Technology, Inc.
 *
 * This file is part of PortaPack.
 *
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
 * You should have received a copy of the GNU General Public License
 * along with this program; see the file COPYING.  If not, write to
 * the Free Software Foundation, Inc., 51 Franklin Street,
 * Boston, MA 02110-1301, USA.
 */

#include "ch.h"

#include "portapack.hpp"
#include "portapack_shared_memory.hpp"

#include "message_queue.hpp"

#include "ui.hpp"
#include "ui_widget.hpp"
#include "ui_painter.hpp"
#include "ui_navigation.hpp"

#include "irq_lcd_frame.hpp"
#include "irq_controls.hpp"
#include "irq_rtc.hpp"

#include "event_m0.hpp"

#include "core_control.hpp"
#include "spi_image.hpp"

#include "debug.hpp"
#include "led.hpp"

#include "gcc.hpp"

#include "sd_card.hpp"

#include <string.h>

static void event_loop() {
	ui::Context context;
	ui::SystemView system_view {
		context,
		portapack::display.screen_rect()
	};

	EventDispatcher event_dispatcher { &system_view, context };
	MessageHandlerRegistration message_handler_display_sleep {
		Message::ID::DisplaySleep,
		[&event_dispatcher](const Message* const) {
			event_dispatcher.set_display_sleep(true);
		}
	};

	event_dispatcher.run();
}

int main(void) {
	if( portapack::init() ) {
		portapack::display.init();

		sdcStart(&SDCD1, nullptr);

		controls_init();
		lcd_frame_sync_configure();
		rtc_interrupt_enable();

		event_loop();

		sdcDisconnect(&SDCD1);
		sdcStop(&SDCD1);

		portapack::shutdown();
	}

	m4_init(portapack::spi_flash::image_tag_hackrf, portapack::memory::map::m4_code_hackrf, true);
	m0_halt();

	return 0;
}
