sharebrained/portapack-hackrf/firmware/application/receiver_model.hpp

/*
 * Copyright (C) 2015 Jared Boone, ShareBrained Technology, Inc.
 *
 * This file is part of PortaPack.
 *
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
 * You should have received a copy of the GNU General Public License
 * along with this program; see the file COPYING.  If not, write to
 * the Free Software Foundation, Inc., 51 Franklin Street,
 * Boston, MA 02110-1301, USA.
 */

#ifndef __RECEIVER_MODEL_H__
#define __RECEIVER_MODEL_H__

#include <cstdint>
#include <cstddef>

#include "message.hpp"
#include "rf_path.hpp"
#include "max283x.hpp"
#include "volume.hpp"

class ReceiverModel {
public:
	enum class Mode {
		AMAudio = 0,
		NarrowbandFMAudio = 1,
		WidebandFMAudio = 2,
		SpectrumAnalysis = 3,
	};

	rf::Frequency tuning_frequency() const;
	void set_tuning_frequency(rf::Frequency f);

	rf::Frequency frequency_step() const;
	void set_frequency_step(rf::Frequency f);

	bool antenna_bias() const;
	void set_antenna_bias(bool enabled);

	bool rf_amp() const;
	void set_rf_amp(bool enabled);

	int32_t lna() const;
	void set_lna(int32_t v_db);

	uint32_t baseband_bandwidth() const;
	void set_baseband_bandwidth(uint32_t v);

	int32_t vga() const;
	void set_vga(int32_t v_db);

	int32_t tx_gain() const;
	void set_tx_gain(int32_t v_db);
	
	uint32_t sampling_rate() const;
	void set_sampling_rate(uint32_t v);

	Mode modulation() const;
	void set_modulation(Mode v);

	volume_t headphone_volume() const;
	void set_headphone_volume(volume_t v);

	void enable();
	void disable();

	size_t am_configuration() const;
	void set_am_configuration(const size_t n);

	size_t nbfm_configuration() const;
	void set_nbfm_configuration(const size_t n);

	size_t wfm_configuration() const;
	void set_wfm_configuration(const size_t n);

private:
	rf::Frequency frequency_step_ { 25000 };
	bool enabled_ { false };
	bool rf_amp_ { false };
	bool antenna_bias_ { false };
	int32_t lna_gain_db_ { 32 };
	uint32_t baseband_bandwidth_ { max283x::filter::bandwidth_minimum };
	int32_t vga_gain_db_ { 32 };
	int32_t tx_gain_db_ { 47 };
	Mode mode_ { Mode::NarrowbandFMAudio };
	uint32_t sampling_rate_ { 3072000 };
	size_t am_config_index = 0;
	size_t nbfm_config_index = 0;
	size_t wfm_config_index = 0;
	volume_t headphone_volume_ { -43.0_dB };

	int32_t tuning_offset();

	void update_tuning_frequency();
	void update_antenna_bias();
	void update_rf_amp();
	void update_lna();
	void update_baseband_bandwidth();
	void update_vga();
	void update_tx_gain();
	void update_sampling_rate();
	void update_headphone_volume();

	void update_modulation();
	void update_am_configuration();
	void update_nbfm_configuration();
	void update_wfm_configuration();
};

#endif/*__RECEIVER_MODEL_H__*/
