sharebrained/portapack-hackrf/firmware/application/firmware_info.c

#include "../../hackrf/firmware/common/firmware_info.h"
#include "../../hackrf/firmware/common/platform_detect.h"

#define SUPPORTED_PLATFORM (PLATFORM_HACKRF1_OG | PLATFORM_HACKRF1_R9)
#define DFU_MODE_VALUE 0

__attribute__((section(".firmware_info"))) const struct firmware_info_t firmware_info = {
        .magic = "HACKRFFW",
        .struct_version = 1,
        .dfu_mode = DFU_MODE_VALUE,
        .supported_platform = SUPPORTED_PLATFORM,
        .version_string = VERSION_STRING,
};
