sharebrained/portapack-hackrf/firmware/application/ui_setup.hpp

/*
 * Copyright (C) 2015 Jared Boone, ShareBrained Technology, Inc.
 *
 * This file is part of PortaPack.
 *
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
 * You should have received a copy of the GNU General Public License
 * along with this program; see the file COPYING.  If not, write to
 * the Free Software Foundation, Inc., 51 Franklin Street,
 * Boston, MA 02110-1301, USA.
 */

#ifndef __UI_SETUP_H__
#define __UI_SETUP_H__

#include "ui_widget.hpp"
#include "ui_menu.hpp"
#include "ui_navigation.hpp"

#include <cstdint>

namespace ui {

struct SetDateTimeModel {
	uint16_t year;
	uint8_t month;
	uint8_t day;
	uint8_t hour;
	uint8_t minute;
	uint8_t second;
};

class SetDateTimeView : public View {
public:
	SetDateTimeView(NavigationView& nav);

	void focus() override;

private:
	Text text_title {
		{ 10 * 8, 7 * 16, 9 * 16, 16 },
		"Date/Time"
	};

	NumberField field_year {
		{ 4 * 8, 9 * 16 },
		4,
		{ 2015, 2099 },
		1,
		'0',
	};
	Text text_slash1 {
		{ 8 * 8, 9 * 16, 1 * 8, 16 },
		"/",
	};
	NumberField field_month {
		{ 9 * 8, 9 * 16 },
		2,
		{ 1, 12 },
		1,
		'0',
	};
	Text text_slash2 {
		{ 11 * 8, 9 * 16, 1 * 8, 16 },
		"/",
	};
	NumberField field_day {
		{ 12 * 8, 9 * 16 },
		2,
		{ 1, 31 },
		1,
		'0',
	};

	NumberField field_hour {
		{ 15 * 8, 9 * 16 },
		2,
		{ 0, 23 },
		1,
		'0',
	};
	Text text_colon1 {
		{ 17 * 8, 9 * 16, 1 * 8, 16 },
		":"
	};
	NumberField field_minute {
		{ 18 * 8, 9 * 16 },
		2,
		{ 0, 59 },
		1,
		'0',
	};
	Text text_colon2 {
		{ 20 * 8, 9 * 16, 1 * 8, 16 },
		":",
	};
	NumberField field_second {
		{ 21 * 8, 9 * 16 },
		2,
		{ 0, 59 },
		1,
		'0',
	};

	Text text_format {
		{ 4 * 8, 11 * 16, 19 * 8, 16 },
		"YYYY/MM/DD HH:MM:SS",
	};

	Button button_ok {
		{ 4 * 8, 13 * 16, 8 * 8, 24 },
		"OK",
	};
	Button button_cancel {
		{ 18 * 8, 13 * 16, 8 * 8, 24 },
		"Cancel",
	};

	void form_init(const SetDateTimeModel& model);
	SetDateTimeModel form_collect();
};

struct SetFrequencyCorrectionModel {
	int8_t ppm;
};

class SetFrequencyCorrectionView : public View {
public:
	SetFrequencyCorrectionView(NavigationView& nav);

	void focus() override;

private:
	Text label_source {
		{ (240 - 16 * 8) / 2, 2 * 16, 30 * 8, 16 },
		"Reference Source"
	};

	Text value_source {
		{ (240 -  9 * 8) / 2, 4 * 16, 30 * 8, 16 },
		"---"
	};

	Text value_source_frequency {
		{ (240 - 11 * 8) / 2, 5 * 16, 30 * 8, 16 },
		"---"
	};

	Text label_correction {
		{ 5 * 8, 7 * 16, 20 * 8, 16 },
		"Frequency Correction"
	};

	NumberField field_ppm {
		{ 11 * 8, 9 * 16 },
		3,
		{ -50, 50 },
		1,
		'0',
	};
	Text text_ext {
		{ 11 * 8, 9 * 16, 9 * 8, 16 },
		"External",
	};
	Text label_ppm {
		{ 15 * 8, 9 * 16, 3 * 8, 16 },
		"PPM",
	};

	Button button_ok {
		{ 4 * 8, 13 * 16, 8 * 8, 24 },
		"OK",
	};
	Button button_cancel {
		{ 18 * 8, 13 * 16, 8 * 8, 24 },
		"Cancel",
	};

	void form_init(const SetFrequencyCorrectionModel& model);
	SetFrequencyCorrectionModel form_collect();
};

class AntennaBiasSetupView : public View {
public:
	AntennaBiasSetupView(NavigationView& nav);

	void focus() override;

private:
	Text text_title {
		{ 5 * 8, 3 * 16, 20 * 8, 16 },
		"Antenna Bias Voltage"
	};

	Text text_description_1 {
		{ 24, 6 * 16, 24 * 8, 16 },
		"CAUTION: Ensure that all"
	};

	Text text_description_2 {
		{ 28, 7 * 16, 23 * 8, 16 },
		"devices attached to the"
	};

	Text text_description_3 {
		{  8, 8 * 16, 28 * 8, 16 },
		"antenna connector can accept"
	};

	Text text_description_4 {
		{ 68, 9 * 16, 13 * 8, 16 },
		"a DC voltage!"
	};

	OptionsField options_bias {
		{ 100, 12 * 16 },
		5,
		{
			{ " Off ", 0 },
			{ " On  ", 1 },
		}
	};

	Button button_done {
		{ 72, 15 * 16, 96, 24 },
		"Done"
	};
};

class AboutView : public View {
public:
	AboutView(NavigationView& nav);

	void focus() override;

private:
	Text text_title {
		{ 100, 96, 40, 16 },
		"About",
	};

	Text label_version {
		{ 0, 128, 240, 16 },
		"Firmware Version",
	};

	Text text_version {
		{ 0, 144, 240, 16 },
		"",
	};
/*
	Text text_cpld_hackrf {
		{ 0, 144, 11*8, 16 },
		"HackRF CPLD",
	};

	Text text_cpld_hackrf_status {
		{ 240 - 3*8, 144, 3*8, 16 },
		"???"
	};
*/
	Button button_ok {
		{ 72, 192, 96, 24 },
		"OK"
	};
};

class SetupMenuView : public MenuView {
public:
	SetupMenuView(NavigationView& nav);
};

} /* namespace ui */

#endif/*__UI_SETUP_H__*/
