sharebrained/portapack-hackrf/(commit log)

2018-08-05 Power: Turn off additional peripheral clock branches.
2018-08-20 Update schematic with new symbol table and KiCad standard symbols. Fix up wires.
    [audio.sch, hackrf_if.sch, lcd_sw_sd.sch, portapack_h1.sch, power.sch]
2018-08-20 Schematic: Update power net labels.
    [hackrf_if.sch, lcd_sw_sd.sch, power.sch]
2018-08-20 Schematic: Update footprint names to match library changes.
    [audio.sch, hackrf_if.sch, lcd_sw_sd.sch, power.sch]
2018-08-20 Schematic: Update header vendor and part numbers.
    [hackrf_if.sch]
2018-08-20 Schematic: Specify (arbitrary) value for PDN# net.
    [audio.sch]
2018-08-20 Schematic: Remove fourth fiducial. Not standard practice, and was taking up valuable board space.
    [portapack_h1.sch]
2018-08-20 Schematic: Add reference oscillator -- options for clipped sine or HCMOS output.
    [hackrf_if.sch, portapack_h1.sch, power.sch]
2018-08-20 Schematic: Update copyright year.
    [audio.sch, hackrf_if.sch, lcd_sw_sd.sch, portapack_h1.sch, power.sch]
2018-08-20 Schematic: Remove CLKOUT to CPLD. It was a half-baked idea.
    [hackrf_if.sch]
2018-08-20 Schematic: Add (experimental) GPS circuit. Add note about charging circuit. Update date and revision to match PCB.
    [audio.sch, gps.sch, hackrf_if.sch, lcd_sw_sd.sch, portapack_h1.sch, power.sch]
2018-08-20 PCB: Update from schematic change: now revision 20180819. Diff was extensive due to net renumbering...
    [portapack_h1.kicad_pcb]
2018-08-20 PCB: Fix GPS courtyard to accommodate crazy solder paste recommendation in integration manual. PCB: Address DRC clearance violation between via and oscillator pad.
    [portapack_h1.kicad_pcb]
2018-08-20 PCB: Update copyright on drawing.
    [portapack_h1.kicad_pcb]
2018-08-20 Update schematic and PCB date and revision.
    [audio.sch, gps.sch, hackrf_if.sch, lcd_sw_sd.sch, portapack_h1.kicad_pcb, portapack_h1.sch, power.sch]
2018-08-26 Power: Power up or power down peripheral clock at appropriate times, so firmware doesn't freeze...
    [portapack.cpp]
2018-08-26 Clocking: Fix incorrect shift for CGU IDIVx_CTRL.PD field.
    [clock_manager.cpp]
2018-08-26 Power: Switch off unused IDIV dividers. Make note of active IDIVs and their use.
2018-09-13 MAX V CPLD: Add BYPASS, SAMPLE support. Rename enter_isp -> enable, exit_isp -> disable. Use SAMPLE at start of flash process, which somehow addresses the problem where CFM wouldn't load into SRAM (a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
2018-09-14 CPLD: After reprogramming flash, immediately clamp I/O signals, load to SRAM, and "execute" the new bitstream.
2018-09-14 Si5351: Refactor code, make one of the registers more type-safe. Clock Manager: Track selected reference clock source for later use in user interface.
2018-09-15 Clock Generator: Add a couple more setter methods for ClockControl registers.
2018-09-15 Clock Manager: Reduce MCU CLKIN driver current. 2mA should be plenty.
2018-09-17 Clock Manager: Reverse sense of conditional that determines crystal or non-crystal reference source. This is for an expected upcoming change where multiple external options can be differentiated.
    [clock_manager.cpp]
2018-09-17 Clock Manager: Use IDIVA for clock source for all peripherals, instead of PLL1. Should make switching easier going forward. Don't use IRC as clock during initial clock manager configuration. Until we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
2018-09-18 PortaPack IO: Expose method to set reference oscillator enable pin.
2018-09-28 Pin configuration: Do SPIFI pin config with other pins, in preparation for eliminating separate bootloader.
2018-09-28 Pin configuration: Disable input buffers on pins that are never read.
2018-10-10 PCB: Change PCB stackup, Tg, clarify solder mask color, use more metric.
    [portapack_h1.kicad_pcb]
2018-10-10 PCB: Move HackRF header P9 to B.CrtYd layer.
    [portapack_h1.kicad_pcb]
2018-10-10 PCB: Change a Tg reference I missed.
    [portapack_h1.kicad_pcb]
2018-10-24 PCB: Update footprints for parts with mismatched CAD->tape rotation. Adjust a few layer choice and line thickness bits.
    [portapack_h1.kicad_pcb]
2018-10-24 PCB: Got cold feet, switched back to rectangular pads.
    [portapack_h1.kicad_pcb]
2018-10-24 PCB: Add Eco layers to be visible and Gerber output.
    [portapack_h1.kicad_pcb]
2018-10-24 PCB: Use aux origin for plotting, for tidier coordinates.
    [portapack_h1.kicad_pcb]
2018-10-24 PCB: Output Gerber job file, because why not?
    [portapack_h1.kicad_pcb]
2018-10-25 Schematic: Correct footprints for two reference-related components.
    [power.sch]
2018-10-25 Schematic: Remove manfuacturer and part number for DNP component.
    [power.sch]
2018-10-25 Schematic: Specify resistor value, manufacturer, part number for reference oscillator series termination.
    [power.sch]
2018-10-25 PCB: Update netlist and footprints from schematic.
    [portapack_h1.kicad_pcb]
2018-10-25 Netlist: Updated component values, footprints.
2018-10-25 PCB: Nudge some components and traces to address DRC clearance violations.
    [portapack_h1.kicad_pcb]
2018-10-25 PCB: Allow KiCad to update zone timestamps (again?!).
    [portapack_h1.kicad_pcb]
2018-10-25 PCB: Generate *all* Gerber layers.
    [portapack_h1.kicad_pcb]
2018-10-25 Schematic, PCB: Update revision to 20181025.
    [audio.sch, gps.sch, hackrf_if.sch, lcd_sw_sd.sch, portapack_h1.kicad_pcb, portapack_h1.sch, power.sch]
2018-10-25 PCB: Adjust fab layer annotations orientation and font size.
    [portapack_h1.kicad_pcb]
2018-10-25 PCB: Hide mounting hole reference designators on silk layer.
    [portapack_h1.kicad_pcb]
2018-10-28 PCB: Shrink U1, U3 pads to get 0.2mm space between pads.
    [portapack_h1.kicad_pcb]
2018-10-29 PCB: Set pad-to-mask clearance to zero, leave up to fab. Set minimum mask web to 0.2mm for non-black options.
    [portapack_h1.kicad_pcb]
2018-10-29 PCB: Revise U1 pad shape, mask, paste, thermal drills. Clearance is improved at corner pads.
    [portapack_h1.kicad_pcb]
2018-10-29 PCB: Tweak U3 for better thermal pad/drill/mask/paste design.
    [portapack_h1.kicad_pcb]
2018-10-29 PCB: Change solder mask color to blue.
    [portapack_h1.kicad_pcb]
2018-10-29 Schematic, PCB: Update revision to 20181029.
    [audio.sch, gps.sch, hackrf_if.sch, lcd_sw_sd.sch, portapack_h1.kicad_pcb, portapack_h1.sch, power.sch]
2018-10-29 PCB: Bump minimum mask web down a tiny bit because KiCad is having trouble with math.
    [portapack_h1.kicad_pcb]
2018-12-03 Update schematic
2018-12-04 Remove unused board files.
2018-12-04 chibios: Replace code with per-peripheral structs defining clocks, interrupts, and reset bits.
2018-12-05 HAL: Explicitly turn on timer peripheral clocks used as systicks, during init.
2018-12-05 SCU: Add struct to hold pin configuration.
2018-12-06 PAL/board: New IO initialization code
    Declare initial state for SCU pin config, GPIOs. Apply initial state during PAL init. Perform VAA slow turn-on to address The Glitch.
    [board.c]
2018-12-06 Merge M0 and M4 to eliminate need for bootstrap firmware
    During _early_init, detect if we're running on the M4 or M0.
    If M4: do M4-specific core initialization, reset peripherals, speed up SPIFI clock, start M0, go to sleep.
    If M0: do all the other things.
    [portapack.cpp]
2018-12-06 Setup: Display reference source, frequency in frequency correction screen.
    [ui_setup.cpp, ui_setup.hpp]
2018-12-07 Serial: Cut-and-paste error in structure type name.
2018-12-07 VAA power: Move code to HackRF board file
    It doesn't belong in PAL.
    [board.c]
2018-12-07 MAX5 CPLD: Add SAMPLE and EXTEST methods.
2018-12-15 Clock Manager: Remove PLL1 power down function.
2018-12-15 Move and rename peripherals reset function to board module.
    [board.c]
2018-12-15 Clock Manager: Extract switch to IRC into separate function.
2018-12-15 Move initialization to board module.
2018-12-15 ChibiOS: Rename "application" board, add "baseband" board.
    There are now two ChibiOS "boards", one which runs the application and does the hardware setup. The other board, "baseband", does very little setup.
2018-12-15 Reset peripherals on app shutdown.
    Be careful not to reset M0APP (the core we're running on) or GPIO (which is holding the hardware in a stable state).
    [portapack.cpp]
2018-12-17 Application board: hide the peripherals_reset function, as it isn't useful except during hardware init.
2018-12-17 Migrate some startup code to application board.
2018-12-19 GPIO: Set SPIFI CS pin to match input buffer state coming out of bootloader.
2018-12-19 Change application board.c to .cpp, with required dependent changes
2018-12-19 Board: Clean up SCU configuration code/data.
2018-12-22 Controls: Save and expose raw navigation wheel switch state
    I need to do some work on debouncing and ignoring simultaneous key presses.
2018-12-22 Controls: Add debug view for switches state.
2018-12-22 Controls: Ignore all key presses until all keys are released.
    This should address some mechanical quirks of the navigation wheel used on the PortaPack.
2018-12-29 Clock Manager: Wait for only the necessary PLL to lock.
    Wasn't working on PortaPacks without a built-in clock reference, as that uses the other PLL.
    TODO: Switching PLLs may be kind of pointless now...
2018-12-31 ldscript: Enlarge M0 flash region to 1Mbyte, the size of the HackRF SPI flash.
2019-02-16 Pin config: VREGMODE=1, add other pins for completeness, comment detail
2019-02-16 Pin setup: More useful comments.
2019-02-16 Pin setup: Change some defaults, only set up PortaPack pins if detected.
2019-02-16 Pin setup: Disable LPC pull-ups on PP CPLD data bus, as CPLD is pulling up.
2019-03-21 Clock generator: Match clock output currents to HackRF firmware.
    Someday, we will share a code base again...
2019-03-28 Travis-CI: OK, the gcc-arm-none-eabi package is NOT current. Undoing...
2019-04-05 Power: Keep 1V8 off until after VAA is brought up.
2019-04-05 Power: Bring up VAA in several steps to keep voltage swing small.
2020-05-28 Stop the current recording on_hide()
2023-01-19 Clock Manager: Store correct crystal frequency.
    This corrects the frequency displayed in Setup.
    [clock_manager.cpp]
2023-01-27 Perform full peripheral reset for HackRF mode.
    When exiting PortaPack and passing total control to alternative firmware
    it can be helpful to restore the reset state as much as possible. The
    peripheral reset includes both the M4 and M0, but the M0 is not
    immediately reset as it requires an additional register write.
    [baseband_api.cpp, main.cpp]
2023-01-27 Track mixer and baseband inversion separately.
2023-01-27 Add MAX2839 driver.
2023-01-27 Remove duplicated initial SCU configurations.
    The init() method on Pin was never called, and the configuration data
    stored in _initial_config was never used. The initial SCU settings that
    are actually used at startup are the ones in pal_default_config.
2024-01-02 Update README.md
    Prepare to archive this repo. Leave comments about the current status of this project and the PortaPack as a ShareBrained product.
