sharebrained/portapack-hackrf/(notices)

Notices in the files:
hardware/portapack_h1/portapack_h1.kicad_pcb:
Copyright (c) 2014-2018 Jared Boone
